kefernandez/SSB_ChargeInjection/Figures/ChargeInjection_Hardware_Declasify.png

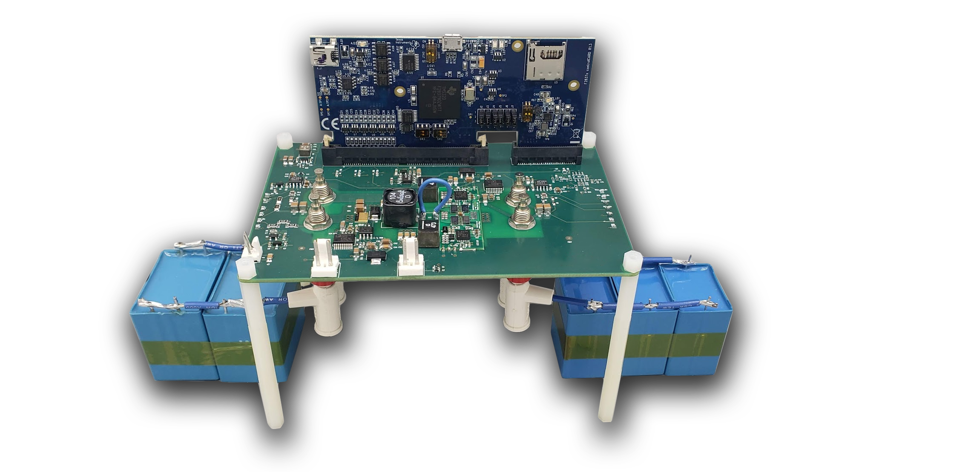
Figures/ChargeInjection_Hardware_Declasify.png
