kefernandez/SSB_ChargeInjection/Figures/Hardware_Diagram_labeled_declassify.png

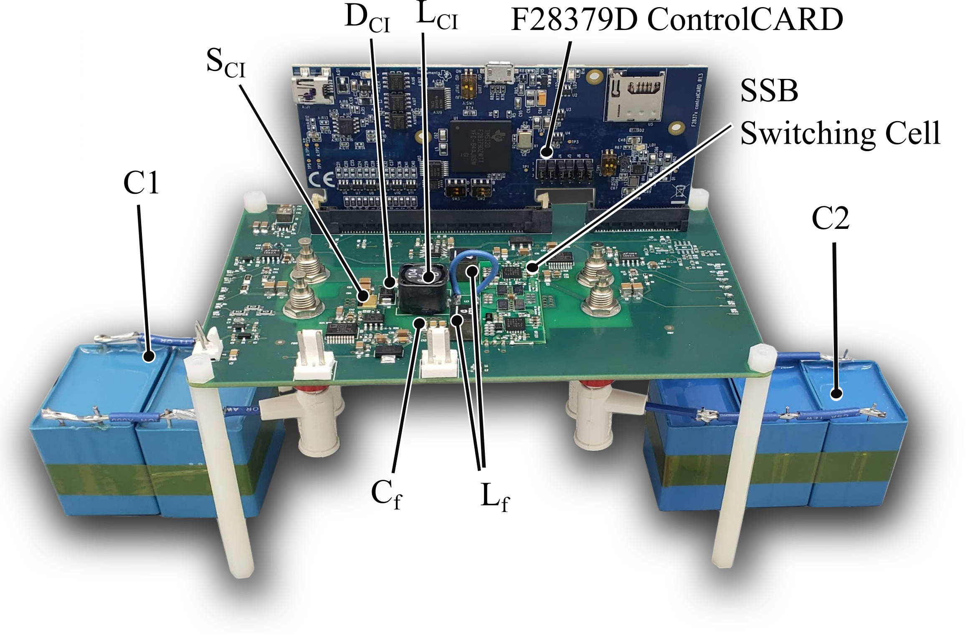
Figures/Hardware_Diagram_labeled_declassify.png
