kefernandez/SSB_ChargeInjection/Figures/Hardware_Diagram.pdf

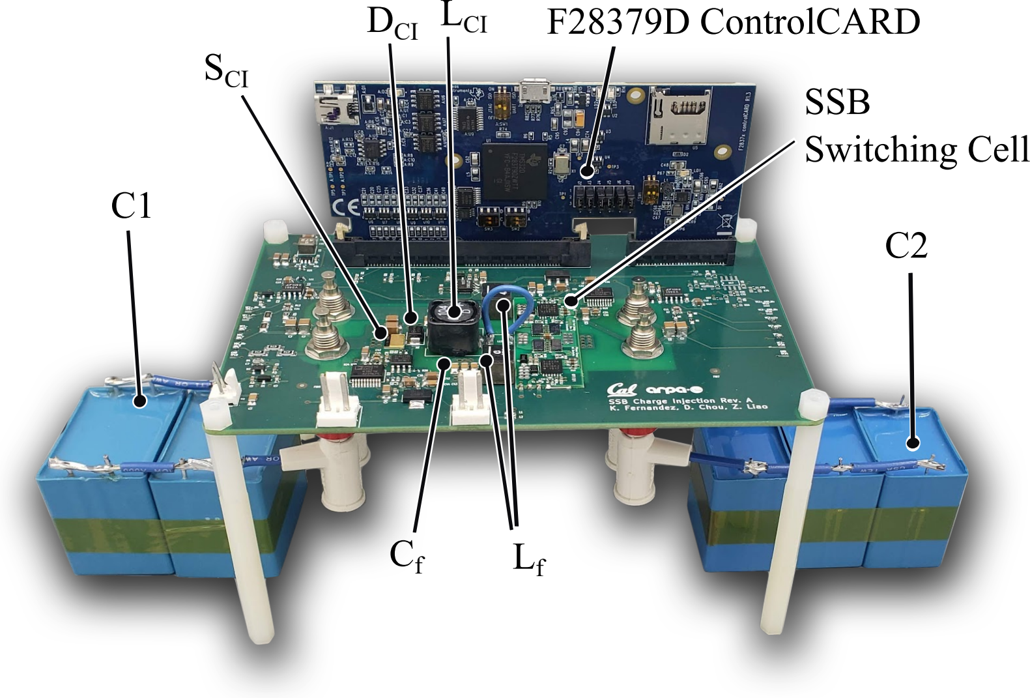
[picture p3: page 1]

F28379D ControlCARD

C2

C1

SCI

DCI LCI

Cf Lf

SSB
Switching Cell
