kefernandez/SSB_ChargeInjection/Graphics/Charge Injection/InkScape/ChargeInjection_Hardware.pdf

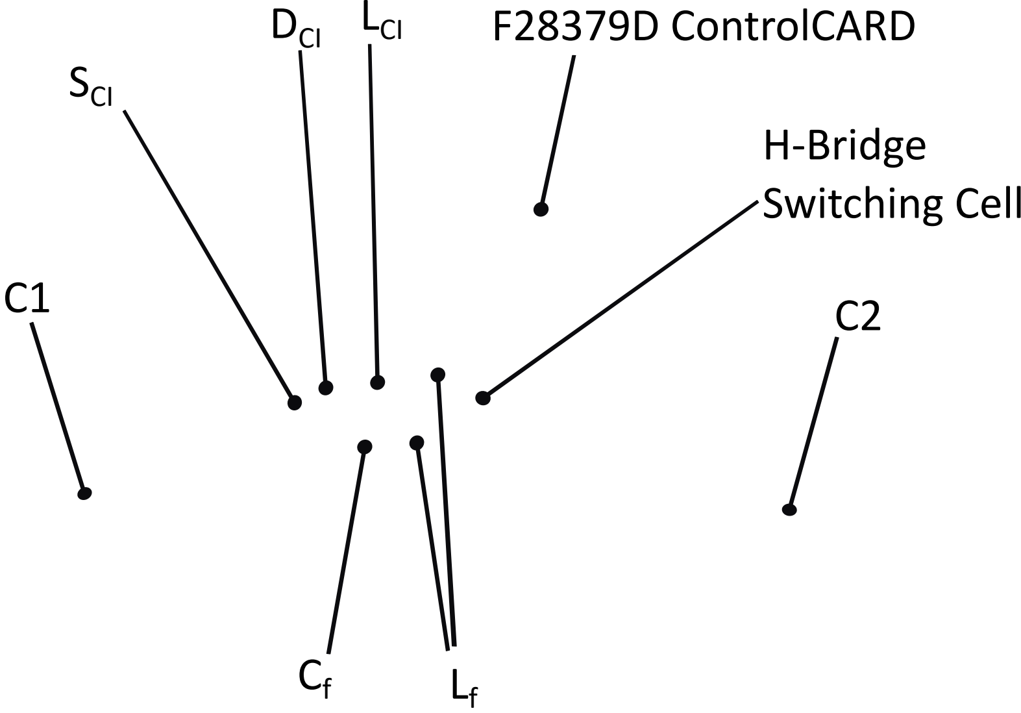
[picture p4: page 1]

F28379D ControlCARD

C2 C1

SCI

DCI | LCI
Cf | Lf

H-Bridge
Switching Cell
