kefernandez/SSB_ChargeInjection/Graphics/Charge Injection/Visio/singlephase_architecture.pdf

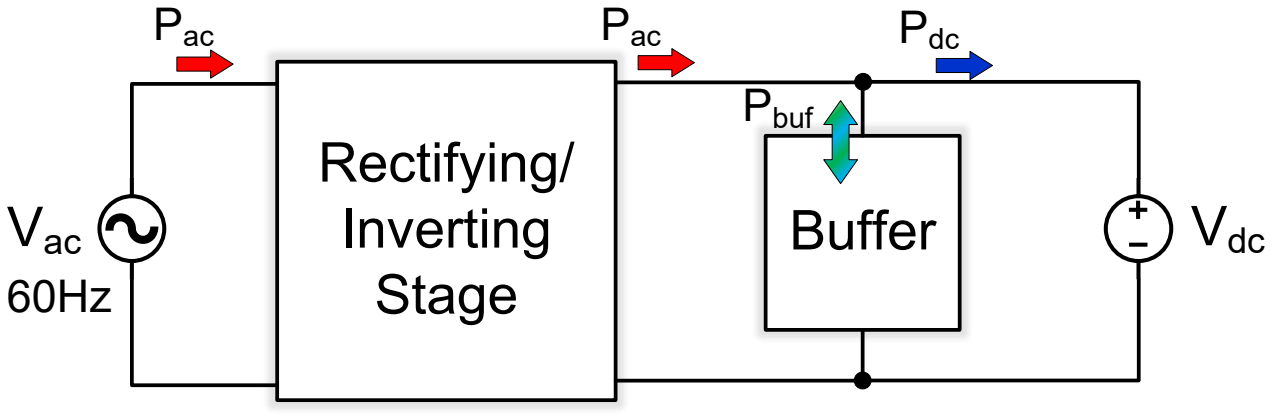
[picture p6: figure]
Rectifying/ Inverting Stage; Vac; Buffer; Vdc; Pac; Pbuf; Pdc
