kefernandez/SSB_ChargeInjection/Graphics/Charge Injection/Visio/SSB_Schematic_wave.pdf

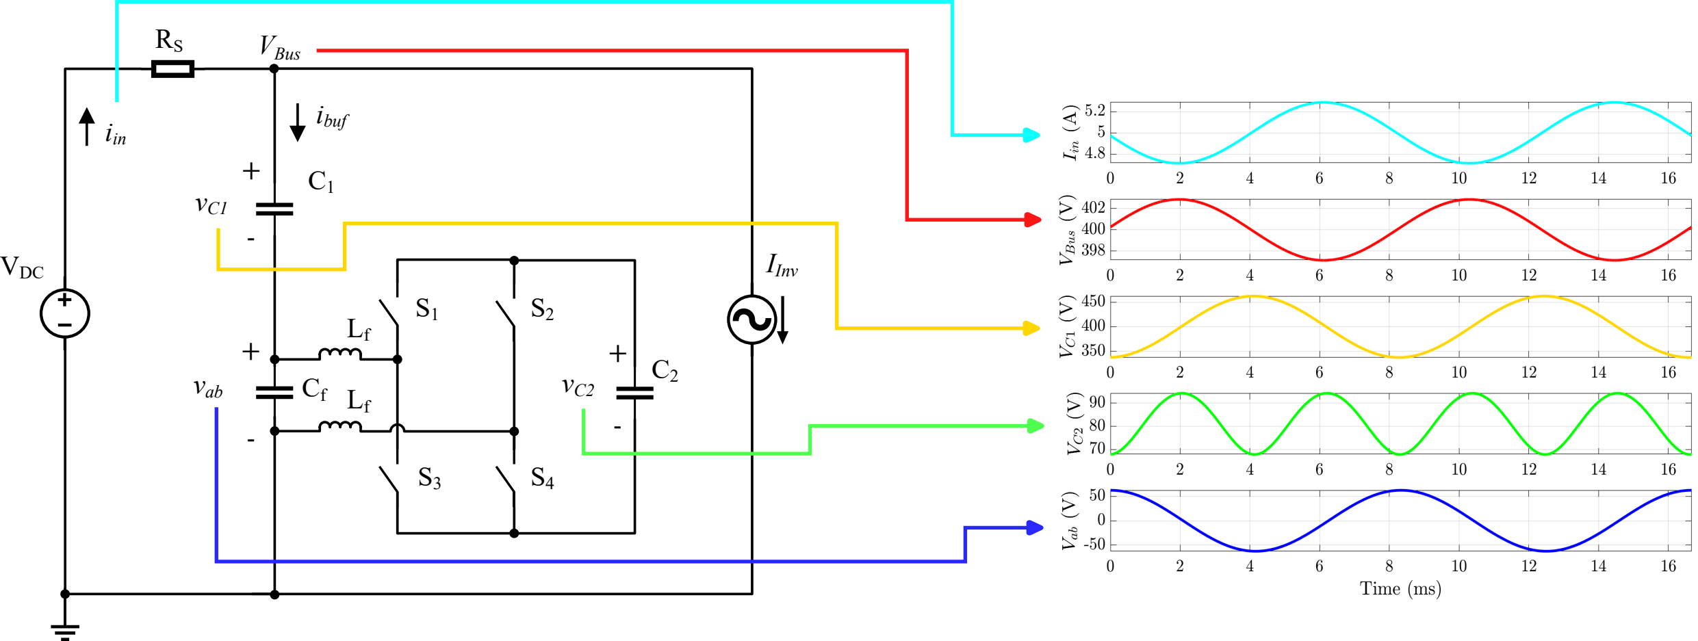
[picture p7: figure]
VDC; IInv; vab; VBus; ibuf iin
