kefernandez/SSB_ChargeInjection/Buffer/Buffer - Rev D Diagram.pdf

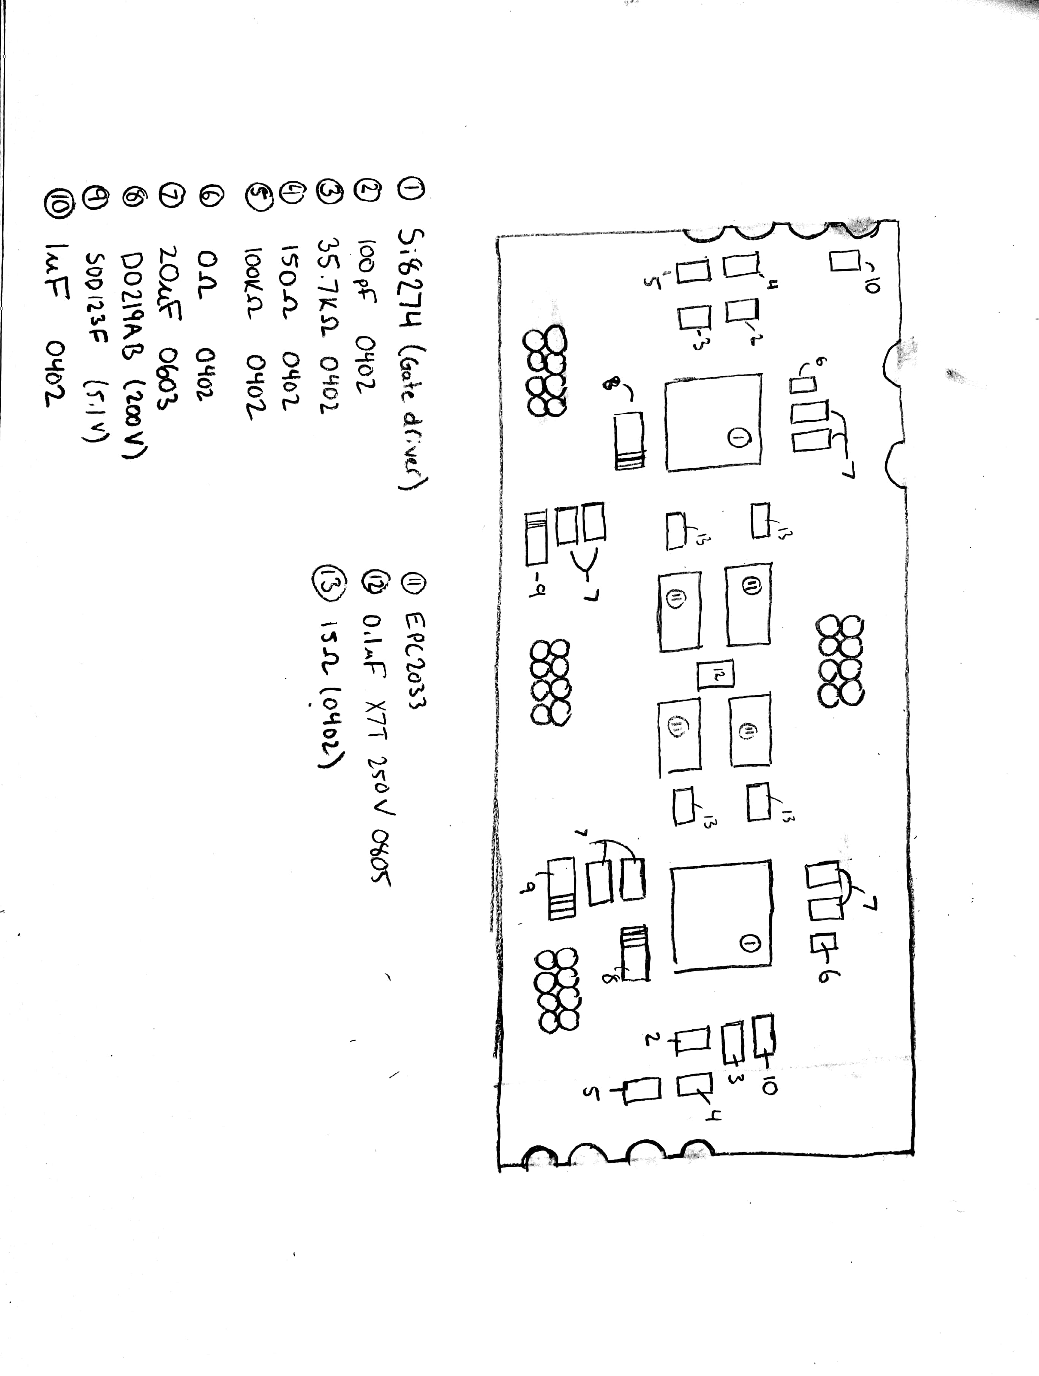
[picture p8: page 1]
