kefernandez/SSB_ChargeInjection/Graphics/Charge Injection/Visio/resistordivider.pdf

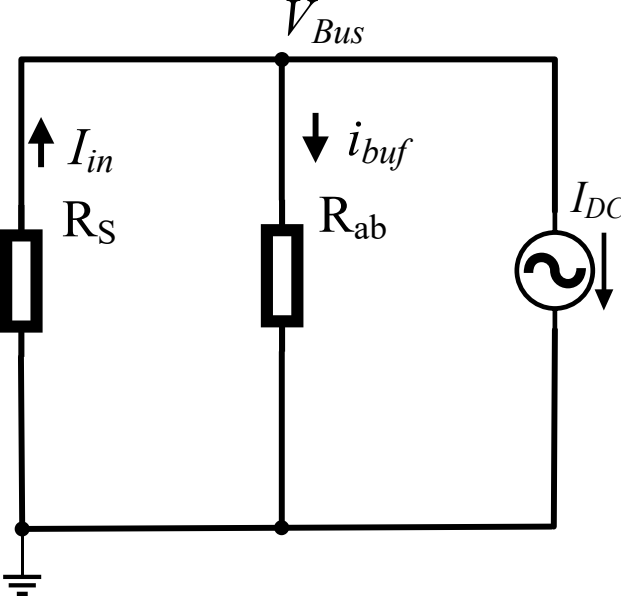
[picture p9: figure]
VBusibuf Rab; Iin

### IDC sin(ω2Lt )
