kefernandez/SSB_ChargeInjection/Graphics/Charge Injection/Visio/SSB_ResistorDivider.pdf

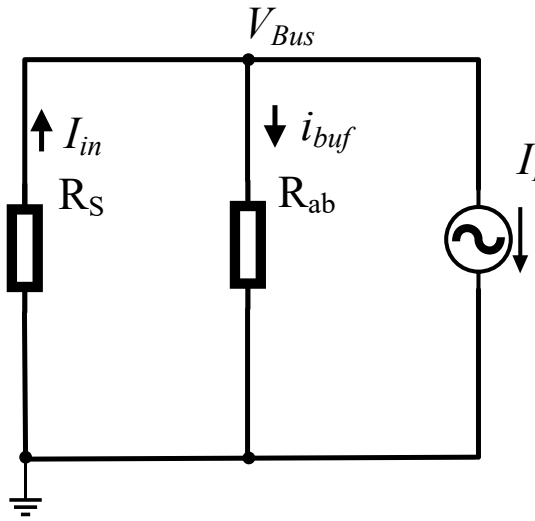
[picture p10: figure]
VBusibuf Rab; Iin

## IDC sin(ω

2

Lt )
