kefernandez/SSB_ChargeInjection/Graphics/Charge Injection/Visio/State0.pdf

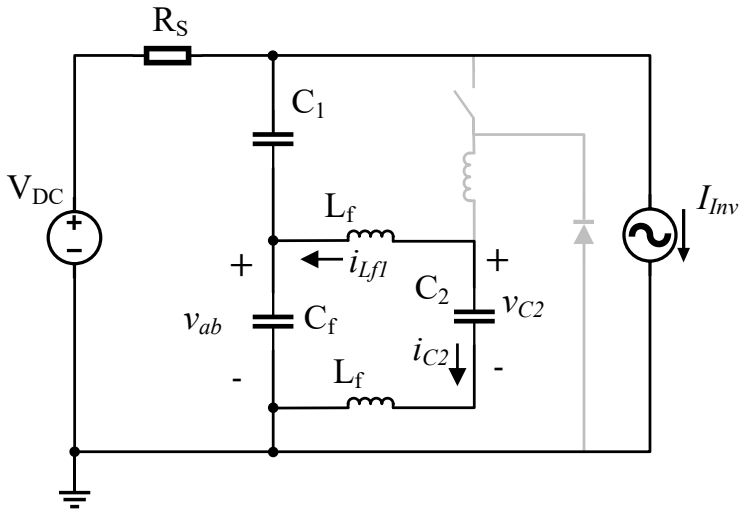
[picture p11: figure]
VDC; IInv; vab; iLf1
