kefernandez/SSB_ChargeInjection/Graphics/Charge Injection/Visio/State1.pdf

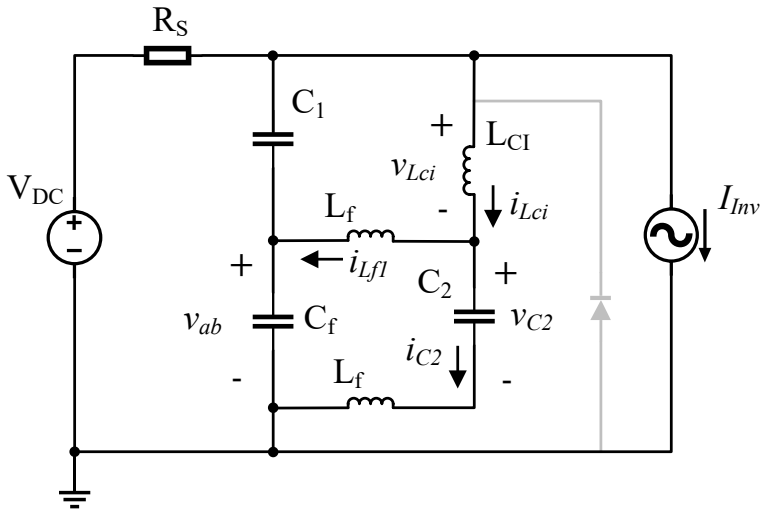
[picture p12: figure]
VDC; IInv; LCI; vab; iLci; vLci; iLf1
