kefernandez/SSB_ChargeInjection/Graphics/Charge Injection/Visio/State2.pdf

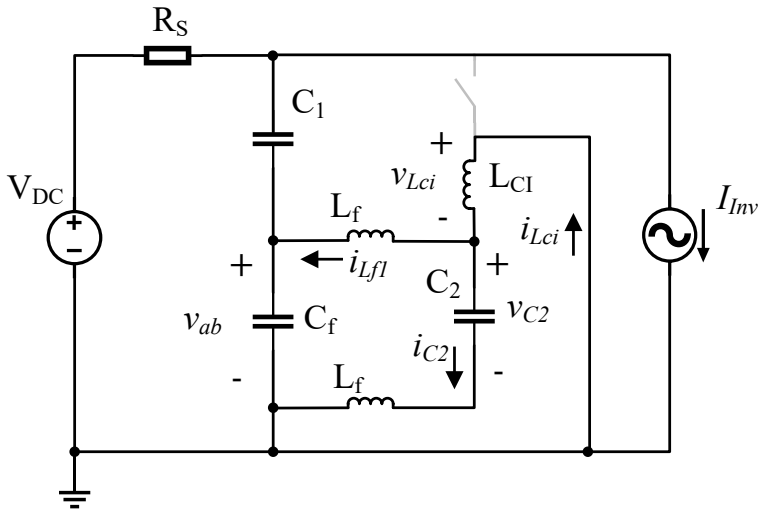
[picture p13: figure]
VDC; IInv; LCI; vab; iLci; vLci; iLf1
