kefernandez/SSB_ChargeInjection/Graphics/Charge Injection/Visio/State3.pdf

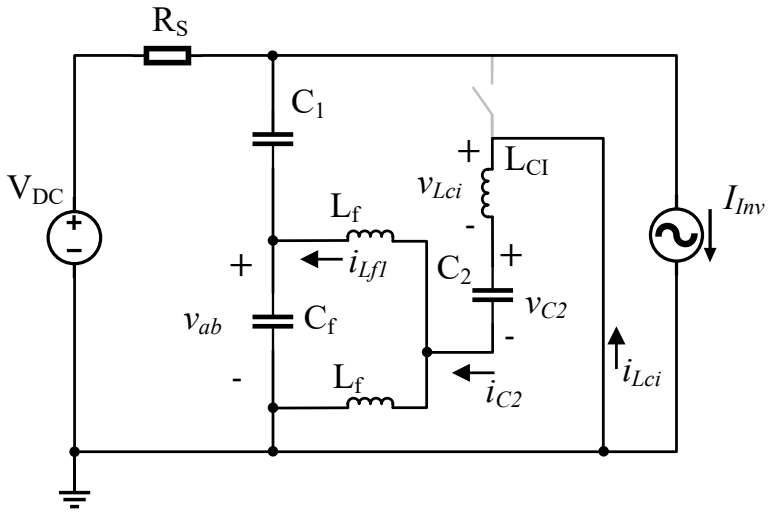
[picture p14: figure]
VDC; IInv; LCI; vab; iLci; vLci; iLf1
