kefernandez/SSB_ChargeInjection/Graphics/Charge Injection/Visio/State4.pdf

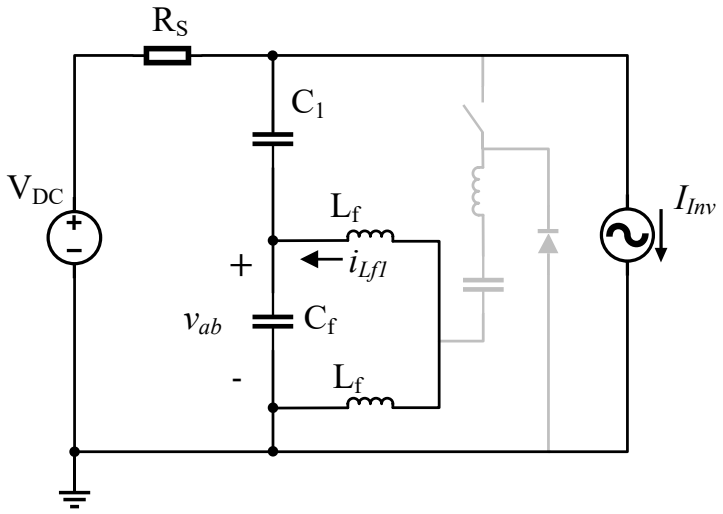
[picture p15: figure]
VDC; IInv; vab; iLf1
