kefernandez/SSB_ChargeInjection/Graphics/Charge Injection/InkScape/circuit with waveform/Phasor_SSB_LossComp.pdf

Im

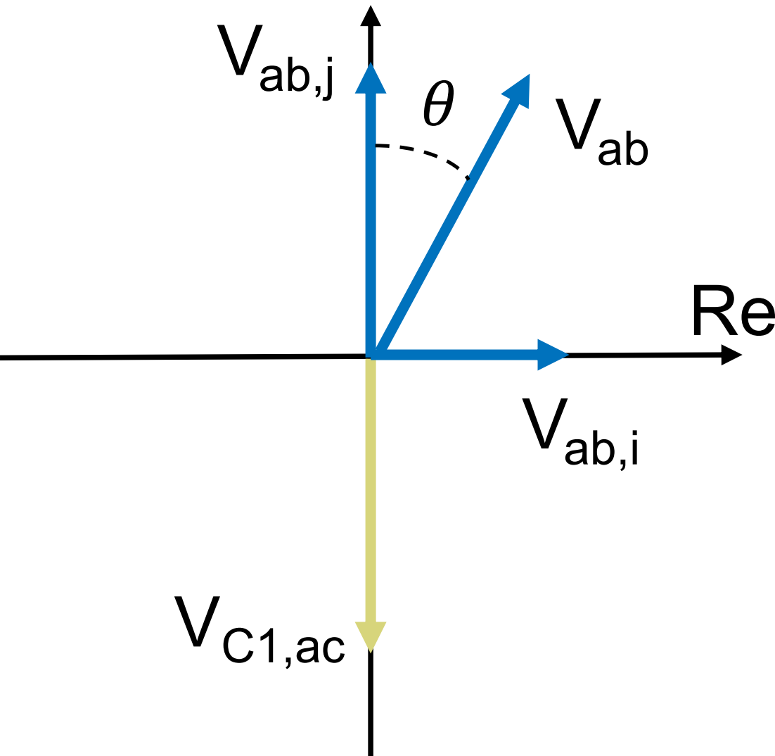
[picture p16: figure]
Vab,j; Vab,i; Vab
