kefernandez/SSB_ChargeInjection/Figures/ChargeInjection_Hardware_ps3.png

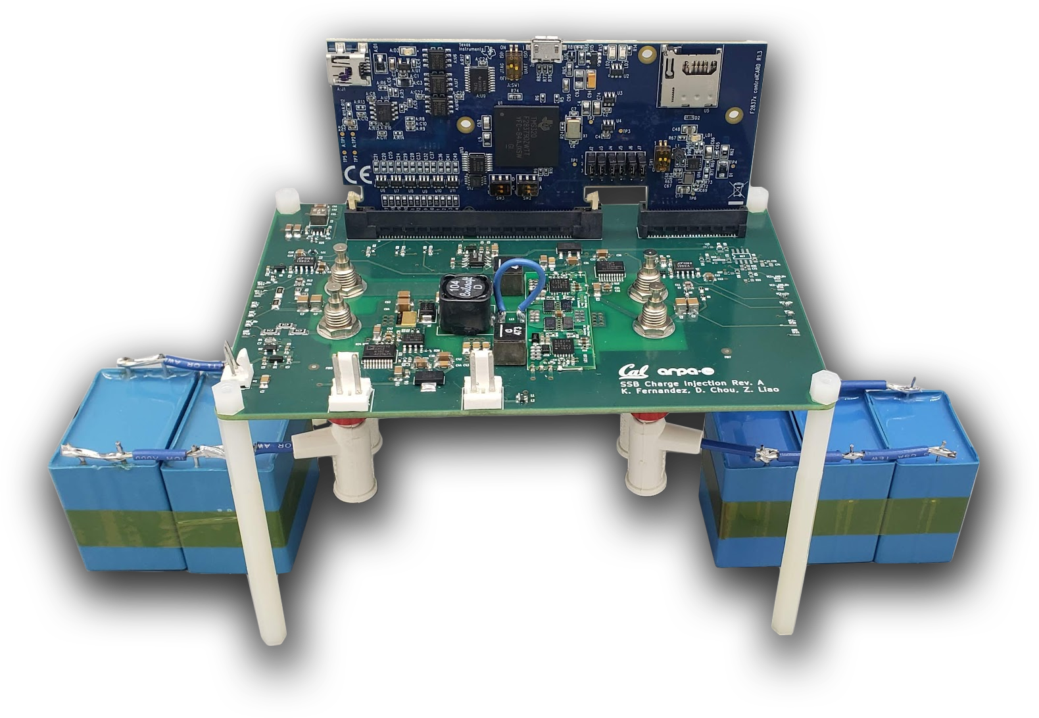
Figures/ChargeInjection_Hardware_ps3.png
