kefernandez/SSB_ChargeInjection/Figures/ChargeInjection_Hardware_ps.png

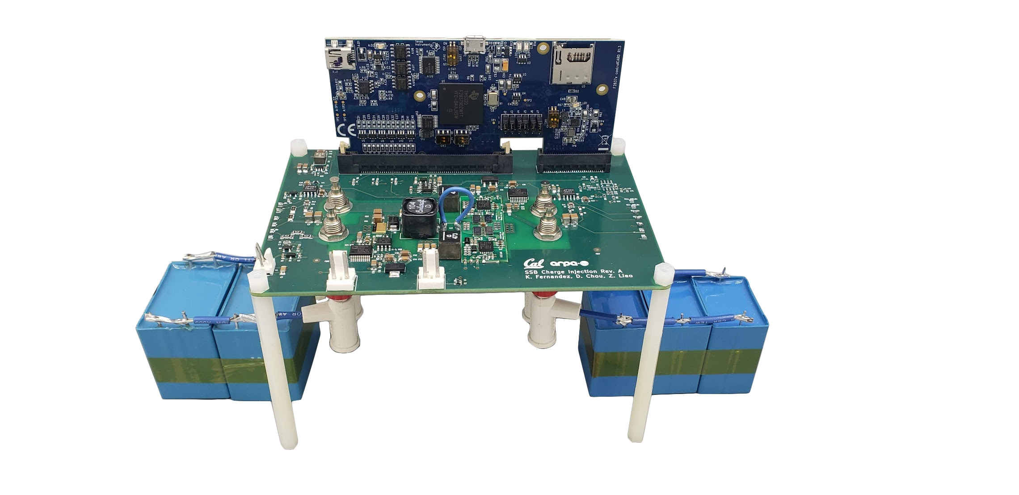
Figures/ChargeInjection_Hardware_ps.png
