kefernandez/SSB_ChargeInjection/Graphics/Charge Injection/InkScape/Hardware.png

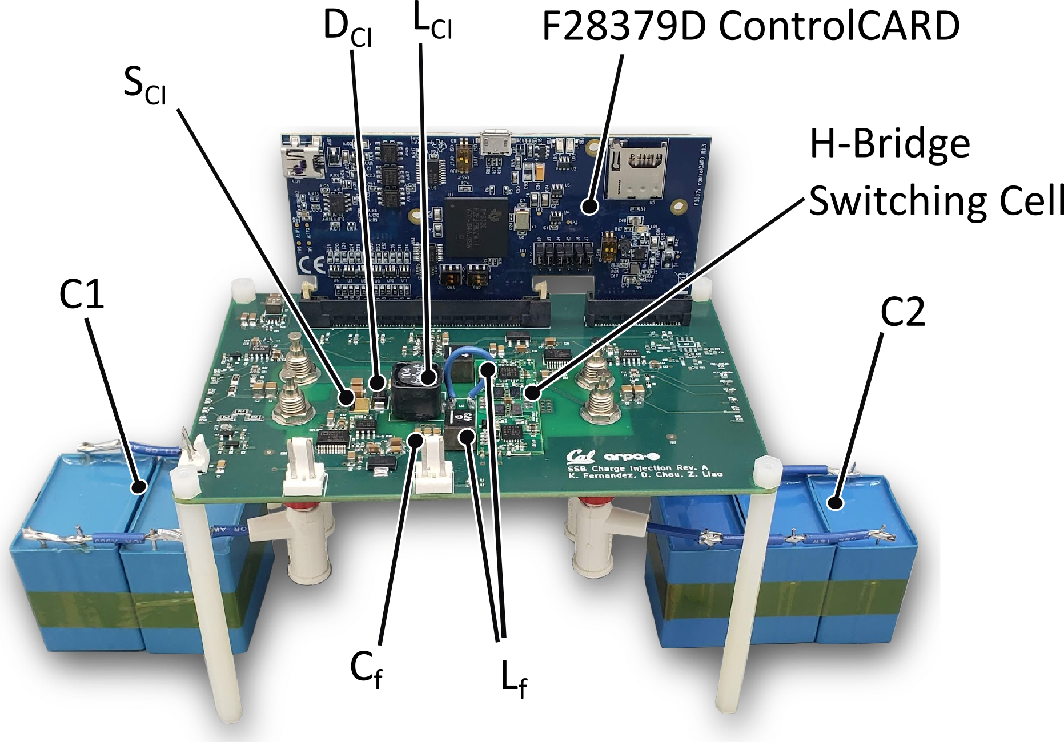
Graphics/Charge Injection/InkScape/Hardware.png
