kefernandez/SSB_ChargeInjection/Schematic and Layout/ChargeInjection_BOM.xlsx

References | Quantity | Quanitity Ordered | Value | Footprint | Max Voltage/Current | Supplier Part Number | MFG Part No. | Supplier | Temp Coefficient | Voltage Rating |  | Notes
C37 | 1 | 50 | 100pF | C_0402 | 5V | 478-12641-1-ND | 04025C101JAT2A | Digikey | X7R | 50V
C38 | 1 | 50 | 1uF | C_0402 | 5V | 1276-1513-1-ND | CL05B105KQ5NQNC | Digikey | X7R | 6.3V
C39 | 1 | 50 | 0.1uF | C_0402 | 5V | 1276-1002-1-ND | CL05B104KP5NNNC | Digikey | X7R | 10V
C5, C6, C8, C9, C12, C14, C15, C16, C17, C18, C20, C22, C23, C26, C32, C45, C68, C69, C71, C73, C78 | 21 | 100 | 1uF | C_0603 |  | 1276-1946-1-ND | CL10B105KP8NNNC | Digikey | X7R | 10V
C11, C21, C57, C58, C59, C67, C72, C75 | 8 | 50 | 100pF | C_0603 |  | 1276-1908-1-ND | CL10B101KB8NFNC | Digikey | X7R | 50V
C33, C34, C46, C47, C50, C51, C53 | 7 | 50 | 0.1uF | C_0603 |  | 1276-CL10B104KB8NNNLCT-ND | CL10B104KB8NNNL | Digikey | X7R | 50V
C25, C28 | 2 | 50 | 10uF | C_0603 | 6.5V | 490-14461-1-ND | GRM188D71A106KA73D | Digikey | X7T | 10V |  | Pricey
C7 | 1 | 50 | 1000pF | C_0603 | 2.8V | 1276-1018-1-ND | CL10B102KB8NNNC | Digikey | X7R | 50V
C10, C13, C19, C24, C70, C74 | 6 | 50 | 10uF | C_0805 | 6.5V | 1276-1764-1-ND | CL21B106KPQNNNE | Digikey | X7R | 10V
C27, C29, C31, C35, C36, C42, C44, C48, C49, C54, C56 | 11 | 50 | 10uF | C_1206 | 6.5V | 1276-6641-1-ND | CL31B106MOHNNNE | Digikey | X7R | 16V
C40, C41, C60, C61, C76, C77 | 6 | 50 | 1uF (C3) | C_1206 | 85V | 1276-1838-1-ND | CL31B105KCHNNNE | Digikey | X7R | 100V
C30, C43 | 2 | 30 | 0.1uF | C_1206 | 6.5V | 732-8086-1-ND | CAP CER 0.1UF 10V X7R 1206 | Digikey | X7R | 10V |  | Could have made this an 0805 or an 0603, will order some 0805s as well
C52, C55 | 2 | 30 | 22uF | C_1206 | 5V | 1276-3148-1-ND | CL31B226MPHNNNE | Digikey | X7R | 10V
C4 | 1 | 30 | 1uF | C_1206 | 6.5V | 478-12854-1-ND | 1206ZC105KAT2A | Digikey | X7R | 10V
C1, C2 | 2 | 50 | 0.1uF (C1_sense) | C_1210 | 500V | 399-15981-1-ND | C1210C104KBRACAUTO | Digikey | X7R | 630V
C3, C62 | 2 | 30 | 1uF (C2_sense) | C_1210 | 100V | 1276-1812-1-ND | CL32B105KCJNNNE | Digikey | X7R | 100V
C63, C64 | 2 |  | 0.1uF (Vbus_loop) | C_1210 | 400V | 399-15981-1-ND | C1210C104KBRACAUTO | Digikey | X7R | 630V
R28, R29, R30, R31, R38 | 5 | 30 | 499 | R_0402 |  | P499DCCT-ND | ERA-2AEB4990X | Digikey |  | 1/16W
R22, R26, R27 | 3 | 30 | 10k | R_0402 |  | MCS0402-10.0K-MFCT-ND | MCS0402MC1002FE000 | Digikey |  | 1/10W
R17, R23 | 2 | 20 | 30.9k | R_0402 | 16nA, 0.5 mW | P18022CT-ND | ERA-2ARB3092X | Digikey |  | 1/16W | 0.10%
R18, R24 | 2 | 20 | 9.53k | R_0402 | 16nA, 0.2mW | P17916CT-ND | ERA-2APB9531X | Digikey |  | 1/16W | 0.10%
R20, R32 | 2 | 30 | 0 | R_0402 |  | 541-0.0JCT-ND | CRCW04020000Z0ED | Digikey |  | 1/16W
R19 | 1 | 30 | 150 | R_0402 |  | P150DCCT-ND | ERA-2AEB151X | Digikey |  | 1/16W | 0.10%
R21 | 1 | 30 | 15 | R_0402 |  | P15DDCT-ND | ERA-2AKD150X | Digikey |  | 1/16W | 0.50%
R25 | 1 | 20 | 54.9k | R_0402 |  | YAG1452CT-ND | RT0402BRD0754K9L | Digikey |  | 1/16W | 0.10%
R5, R6, R8, R9, R33, R34, R36, R37 | 8 | 25 | 33k | R_0603 | 0.05W | P20143CT-ND | ERJ-PB3B3302V | Digikey |  | 1/5W | 0.10%
R4, R15, R16 | 3 | 30 | 10k | R_0603 | 0.8mW | P10KDBCT-ND | ERA-3AEB103V | Digikey |  | 1/10W | 0.10%
R7, R12, R35 | 3 | 30 | 2k | R_0603 | 0.5mW | RG16P2.0KBCT-ND | RG1608P-202-B-T5 | Digikey |  | 1/10W | 0.10%
R13, R14 | 2 | 20 | 16k | R_0805 | 0.04W | P16KDACT-ND | ERA-6AEB163V | Digikey |  | 1/8W | 0.10%
R1, R2, R3 | 3 | 30 | 470k | R_1206 | 0.04W | P470KBCCT-ND | ERA-8AEB474V | Digikey |  | 1/4W | 0.10%
R10, R11 | 2 | 30 | 150k | R_1206 | 0.35W | RHM150KAFCT-ND | ESR18EZPF1503 | Digikey |  | 1/2W | 0.10%
L3, L4, L5, L6, L11, L12, L14, L15, L16 | 9 | 50 | Ferrite | C_0603 | 0.00012 | 732-1592-1-ND | 742792641 | Digikey |  | 2A
L9 | 1 | 10 | 100uH | MSS1210 | 1.2A | 994-MSS1210-104KEB | MSS1210-104KEB | Mouser
L1, L2 | 2 |  | Bead | R_0603 |  | 732-1592-1-ND | 742792641 | Digikey
L7, L8, L17 | 3 | 20 | 47uH | XAL7070 |  | XAL7070-473MEC | XAL7070-473MEC | Coilcraft
L13 - DNP - Jumper | 0 | X | 100uH | XAL7070 |  |  |  | N/A
L10 - Derek has several in lab | 1 | X | 4.7uH | XEL4030 |  | 994-XAL7070-472MEB | XAL7070-472MEB | N/A
D1 | 1 | 15 | D | D_SMB |  | MURS160T3GOSCT-ND | MURS160T3G | Digikey
U9 | 1 | X | FullBridgeCell | Buffer Full Bridge
U4, U7, U17 | 3 | 12 | LT1990 | SOIC-8 |  | LT1990CS8#PBF-ND | LT1990CS8#PBF | Digikey
U8 | 1 | 6 | LTC1144 | SOIC-8 |  | LTC1144CS8#PBF-ND | LTC1144CS8#PBF | Digikey
U12 | 1 | 10 | Si8271 | SOIC-8 |  | 336-3533-5-ND | SI8271GB-IS | Digikey
U5, U6, U16 | 3 | 15 | REF3012 | SOT-23 |  | 296-32213-1-ND | REF3012AIDBZR | Digikey
U1, U3 | 2 | 12 | TLV760 - 5V | SOT-23 |  | 296-48333-1-ND | TLV76050DBZR | Digikey
 | 2 | 12 | TLV760 - 3.3V | SOT-23 |  | 296-47016-1-ND | TLV76033DBZT | Digikey
U2 | 1 | 6 | LTC2050_+ | SOT-23-5 |  | LTC2050CS8#PBF-ND | LTC2050CS8#PBF | Digikey
U15 | 1 | 10 | TPS562200 | SOT-23-6 |  | 296-39631-1-ND | TPS562200DDCR | Digikey
U10, U13 | 2 | 10 | LM2937xMP | SOT223-4 |  | LM2937IMP-5.0/NOPBCT-ND | LM2937IMP-5.0/NOPB | Digikey
U11, U14 | 2 | 6 | ADuM5010 | SSOP-20_Wide |  | ADUM5010ARSZ-RL7CT-ND | ADUM5010ARSZ-RL7 | Digikey
TP5, TP6, TP7, TP8, TP9, TP10, TP11, TP12, TP13, TP14, TP15, TP16, TP17, TP18, TP19, TP20, TP21, TP22, TP23, TP24, TP25 | 21 | 80 | TestPoint | 0603 TP |  | A106145CT-ND | RCU-0C | Digikey
TP1, TP2, TP3, TP4 | 4 | 10 | TP | Banana_Jack_1Pin |  | BKCT2232-2-ND | CT2232-2 | Digikey
Q1 | 1 | 10 | NFET_GaNSystems | GS66506T |  | 499-GS66506T-MR | GS66506T-MR | Mouser
J1, J2 | 2 | 6 | Conn_01x02 | MTA156_2pin |  | A105038-ND | 3-641209-4 | Digikey
J3 | 1 | 5 | Conn_01x02 | Molex_KK-254_AE-6410-02A_1x02_P2.54mm_Vertical |  | A26564-ND | 1-87215-0 | Digikey
J4 | 1 | 2 | HSEC8-160-1-L-DV-A-BL | SAMTEC_HSEC8-160-01-L-DV-A-BL |  | SAM9083-ND | HSEC8-160-01-L-DV-A-BL | Digikey
J5 | 1 | 2 | HSEC8-130-01-L-DV-A | SKT-60_flipped |  | SAM9080-ND | HSEC8-130-01-L-DV-A | Digikey
C_1 | 2 | 2 | C1 |  |  | 495-3956-ND | B32776G4406K000
C_2 | 3 | 3 | C2 |  |  | 495-4131-ND | B32524Q1686K000
MCU | 1 | 1 | ControlCARD |  |  | 296-46777-ND | TMDSCNCD28379D
