kefernandez/SSB_ChargeInjection/Buffer/BufferRevDGerbers_10-23-2021/BufferRevD_BOM_10-23-2021_NoGatedrive.xlsx

Column | References | Value | Footprint | Quantity | MfgPN | Supplier | Supplier Part Number | DNP
1 | C1, C12 | 1uF, 6.3V, 0402 | C_0402 | 2 | CL05B105KQ5QNWC | Mouser | 187-CL05B105KQ5QNWC
2 | C3, C10 | 100pF, 16V, 0402 | C_0402 | 2 | 0402YC101KAT2A | Digikey | 478-7887-1-ND
3 | C2, C4, C8, C11 | 1uF, 16 V, 0603 | C_0603 | 4 | C1608X7R1C105K080AC | Digikey | 445-1604-1-ND
4 | C5, C6, C7, C9 | 22uF, 6.3 V, X5R | C_0603 | 4 | C0603C226M9PACTU | Mouser | 80-C0603C226M9PACTU
6 | R6, R7, R8, R9 | 15, 0402 | R_0402 | 4 | ERJ-PA2F15R0X | Digikey | P17213CT-ND
7 | R1, R3 | 35.7k | R_0402 | 2 | RP73PF1E35K7BTD | Digikey | A127468CT-ND
8 | R2, R13 | 150 | R_0402 | 2 | RC0402FR-07150RL | Digikey | 311-150LRCT-ND
9 | R4, R11 | 100k | R_0402 | 2 | RN73H1ETTP1003B25 | Digikey | 2019-RN73H1ETTP1003B25CT-ND
10 | R5, R10 | 0 Ohm | R_0402 | 2 | SFR01MZPJ000 | Digikey | 511-1816-1-ND
11 | D1, D6 | D | DO-219AB | 2 | VS-2EFH02HM3/I | Digikey | VS-2EFH02HM3/IGICT-ND
12 | D2, D3, D4, D5 | DNP | D_0402 | 4 | DNP | Digikey | DNP | DNP
13 | D7, D8 | D_ZENER | SOD-123F | 2 | SMF5.0A_R1_00001 | Digikey | 3757-SMF5.0A_R1_00001CT-ND
14 | U1, U2 | Si8274 | Si8274 | 2 | DNP | DNP | DNP | DNP
15 | C | 0.1uF | C_0805 | 1 | C2012X7T2E104M125AE | Digikey | 445-6808-1-ND
16 | Q1, Q2, Q3, Q4 | NFET_EPC2 | EPC_EPC203x_BGA-24 | 4 | EPC2033 | Digikey | 917-1131-1-ND
