kefernandez/SSB_ChargeInjection/Buffer/Quote Documents/BufferRevD_BOM.xlsx

Column | References | Value | Footprint | Quantity | Total quantity | MfgPN | Supplier | Supplier Part Number | DNP
1 | C1, C12 | 1uF, 6.3V, 0402 | C_0402 | 2 | 40 | CL05B105KQ5NQNC | Digikey | 1276-1513-1-ND
2 | C3, C10 | 100pF, 16V, 0402 | C_0402 | 2 | 40 | 0402YC101KAT2A | Digikey | 478-7887-1-ND
3 | C2, C4, C8, C11 | 1uF, 16 V, 0603 | C_0603 | 4 | 80 | C0603C105K4RACTU | Digikey | 399-7847-1-ND
4 | C5, C6, C7, C9 | 22uF, 6.3 V, X5R | C_0603 | 4 | 80 | CL10A226MQ8NRNC | Digikey | 1276-1193-1-ND
6 | R6, R7, R8, R9 | 15, 0402 | R_0402 | 4 | 80 | ERJ-PA2F15R0X | Digikey | P17213CT-ND
7 | R1, R3 | 35.7k | R_0402 | 2 | 40 | RP73PF1E35K7BTD | Digikey | A127468CT-ND
8 | R2, R13 | 150 | R_0402 | 2 | 40 | RP73PF1E150RBTD | Digikey | A127240CT-ND
9 | R4, R11 | 100k | R_0402 | 2 | 40 | MCS04020C1003FE000 | Digikey | MCS0402-100K-CFCT-ND
10 | R5, R10 | 0 Ohm | R_0402 | 2 | 40 | 541-0.0JCT-ND | Digikey | CRCW04020000Z0ED
11 | D1, D6 | D | DO-219AB | 2 | 40 | VS-1EFH02HM3/I | Digikey | VS-1EFH02HM3/IGICT-ND
12 | D2, D3, D4, D5 | DNP | D_0402 | 4 | 80 | DNP | Digikey | DNP | DNP
13 | D7, D8 | D_ZENER | SOD-123F | 2 | 40 | SMF5.0A | Digikey | F5748CT-ND
14 | U1, U2 | Si8274 | Si8274 | 2 | 40 | SI8274GB1-IM1 | Digikey | 336-5930-ND
15 | C | 0.1uF | C_0805 | 1 | 20 | C2012X7T2E104K125AA | Digikey | 445-C2012X7T2E104K125AACT-ND
16 | Q1, Q2, Q3, Q4 | NFET_EPC2 | EPC_EPC203x_BGA-24 | 4 | 80 | EPC2033 | Digikey | 917-1131-1-ND
 |  |  |  |  | 0
