kefernandez/SSB_ChargeInjection/Buffer/calisco-hw-libs/solid-models/SILABS_SOIC-8_NB.STEP

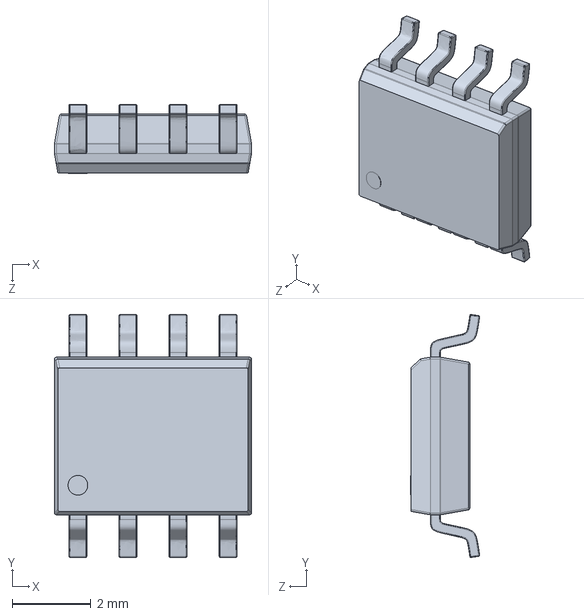
[picture p20: CAD file, 2021-04-21]
Buffer/calisco-hw-libs/solid-models/SILABS_SOIC-8_NB.STEP
5.00 x 6.16 x 1.76 mm
