kefernandez/SSB_ChargeInjection/Buffer/kicad-library/pcb/user_mb/GS1008T.step

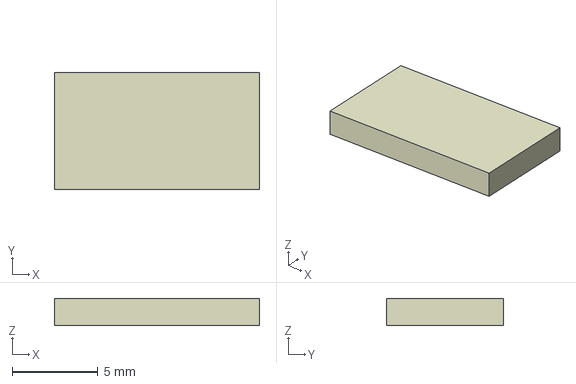
[picture p21: CAD file, 2021-04-21]
Buffer/kicad-library/pcb/user_mb/GS1008T.step
11.9 x 6.80 x 1.58 mm
