kefernandez/SSB_ChargeInjection/Buffer/kicad-library/solid-models/IHLP6767DZ.STEP

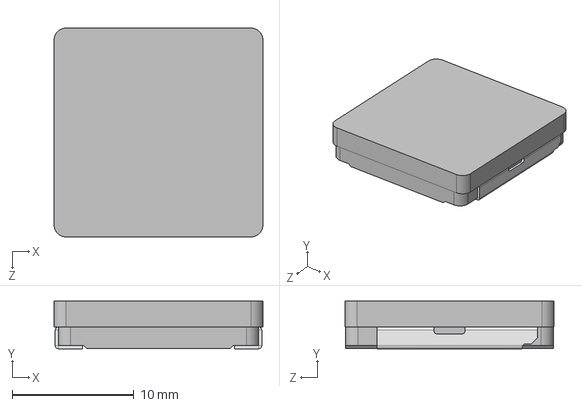
[picture p22: CAD file, 2021-04-21]
Buffer/kicad-library/solid-models/IHLP6767DZ.STEP
17.2 x 3.91 x 17.2 mm
