kefernandez/SSB_ChargeInjection/Buffer/Test Project/calisco-hw-libs/solid-models/soic-8_150mil.STEP

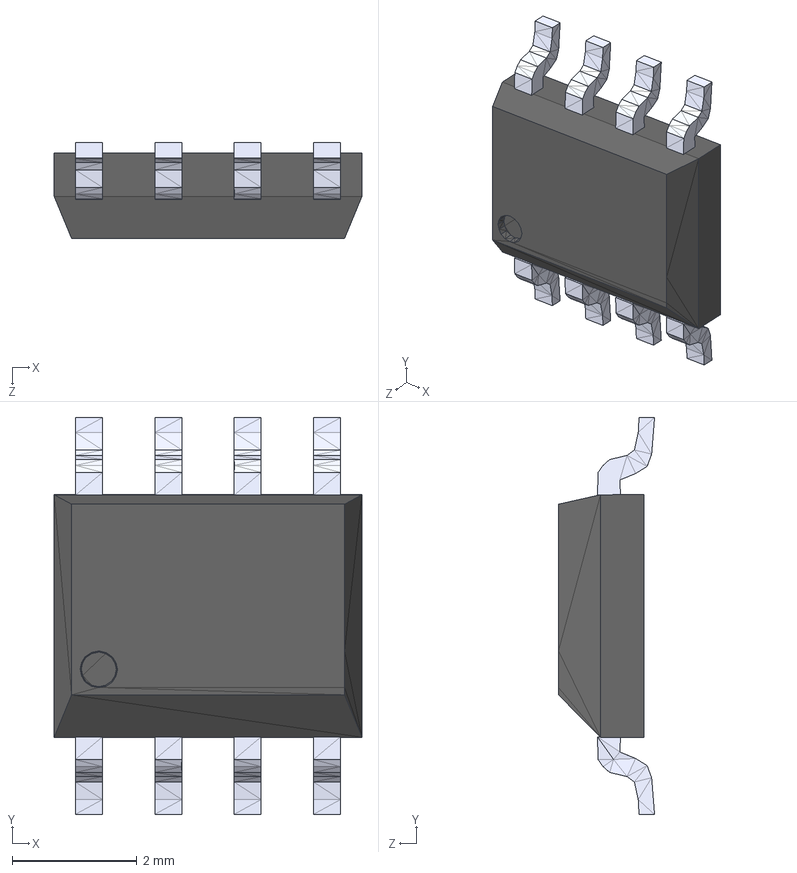
[picture p23: CAD file, 2021-04-21]
Buffer/Test Project/calisco-hw-libs/solid-models/soic-8_150mil.STEP
4.93 x 6.35 x 1.54 mm
