kefernandez/SSB_ChargeInjection/Buffer/Test Project/kicad-library/solid-models/VISHAY_IHLP6767.STEP

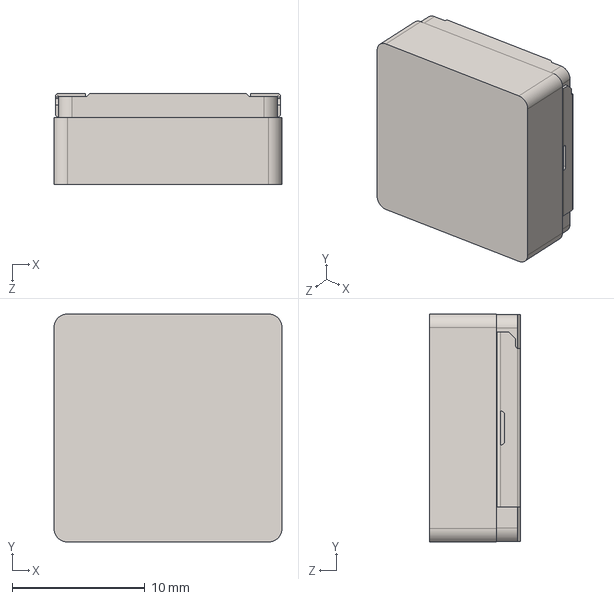
[picture p24: CAD file, 2021-04-21]
Buffer/Test Project/kicad-library/solid-models/VISHAY_IHLP6767.STEP
17.2 x 17.2 x 6.88 mm
