kefernandez/SSB_ChargeInjection/calisco-hw-libs/solid-models/ISC0.STEP

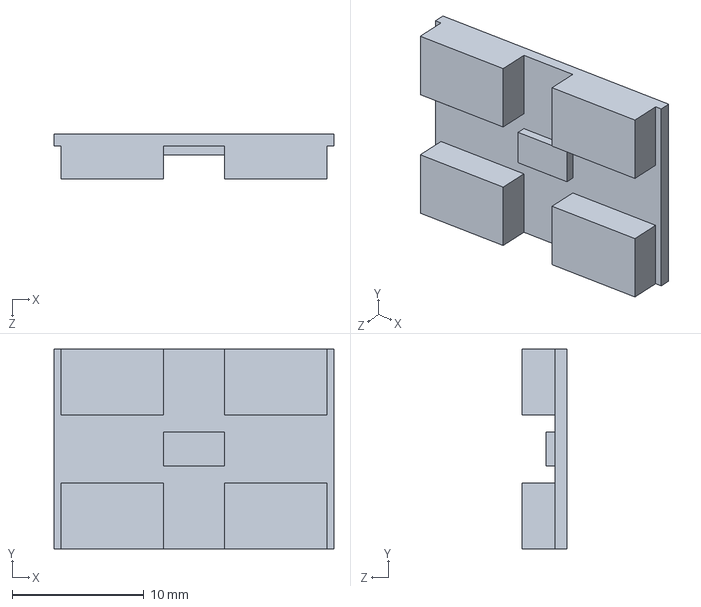
[picture p25: CAD file, 2021-04-21]
calisco-hw-libs/solid-models/ISC0.STEP
21.2 x 15.2 x 3.40 mm
