kefernandez/SSB_ChargeInjection/kicad-library/solid-models/TI_LM5113T_BGA-12.STEP

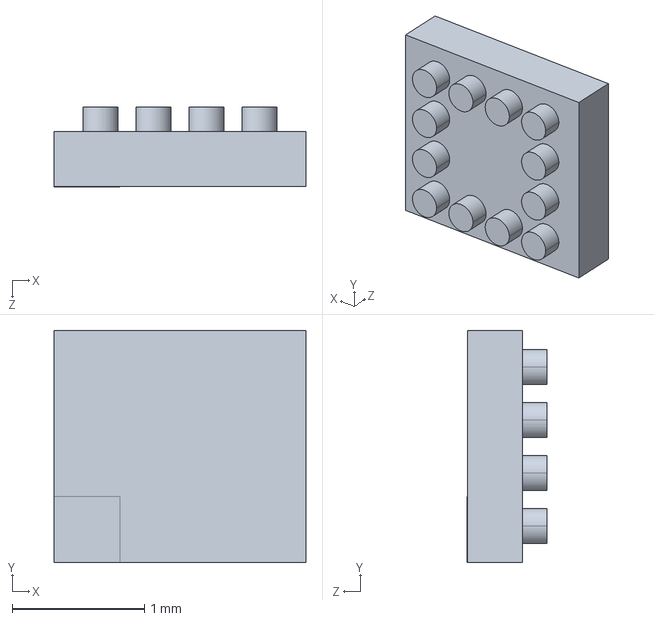
[picture p26: CAD file, 2021-04-21]
kicad-library/solid-models/TI_LM5113T_BGA-12.STEP
1.91 x 1.76 x 0.601 mm
