kefernandez/SSB_ChargeInjection/Buffer/calisco-hw-libs/solid-models/TDK_C5750-2mm5.STEP

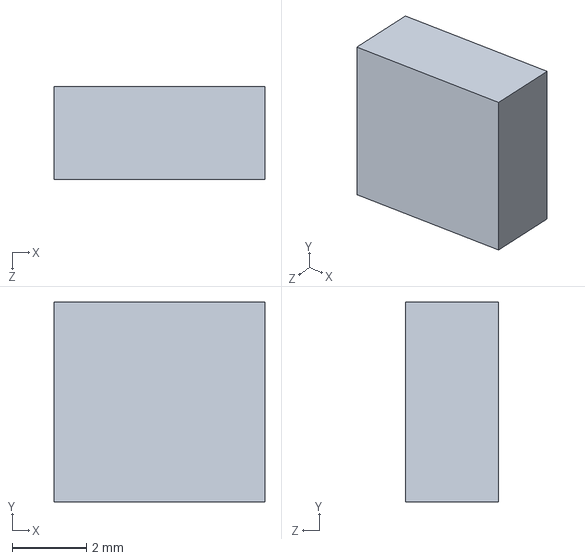
[picture p27: CAD file, 2021-04-21]
Buffer/calisco-hw-libs/solid-models/TDK_C5750-2mm5.STEP
5.70 x 5.40 x 2.50 mm
