kefernandez/SSB_ChargeInjection/Buffer/kicad-library/solid-models/Coilcraft-XEL4030-472.STEP

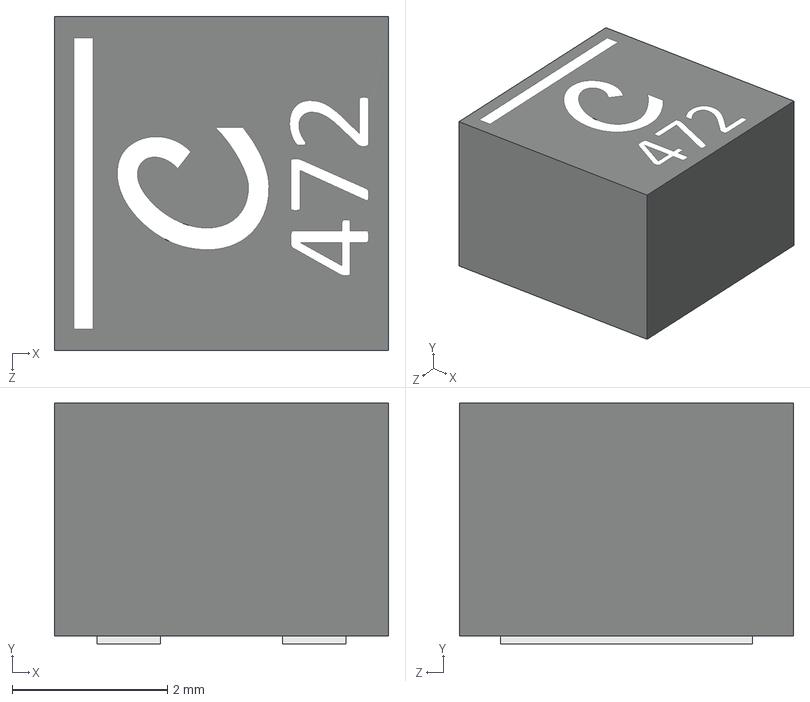
[picture p28: CAD file, 2021-04-21]
Buffer/kicad-library/solid-models/Coilcraft-XEL4030-472.STEP
4.30 x 3.10 x 4.30 mm
