kefernandez/SSB_ChargeInjection/Buffer/Test Project/calisco-hw-libs/solid-models/VISHAY_CRCW2512.STEP

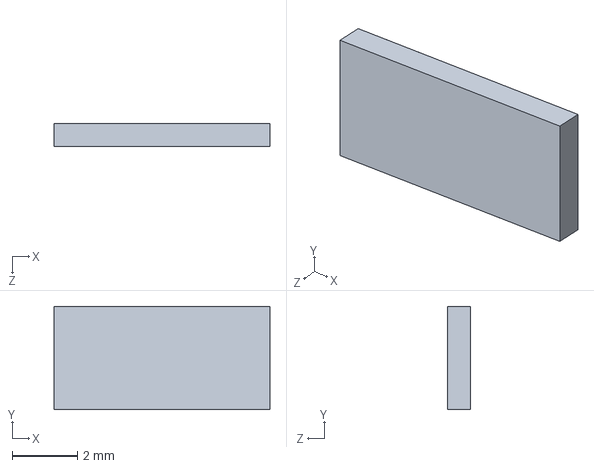
[picture p29: CAD file, 2021-04-21]
Buffer/Test Project/calisco-hw-libs/solid-models/VISHAY_CRCW2512.STEP
6.60 x 3.15 x 0.7 mm
