kefernandez/SSB_ChargeInjection/calisco-hw-libs/solid-models/SOT-23-6.STEP

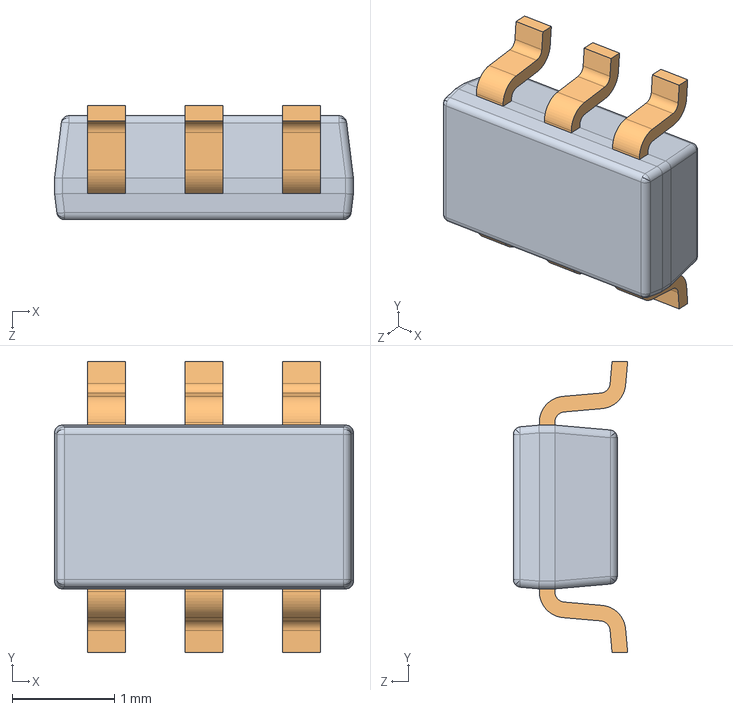
[picture p30: CAD file, 2021-04-21]
calisco-hw-libs/solid-models/SOT-23-6.STEP
2.92 x 2.84 x 1.12 mm
BODY_MF06A
LEAD_MF06A x 6
