kefernandez/SSB_ChargeInjection/Buffer/Test Project/calisco-hw-libs/solid-models/TDK_C1608-0mm8.STEP

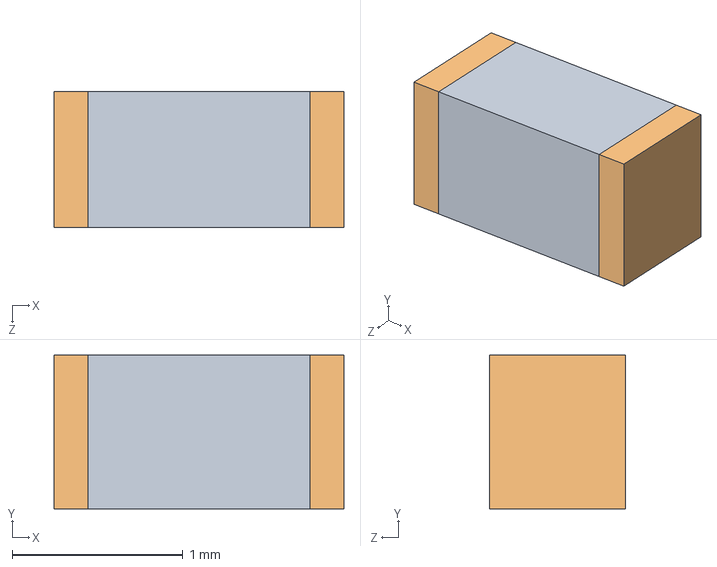
[picture p31: CAD file, 2021-04-21]
Buffer/Test Project/calisco-hw-libs/solid-models/TDK_C1608-0mm8.STEP
1.70 x 0.9 x 0.8 mm
