kefernandez/SSB_ChargeInjection/Buffer/Test Project/kicad-library/solid-models/XAL7070.STEP

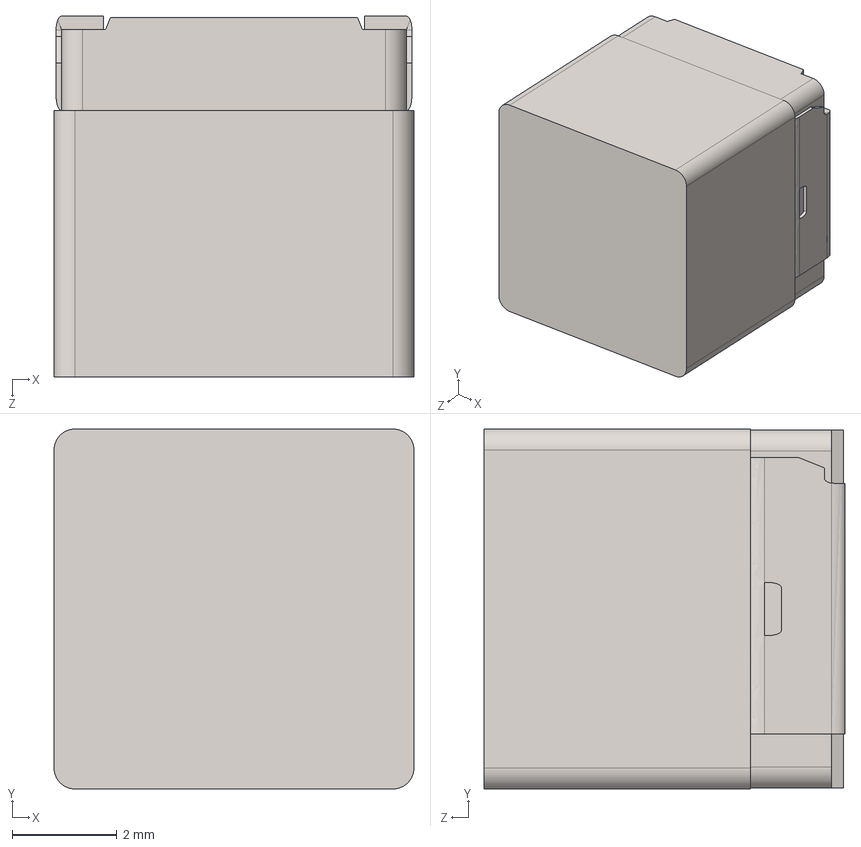
[picture p32: CAD file, 2021-04-21]
Buffer/Test Project/kicad-library/solid-models/XAL7070.STEP
6.87 x 6.87 x 6.88 mm
