kefernandez/SSB_ChargeInjection/calisco-hw-libs/solid-models/TDK_C3216-1mm60.STEP

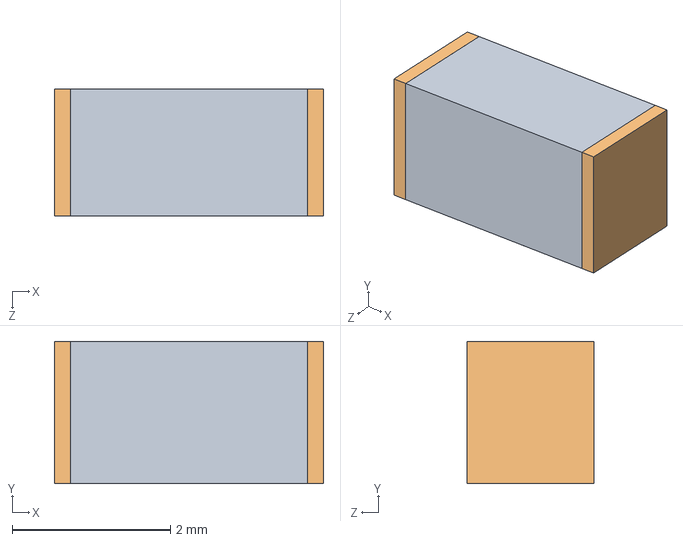
[picture p33: CAD file, 2021-04-21]
calisco-hw-libs/solid-models/TDK_C3216-1mm60.STEP
3.40 x 1.80 x 1.60 mm
