kefernandez/SSB_ChargeInjection/Buffer/calisco-hw-libs/solid-models/TDK_C2012-1mm25.STEP

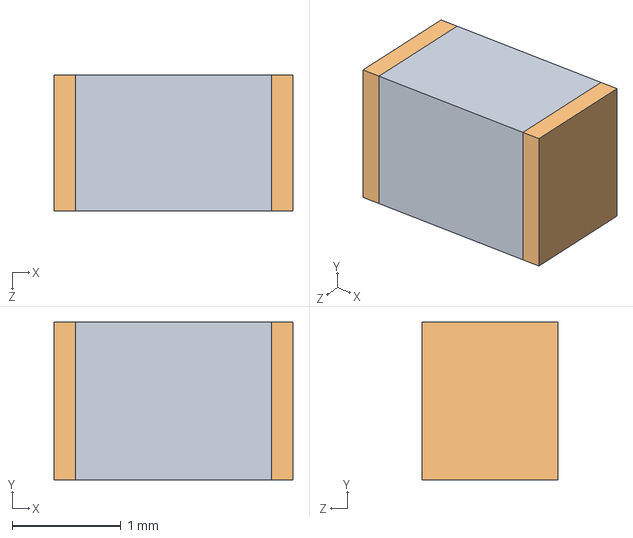
[picture p34: CAD file, 2021-04-21]
Buffer/calisco-hw-libs/solid-models/TDK_C2012-1mm25.STEP
2.20 x 1.45 x 1.25 mm
