kefernandez/SSB_ChargeInjection/Buffer/kicad-library/solid-models/cap_2220.STEP

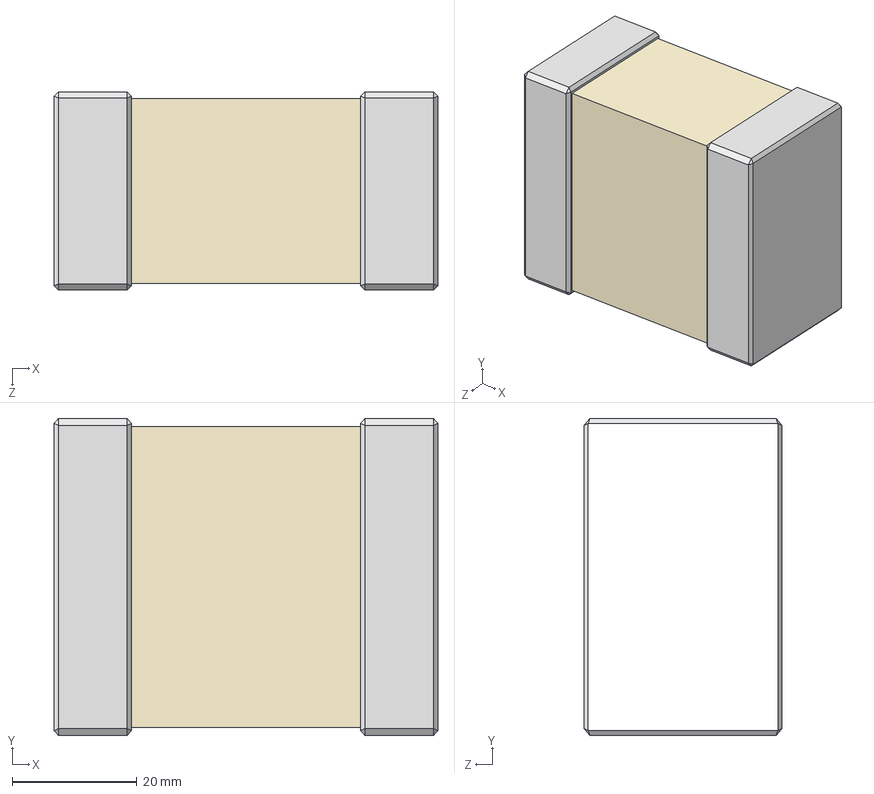
[picture p35: CAD file, 2021-04-21]
Buffer/kicad-library/solid-models/cap_2220.STEP
61.5 x 50.8 x 31.8 mm
