kefernandez/SSB_ChargeInjection/Buffer/Test Project/calisco-hw-libs/solid-models/cap_2220.STEP

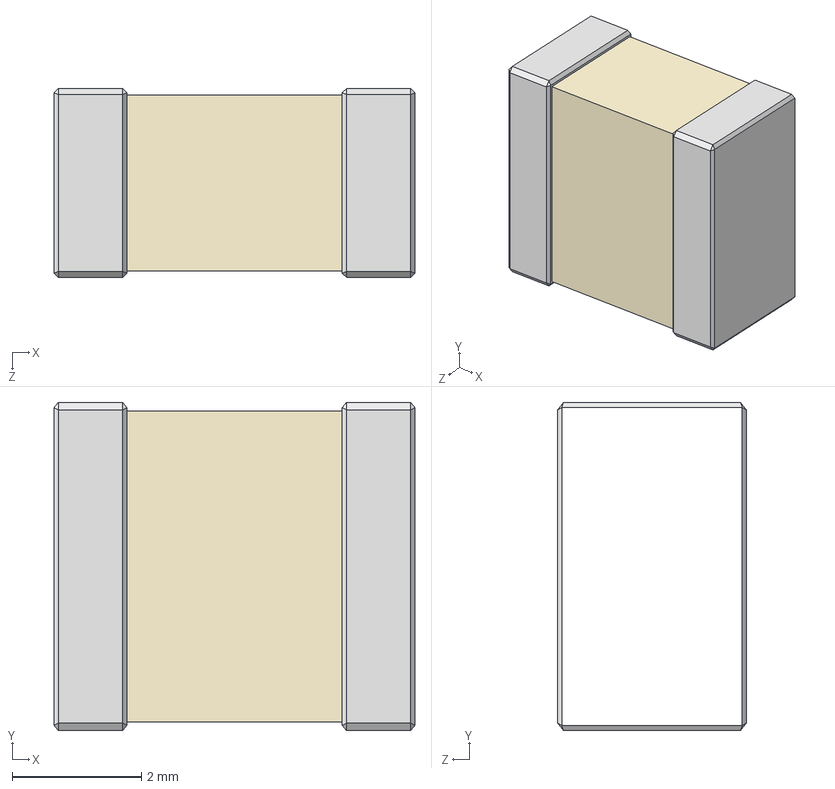
[picture p36: CAD file, 2021-04-21]
Buffer/Test Project/calisco-hw-libs/solid-models/cap_2220.STEP
5.59 x 5.08 x 2.92 mm
