kefernandez/SSB_ChargeInjection/Buffer/Test Project/kicad-library/solid-models/TDK_C1005-0mm5.STEP

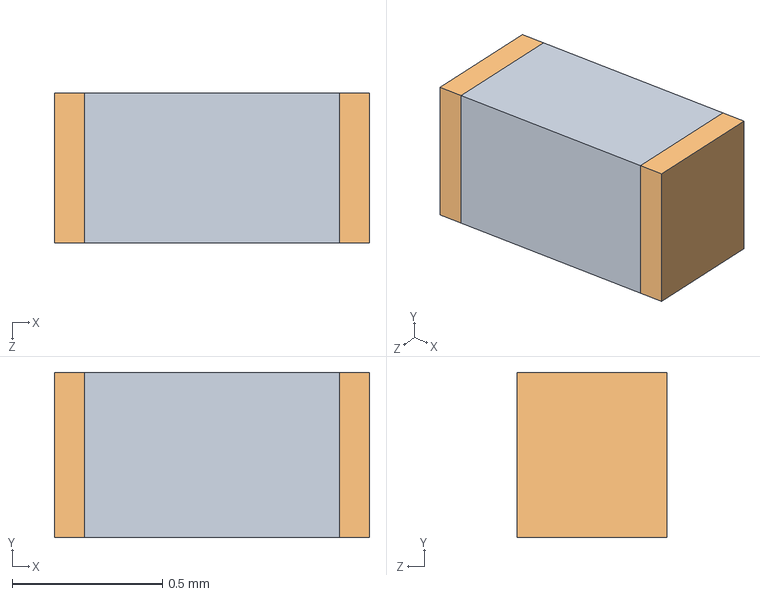
[picture p37: CAD file, 2021-04-21]
Buffer/Test Project/kicad-library/solid-models/TDK_C1005-0mm5.STEP
1.05 x 0.55 x 0.5 mm
