kefernandez/SSB_ChargeInjection/Buffer/calisco-hw-libs/solid-models/VISHAY_IHLP-5050CE-01.STEP

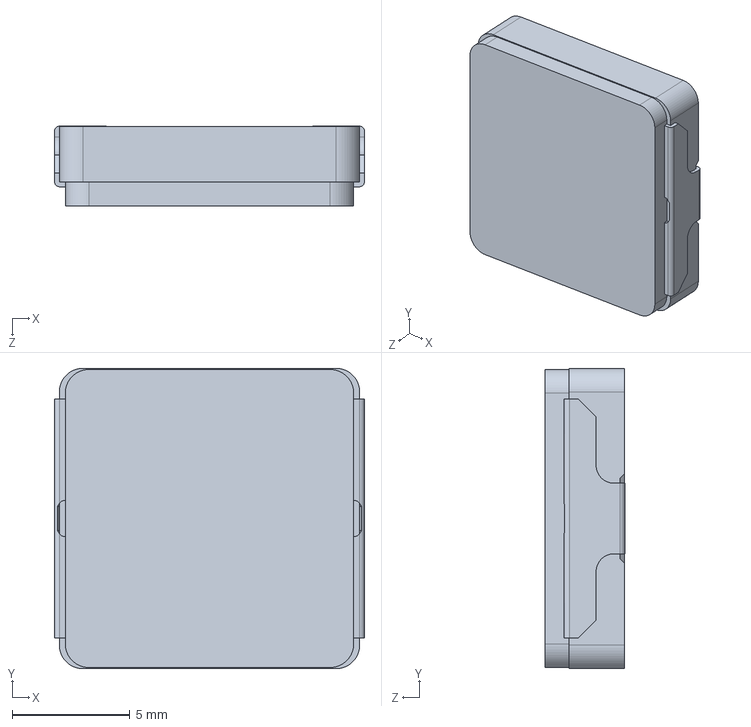
[picture p38: CAD file, 2021-04-21]
Buffer/calisco-hw-libs/solid-models/VISHAY_IHLP-5050CE-01.STEP
13.2 x 12.8 x 3.39 mm
