kefernandez/SSB_ChargeInjection/Buffer/kicad-library/solid-models/PANASONIC_AXK5F80347Y.STEP

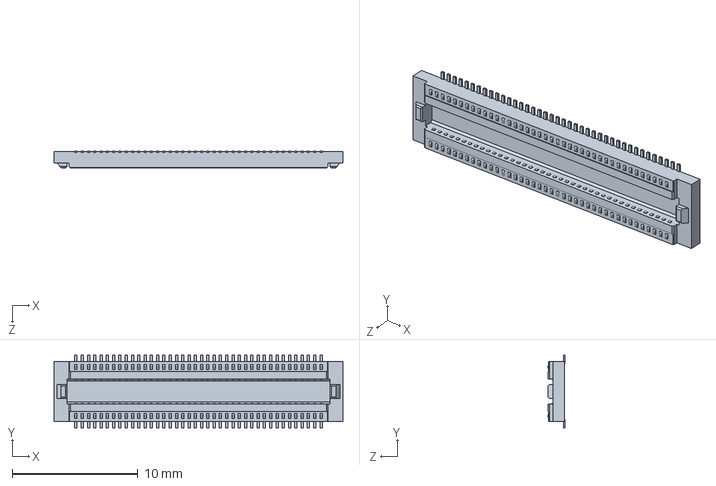
[picture p39: CAD file, 2021-04-21]
Buffer/kicad-library/solid-models/PANASONIC_AXK5F80347Y.STEP
23.0 x 5.80 x 1.35 mm
