kefernandez/SSB_ChargeInjection/calisco-hw-libs/solid-models/EPC_EPC2013x_BGA-24.STEP

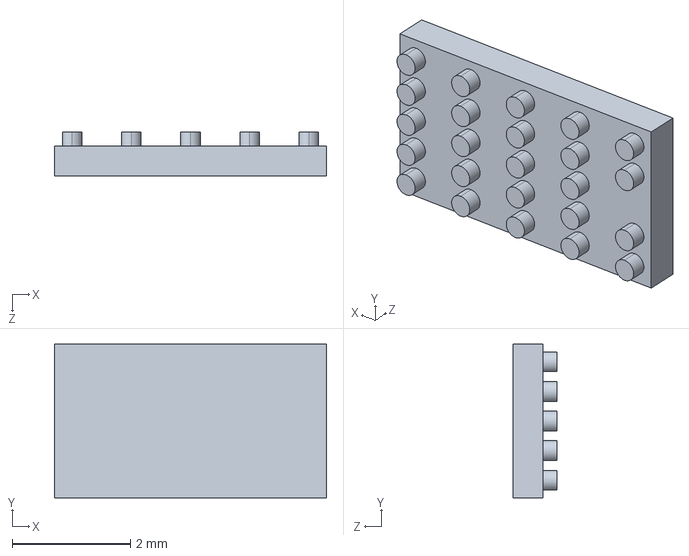
[picture p40: CAD file, 2021-04-21]
calisco-hw-libs/solid-models/EPC_EPC2013x_BGA-24.STEP
4.60 x 2.60 x 0.75 mm
