kefernandez/SSB_ChargeInjection/Buffer/Test Project/calisco-hw-libs/solid-models/EPC203x.STEP

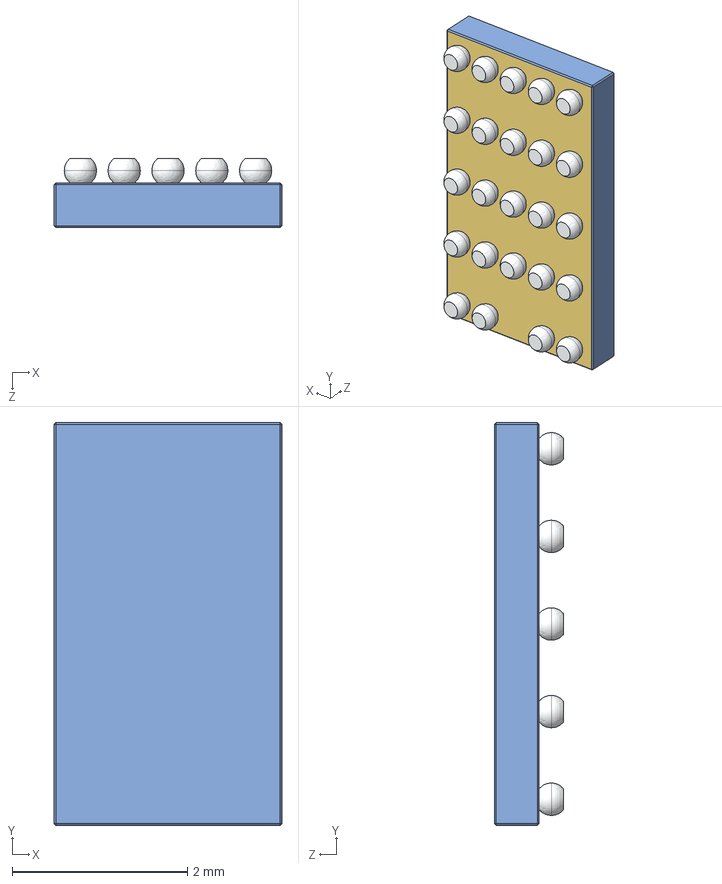
[picture p41: CAD file, 2021-04-21]
Buffer/Test Project/calisco-hw-libs/solid-models/EPC203x.STEP
2.60 x 4.60 x 0.79 mm
