kefernandez/SSB_ChargeInjection/Buffer/Test Project/kicad-library/solid-models/AD_SSOP-20_RS-20.STEP

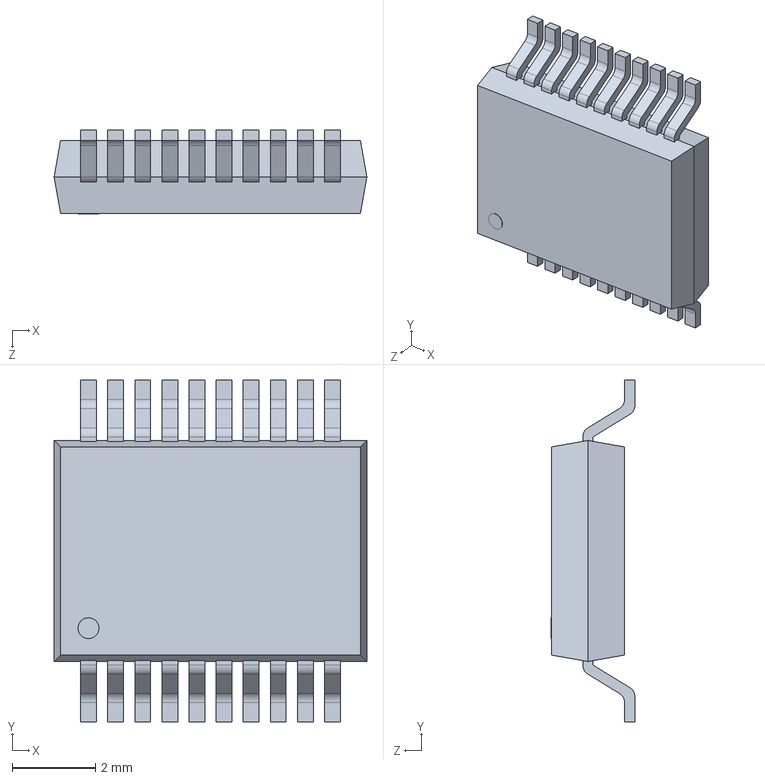
[picture p42: CAD file, 2021-04-21]
Buffer/Test Project/kicad-library/solid-models/AD_SSOP-20_RS-20.STEP
7.50 x 8.20 x 2.01 mm
