kefernandez/SSB_ChargeInjection/Buffer/Test Project/kicad-library/solid-models/Sw3D.step

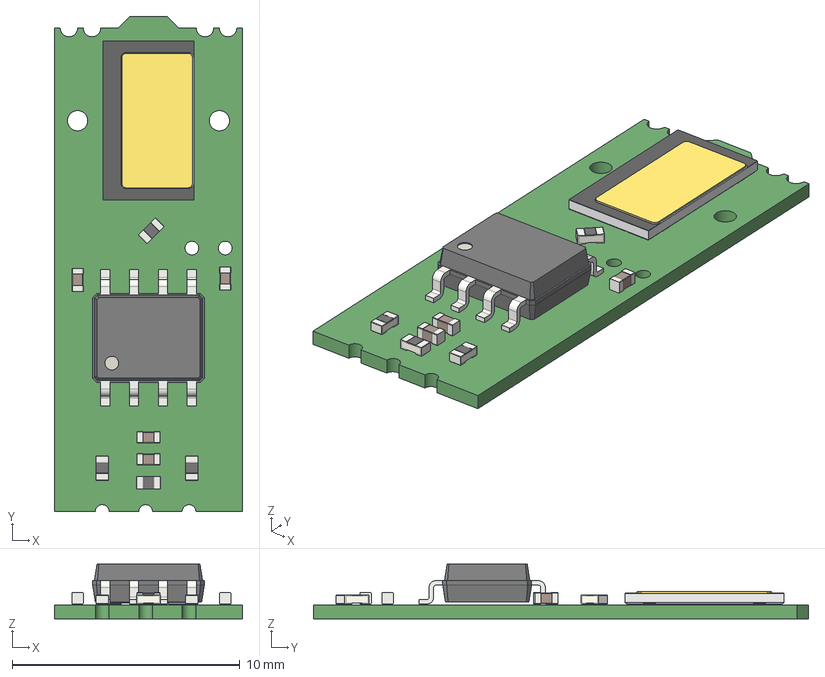
[picture p43: CAD file, 2021-04-21]
Buffer/Test Project/kicad-library/solid-models/Sw3D.step
8.26 x 21.7 x 2.40 mm
