kefernandez/SSB_ChargeInjection/kicad-library/solid-models/soic-16_150mil.STEP

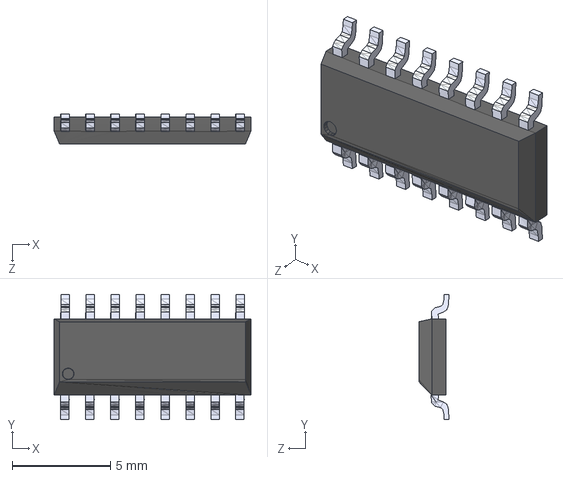
[picture p44: CAD file, 2021-04-21]
kicad-library/solid-models/soic-16_150mil.STEP
10.0 x 6.35 x 1.54 mm
