kefernandez/SSB_ChargeInjection/(list of files, cad)

Other CAD files:
Buffer/Test Project/kicad-library/solid-models/IHLP6767GZ.step
kicad-library/solid-models/soic-8_150mil.step
Buffer/Test Project/kicad-library/solid-models/soic-8_150mil.step
Buffer/kicad-library/solid-models/soic-8_150mil.step
Buffer/kicad-library/solid-models/IHLP6767GZ.step
kicad-library/solid-models/IHLP6767GZ.step
Buffer/Test Project/calisco-hw-libs/solid-models/GS66516T.STEP
Buffer/Test Project/kicad-library/solid-models/GS66516T.STEP
Buffer/Test Project/kicad-library/solid-models/GS66516T_O.STEP
Buffer/calisco-hw-libs/solid-models/GS66516T.STEP
Buffer/kicad-library/solid-models/GS66516T.STEP
Buffer/kicad-library/solid-models/GS66516T_O.STEP
calisco-hw-libs/solid-models/GS66516T.STEP
kicad-library/solid-models/GS66516T.STEP
kicad-library/solid-models/GS66516T_O.STEP
