kefernandez/SSB_ChargeInjection/Simulation/Simulations_fromHardDrive/SSB_ci_presentation/pre layout/increasing load step/inductor current.pdf

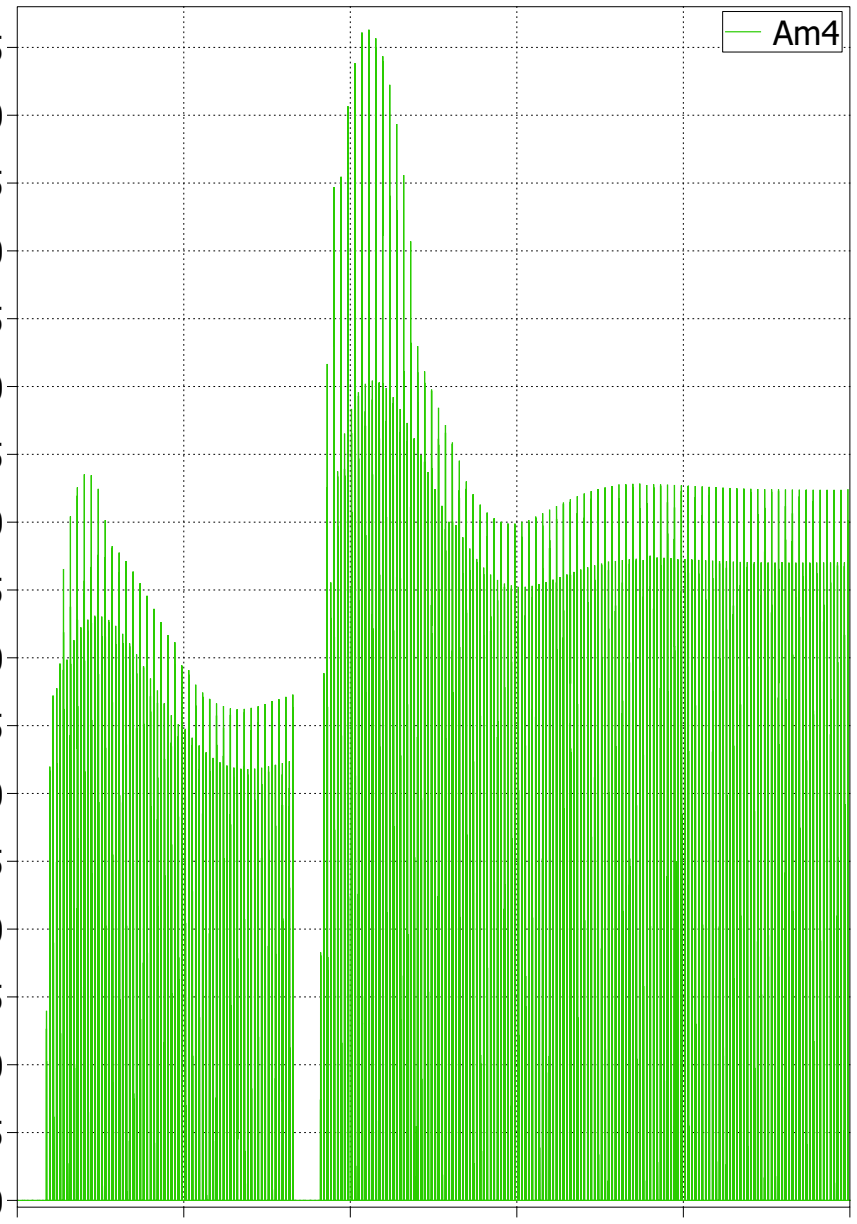
[picture p45: figure]

Time [s] 0.0 | 0.2 | 0.4 | 0.6 | 0.8 | 1.0 Inductor Current [A] 0.0 0.5 1.0 1.5 2.0 2.5 3.0 3.5 4.0 4.5 5.0 5.5 6.0 6.5 7.0 7.5 8.0 8.5 | Am4
