kefernandez/SSB_ChargeInjection/Simulation/Simulations_fromHardDrive/SSB_ci_presentation/pre layout/no load step/Inductor Current.pdf

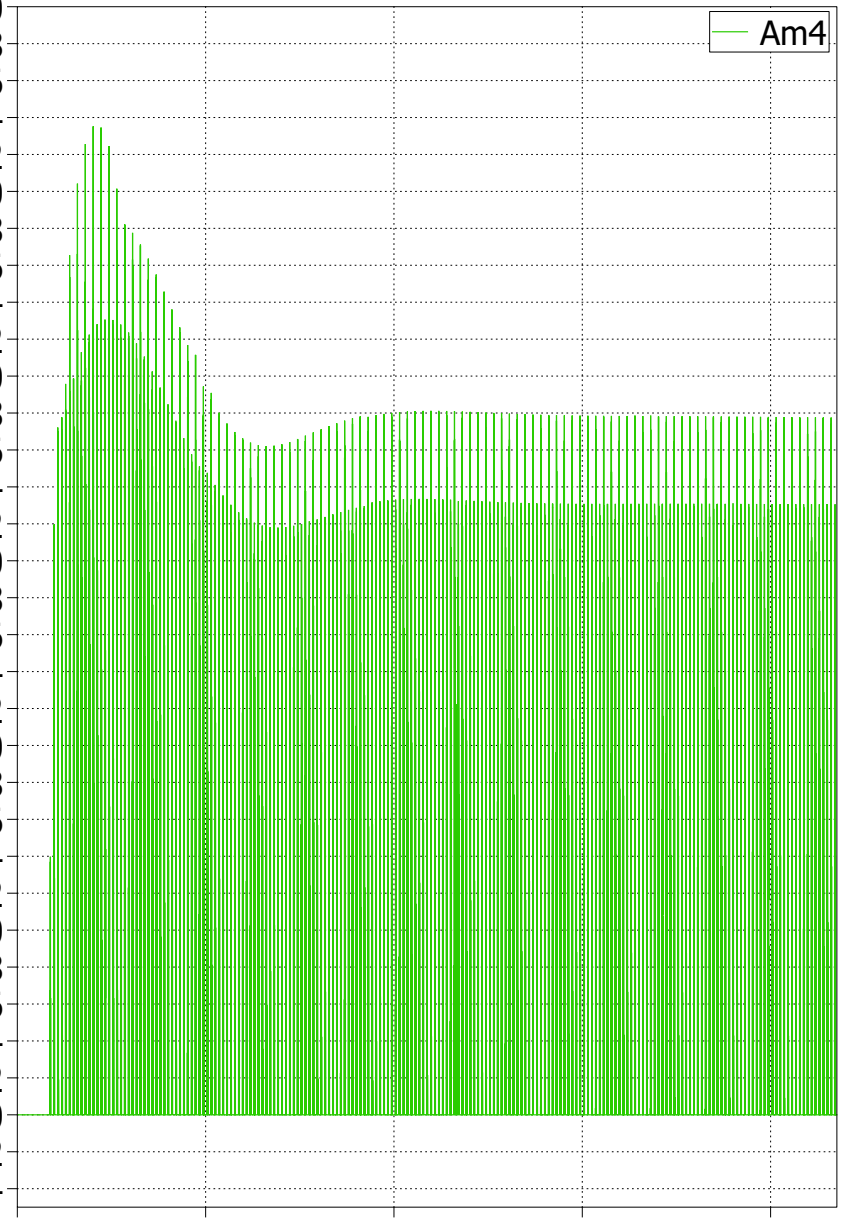
[picture p46: figure]

Time [s] 0.0 | 0.2 | 0.4 | 0.6 | 0.8 Inductor Current [A] -0.4 ⁻0.2 0.0 0.2 0.4 0.6 0.8 1.0 1.2 1.4 1.6 1.8 2.0 2.2 2.4 2.6 2.8 3.0 3.2 3.4 3.6 3.8 4.0 4.2 4.4 4.6 4.8 5.0 5.2 5.4 5.6 5.8 6.0 | Am4
