kefernandez/SSB_ChargeInjection/Figures/Assembly.jpg

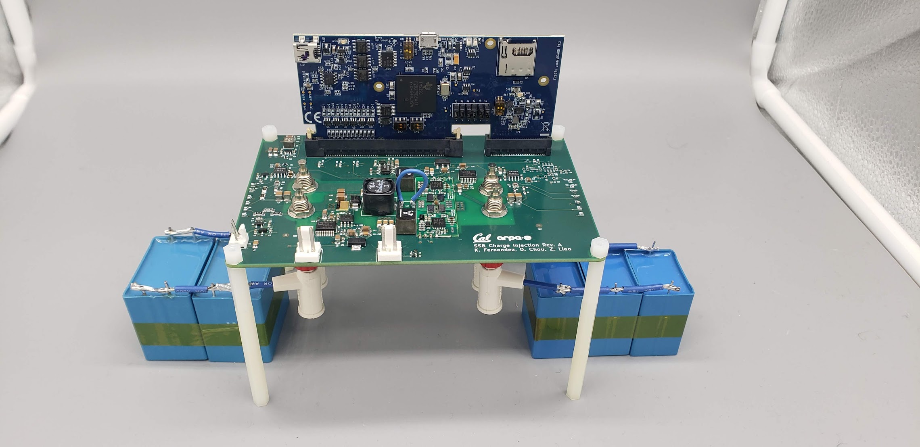
Figures/Assembly.jpg
