kefernandez/SSB_ChargeInjection/Figures/LoadStep_1500to750W.png

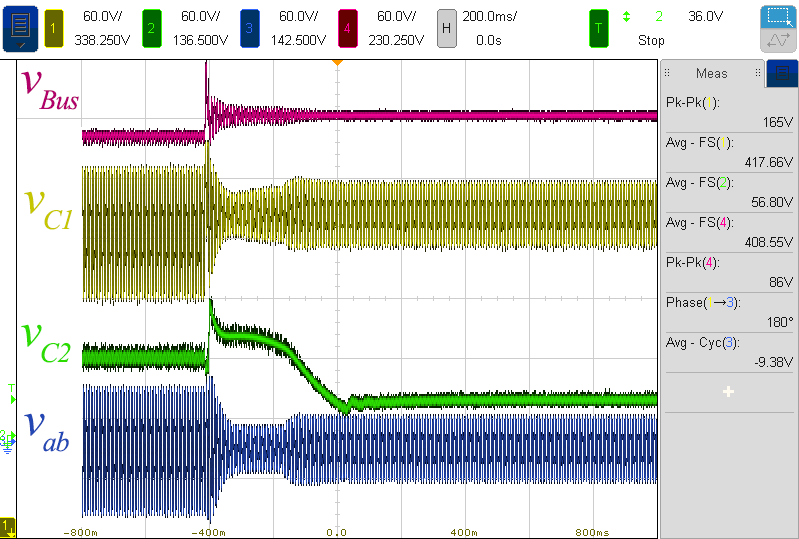
Figures/LoadStep_1500to750W.png
