kefernandez/SSB_ChargeInjection/Graphics/Charge Injection/ChargeInjectionWaveformOperation.png

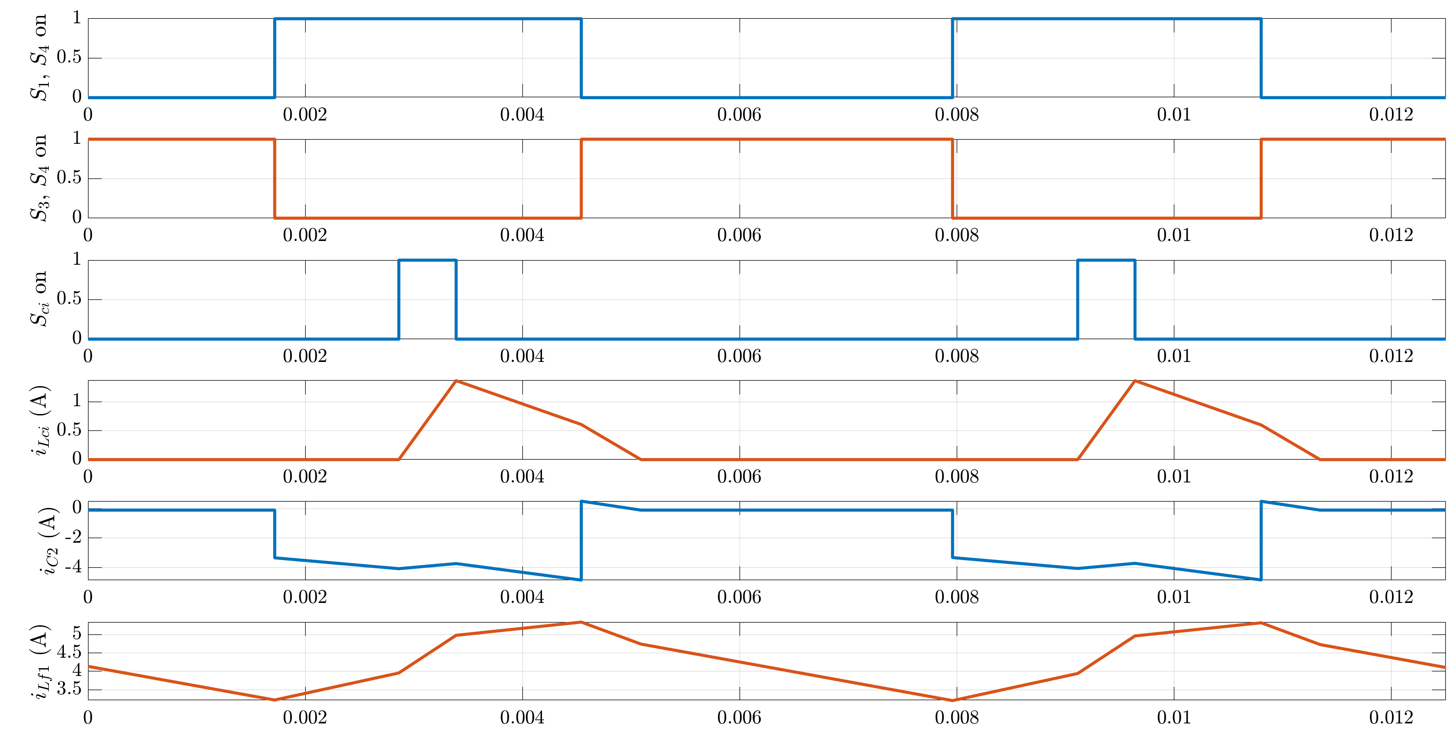
Graphics/Charge Injection/ChargeInjectionWaveformOperation.png
