kefernandez/SSB_ChargeInjection/Graphics/Charge Injection/TestResults/LoadStep_CI.png

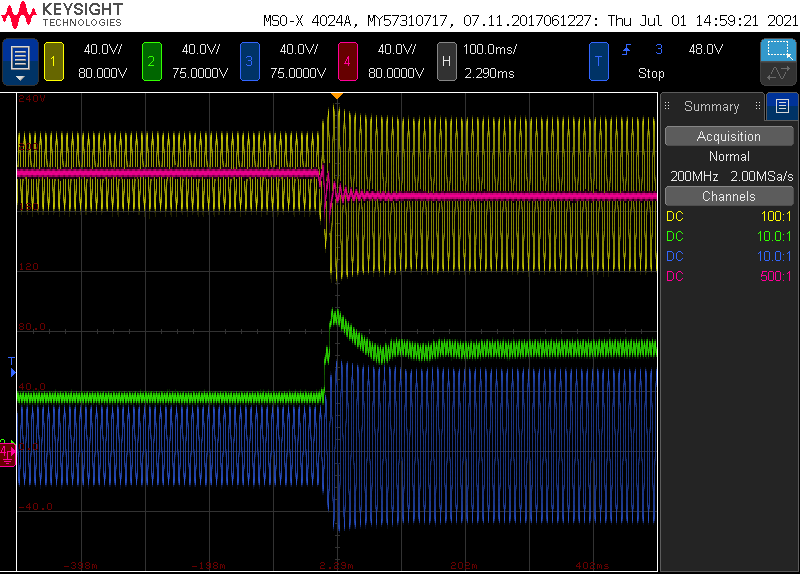
Graphics/Charge Injection/TestResults/LoadStep_CI.png
