kefernandez/SSB_ChargeInjection/Graphics/Charge Injection/TestResults/SSB_CI_LoadStep_Labeled.png

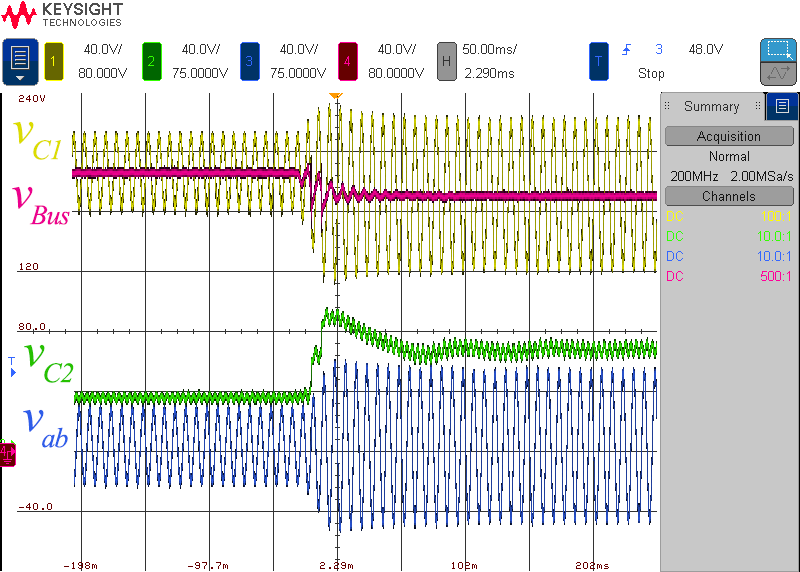
Graphics/Charge Injection/TestResults/SSB_CI_LoadStep_Labeled.png
