kefernandez/SSB_ChargeInjection/LabResults/10-25-2021/LoadStep/scope_5.png

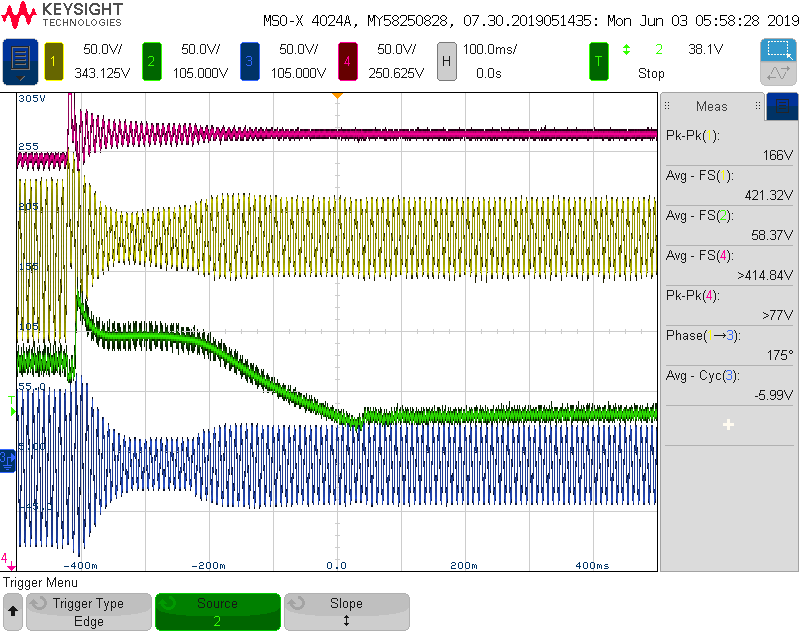
LabResults/10-25-2021/LoadStep/scope_5.png
