kefernandez/SSB_ChargeInjection/Simulation/Simulations_fromHardDrive/SSB/ChargeInjectionOperationWaveforms.png

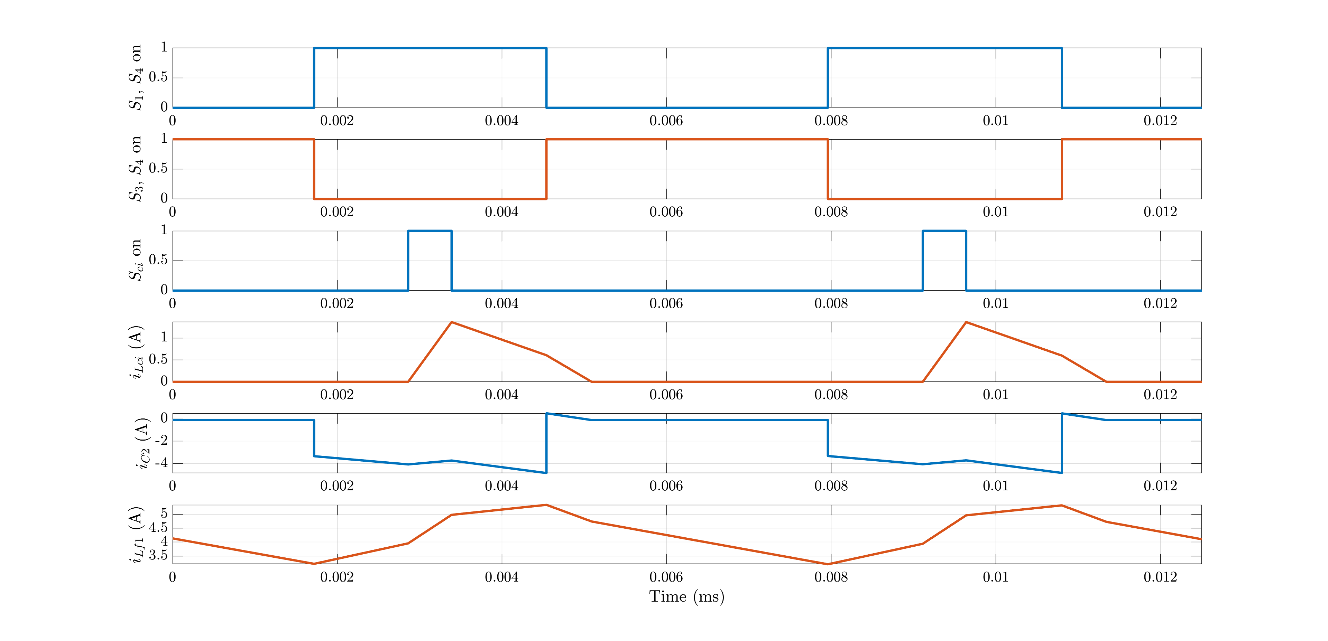
Simulation/Simulations_fromHardDrive/SSB/ChargeInjectionOperationWaveforms.png
