kefernandez/SSB_ChargeInjection/Graphics/Charge Injection/TestResults/SSB_CI_1500W.pdf

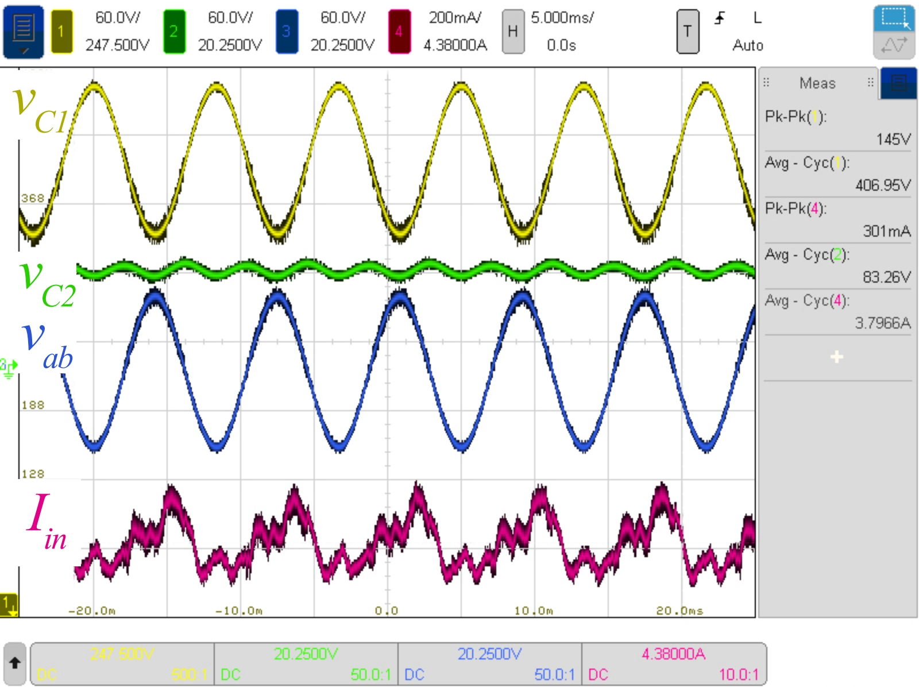
[picture p60: page 1]

vC1

vC2

Iin

v
ab
