kefernandez/SSB_ChargeInjection/Graphics/Charge Injection/TestResults/SSB_CI_1500W_Loadstep.pdf

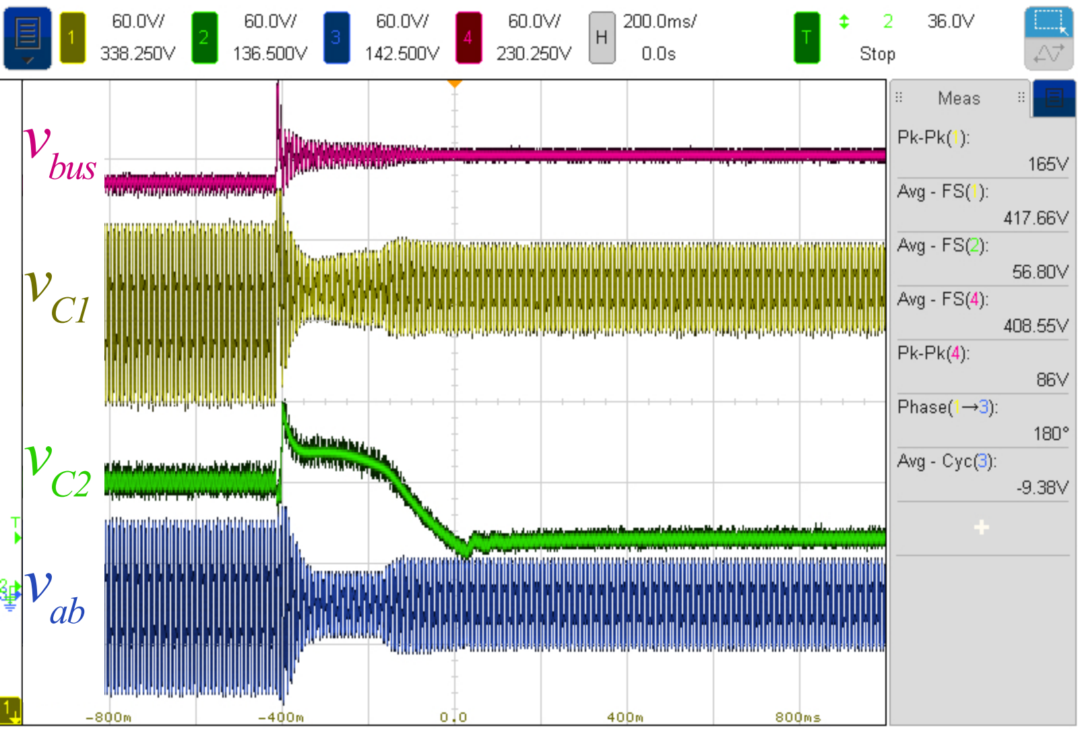
[picture p61: page 1]

vC1

vC2
v
ab

vbus
