kefernandez/SSB_ChargeInjection/Graphics/Charge Injection/TestResults/SSB_traditional_1500W.pdf

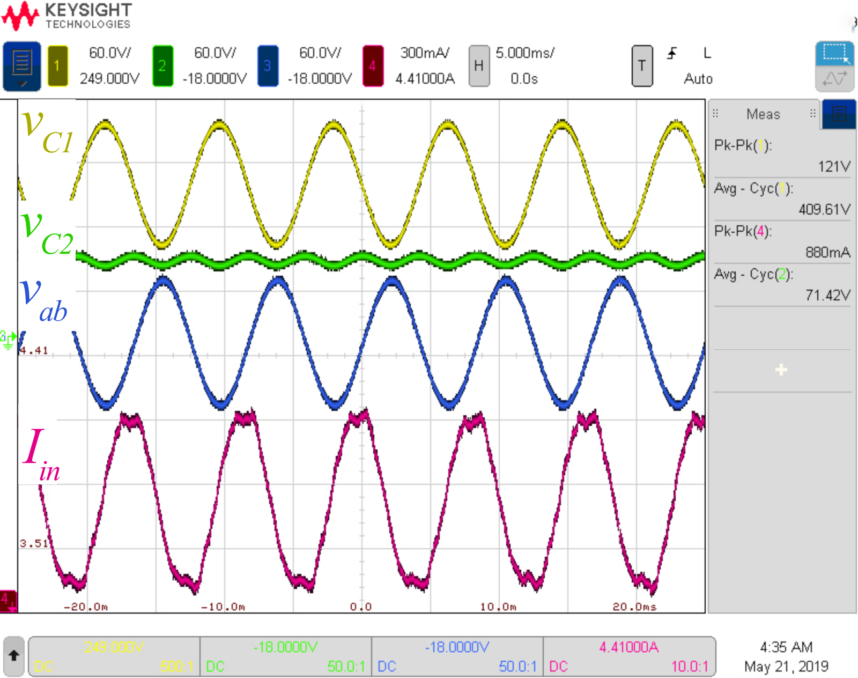
[picture p62: page 1]

vC2

vC1

Iin

v
ab
