kefernandez/SSB_ChargeInjection/LabResults/10-1-2021/Scope_ChargeInjection/SSB_CI_1500W_Waveforms.pdf

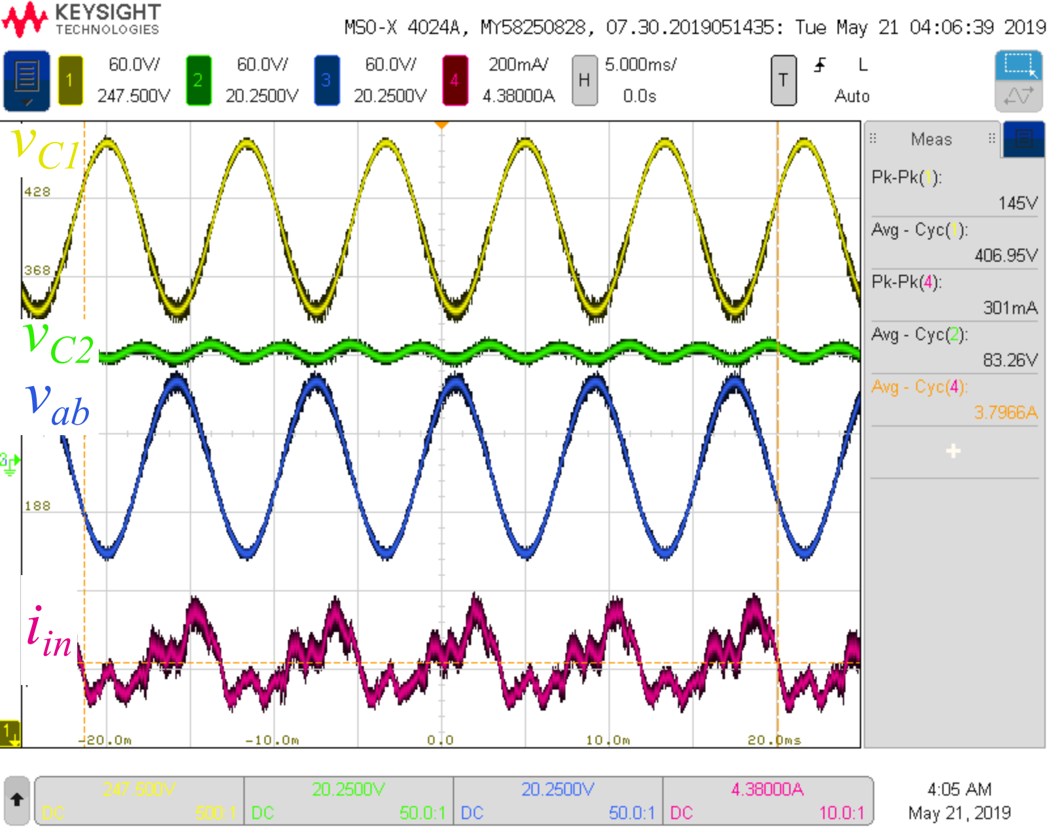
[picture p63: page 1]

vC1

iin

vC2
vab
