kefernandez/SSB_ChargeInjection/LabResults/10-1-2021/PowerAnalyzer_ChargeInjection/IntegraVision_12.csv

x-axis | V1 | V2 | I1 | I2 | P1 | P2
second | Volt | Volt | Ampere | Ampere | Watt | Watt
-50.00000E-03 | +396.69753132E+00 | +396.63017792E+00 | +2.53308896E+00 | +3.43541023E+00 | +1.00447506292E+03 | +1.36220278751E+03
-49.95000E-03 | +396.69753132E+00 | +396.63017792E+00 | +2.51932517E+00 | +3.32309874E+00 | +999.07465936E+00 | +1.31808721540E+03
-49.90000E-03 | +396.57779165E+00 | +396.68982156E+00 | +2.52923510E+00 | +3.23666294E+00 | +1.00339498221E+03 | +1.28365554936E+03
-49.85000E-03 | +396.57779165E+00 | +396.68982156E+00 | +2.51326910E+00 | +3.12710418E+00 | +996.91449793E+00 | +1.24061596682E+03
-49.80000E-03 | +396.57779165E+00 | +396.51089065E+00 | +2.52207793E+00 | +3.04066838E+00 | +1.00015474007E+03 | +1.20618430079E+03
-49.75000E-03 | +396.45805198E+00 | +396.57053429E+00 | +2.52207793E+00 | +2.97900717E+00 | +1.00015474007E+03 | +1.18143654082E+03
-49.70000E-03 | +396.63766148E+00 | +396.68982156E+00 | +2.52097682E+00 | +2.86999896E+00 | +1.00015474007E+03 | +1.13839695828E+03
-49.65000E-03 | +396.63766148E+00 | +396.63017792E+00 | +2.51822407E+00 | +2.76814786E+00 | +999.07465936E+00 | +1.09750935486E+03
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
