kefernandez/SSB_ChargeInjection/LabResults/10-1-2021/PowerAnalyzer_ChargeInjection/IntegraVision_14.csv

x-axis | V1 | V2 | I1 | I2 | P1 | P2
second | Volt | Volt | Ampere | Ampere | Watt | Watt
-50.00000E-03 | +392.26716348E+00 | +392.21654888E+00 | +2.84249909E+00 | +796.09025E-03 | +1.11464329563E+03 | +312.03697344E+00
-49.95000E-03 | +392.20729364E+00 | +392.33583615E+00 | +2.85185847E+00 | +722.31702E-03 | +1.11896361848E+03 | +282.98525522E+00
-49.90000E-03 | +392.26716348E+00 | +392.09726160E+00 | +2.84855516E+00 | +640.83614E-03 | +1.11788353777E+03 | +251.78155788E+00
-49.85000E-03 | +392.08755397E+00 | +392.09726160E+00 | +2.85075737E+00 | +575.87165E-03 | +1.11788353777E+03 | +225.95780835E+00
-49.80000E-03 | +392.20729364E+00 | +392.03761797E+00 | +2.85185847E+00 | +542.83886E-03 | +1.11896361848E+03 | +213.04593359E+00
-49.75000E-03 | +392.14742381E+00 | +392.09726160E+00 | +2.85516178E+00 | +476.77328E-03 | +1.12004369919E+03 | +187.22218406E+00
-49.70000E-03 | +392.02768414E+00 | +392.03761797E+00 | +2.85240903E+00 | +411.80879E-03 | +1.11788353777E+03 | +161.39843454E+00
-49.65000E-03 | +391.96781430E+00 | +392.09726160E+00 | +2.85516178E+00 | +371.06835E-03 | +1.11896361848E+03 | +145.25859108E+00
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
