kefernandez/SSB_ChargeInjection/LabResults/10-1-2021/PowerAnalyzer_ChargeInjection/IntegraVision_16.csv

x-axis | V1 | V2 | I1 | I2 | P1 | P2
second | Volt | Volt | Ampere | Ampere | Watt | Watt
-50.00000E-03 | +402.74438473E+00 | +402.83311604E+00 | +2.95536222E+00 | +723.96866E-03 | +1.19024894552E+03 | +291.59317173E+00
-49.95000E-03 | +402.80425456E+00 | +402.71382877E+00 | +2.95536222E+00 | +772.96730E-03 | +1.19024894552E+03 | +310.96098388E+00
-49.90000E-03 | +402.74438473E+00 | +402.77347241E+00 | +2.95481167E+00 | +831.87578E-03 | +1.19024894552E+03 | +334.63275428E+00
-49.85000E-03 | +402.80425456E+00 | +402.83311604E+00 | +2.96527215E+00 | +911.70502E-03 | +1.19456926838E+03 | +366.91244118E+00
-49.80000E-03 | +402.74438473E+00 | +402.83311604E+00 | +2.97297988E+00 | +1.01575831E+00 | +1.19780951051E+03 | +408.87603416E+00
-49.75000E-03 | +402.86412440E+00 | +402.95240332E+00 | +2.96912601E+00 | +1.13577745E+00 | +1.19564934909E+03 | +457.29556453E+00
-49.70000E-03 | +402.92399423E+00 | +403.01204695E+00 | +2.95976663E+00 | +1.20789904E+00 | +1.19240910695E+03 | +486.34728274E+00
-49.65000E-03 | +402.86412440E+00 | +402.95240332E+00 | +2.96802491E+00 | +1.28442501E+00 | +1.19564934909E+03 | +517.55098009E+00
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
