kefernandez/SSB_ChargeInjection/LabResults/10-1-2021/PowerAnalyzer_ChargeInjection/IntegraVision_18.csv

x-axis | V1 | V2 | I1 | I2 | P1 | P2
second | Volt | Volt | Ampere | Ampere | Watt | Watt
-50.00000E-03 | +401.12789916E+00 | +401.22273788E+00 | +3.28789552E+00 | +5.88809493E+00 | +1.31877855035E+03 | +2.36287308165E+03
-49.95000E-03 | +401.12789916E+00 | +401.22273788E+00 | +3.28569331E+00 | +5.91617280E+00 | +1.31769846964E+03 | +2.37363297728E+03
-49.90000E-03 | +401.18776900E+00 | +401.16309424E+00 | +3.28844607E+00 | +5.98884494E+00 | +1.31877855035E+03 | +2.40268469550E+03
-49.85000E-03 | +401.06802933E+00 | +401.04380697E+00 | +3.29670435E+00 | +6.06151708E+00 | +1.32201879249E+03 | +2.43066042415E+03
-49.80000E-03 | +401.00815949E+00 | +400.98416333E+00 | +3.30276042E+00 | +6.12097611E+00 | +1.32417895391E+03 | +2.45433219455E+03
-49.75000E-03 | +401.06802933E+00 | +401.04380697E+00 | +3.29229994E+00 | +6.19144606E+00 | +1.32093871178E+03 | +2.48338391277E+03
-49.70000E-03 | +401.00815949E+00 | +401.10345061E+00 | +3.29340104E+00 | +6.24650071E+00 | +1.32093871178E+03 | +2.50597969360E+03
-49.65000E-03 | +401.00815949E+00 | +401.10345061E+00 | +3.30110877E+00 | +6.30540919E+00 | +1.32417895391E+03 | +2.52965146400E+03
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
