kefernandez/SSB_ChargeInjection/LabResults/10-1-2021/PowerAnalyzer_ChargeInjection/IntegraVision_2.csv

x-axis | V1 | V2 | I1 | I2 | P1 | P2
second | Volt | Volt | Ampere | Ampere | Watt | Watt
-50.00000E-03 | +245.52619619E+00 | +245.55080100E+00 | +2.06071233E+00 | +3.76738977E+00 | +505.90382586E+00 | +925.01066826E+00
-49.95000E-03 | +245.34658668E+00 | +245.46050600E+00 | +2.06249430E+00 | +3.75087338E+00 | +505.90382586E+00 | +920.58923361E+00
-49.90000E-03 | +245.58606602E+00 | +245.44760672E+00 | +2.05918494E+00 | +3.73105370E+00 | +505.90382586E+00 | +915.70238480E+00
-49.85000E-03 | +245.52619619E+00 | +245.53790171E+00 | +2.05587558E+00 | +3.67820124E+00 | +504.90500291E+00 | +903.13620214E+00
-49.80000E-03 | +245.46632635E+00 | +245.48630457E+00 | +2.05791211E+00 | +3.61433784E+00 | +504.90500291E+00 | +887.31212027E+00
-49.75000E-03 | +245.40645652E+00 | +245.38311029E+00 | +2.06071233E+00 | +3.58075451E+00 | +505.90382586E+00 | +878.70195807E+00
-49.70000E-03 | +245.28671685E+00 | +245.40890886E+00 | +2.06529452E+00 | +3.53836242E+00 | +506.40323734E+00 | +868.23013919E+00
-49.65000E-03 | +245.46632635E+00 | +245.48630457E+00 | +2.05307535E+00 | +3.47394848E+00 | +503.90617995E+00 | +852.87147149E+00
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
