kefernandez/SSB_ChargeInjection/Graphics/Charge Injection/TestResults/CurrentRipple_CI.png

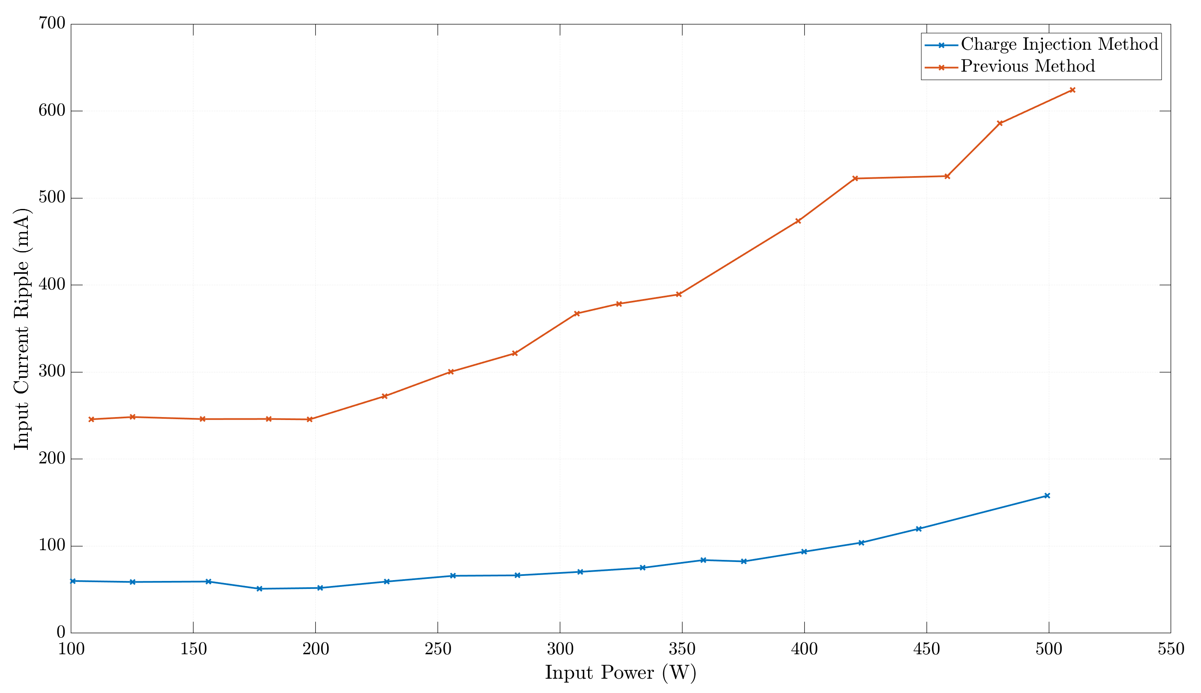
Graphics/Charge Injection/TestResults/CurrentRipple_CI.png
