kefernandez/SSB_ChargeInjection/Graphics/Charge Injection/TestResults/Efficiency_CI.png

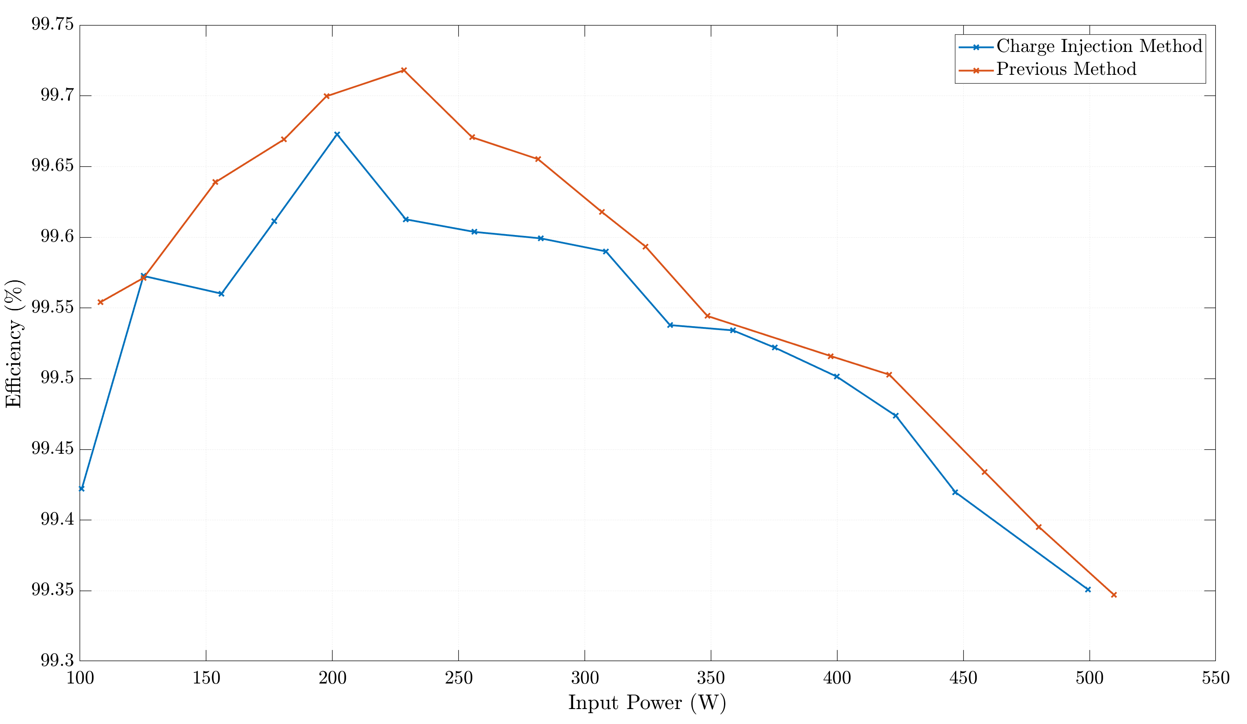
Graphics/Charge Injection/TestResults/Efficiency_CI.png
