kefernandez/SSB_ChargeInjection/Graphics/Charge Injection/TestResults/SSB_CI_500W_Labeled.png

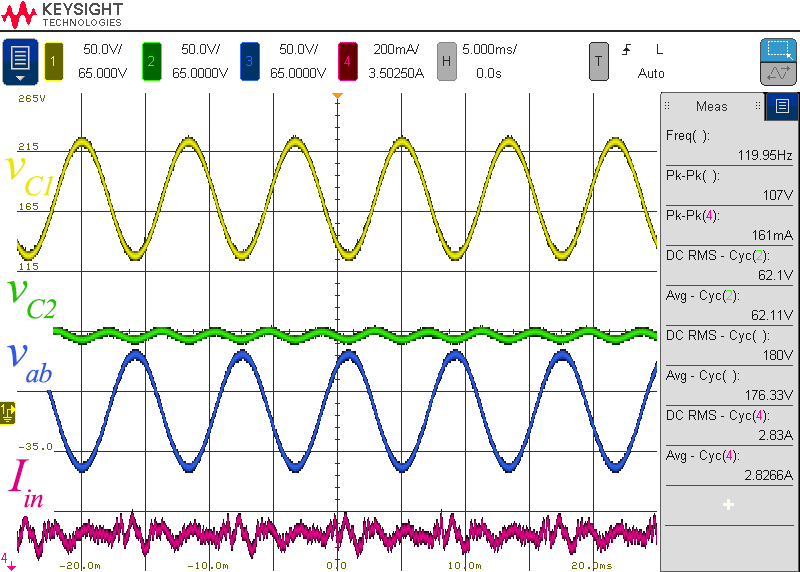
Graphics/Charge Injection/TestResults/SSB_CI_500W_Labeled.png
