kefernandez/SSB_ChargeInjection/Graphics/Charge Injection/TestResults/SSB_PWM_Ilci.png

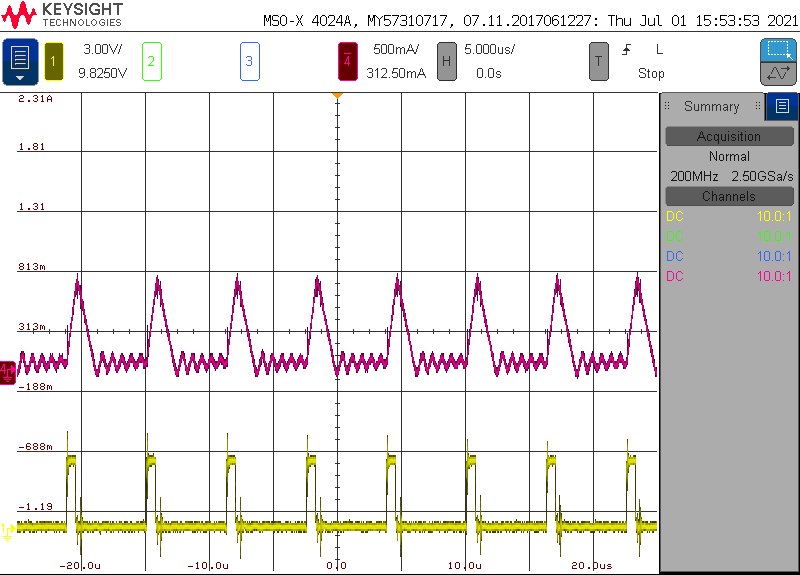
Graphics/Charge Injection/TestResults/SSB_PWM_Ilci.png
