kefernandez/SSB_ChargeInjection/Graphics/Charge Injection/TestResults/Traditional_1500W_waveform.png

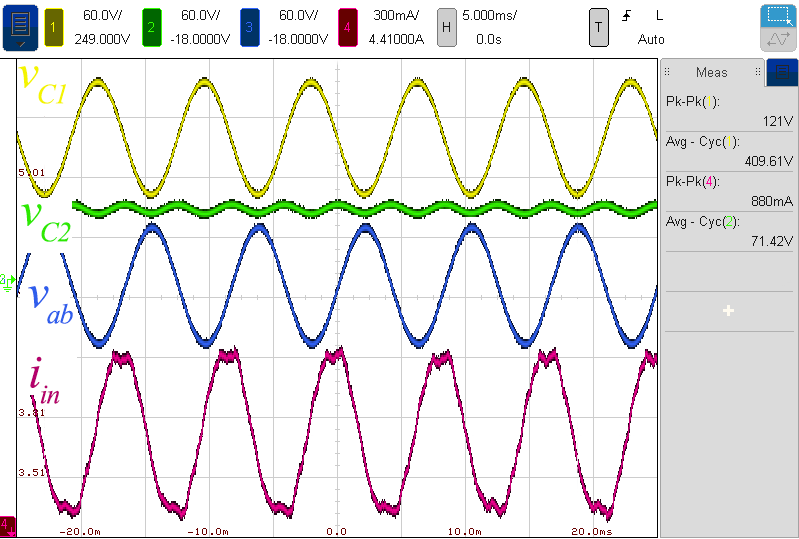
Graphics/Charge Injection/TestResults/Traditional_1500W_waveform.png
