kefernandez/SSB_ChargeInjection/LabResults/4-22-2021_NoLossCompensation/210422_205050.png

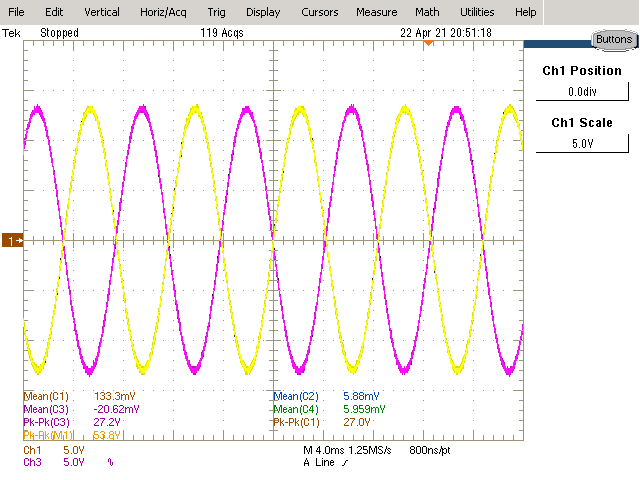
LabResults/4-22-2021_NoLossCompensation/210422_205050.png
