kefernandez/SSB_ChargeInjection/LabResults/4-22-2021_NoLossCompensation/PowerAnalyzer_NeedToIncreaseLowLevel.png

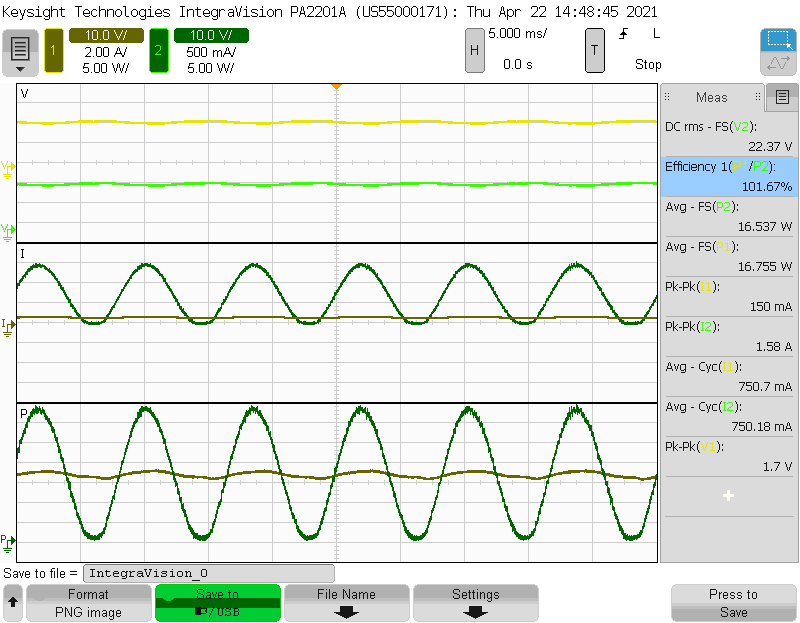
LabResults/4-22-2021_NoLossCompensation/PowerAnalyzer_NeedToIncreaseLowLevel.png
