kefernandez/SSB_ChargeInjection/LabResults/4-22-2021_NoLossCompensation/Vc2_Vc1_DC_Coupled.png

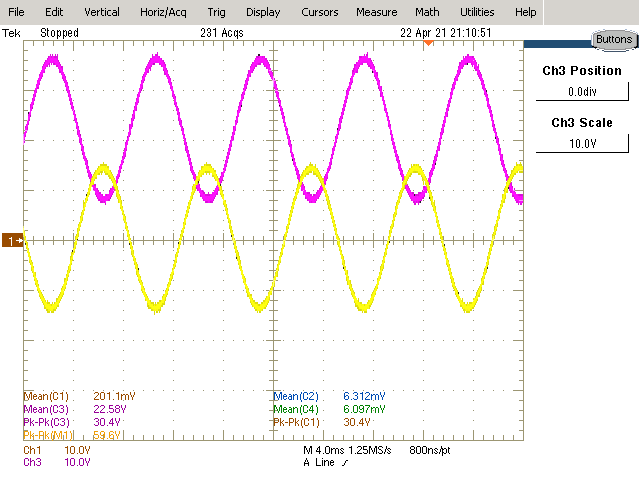
LabResults/4-22-2021_NoLossCompensation/Vc2_Vc1_DC_Coupled.png
