kefernandez/SSB_ChargeInjection/LabResults/4-26-2021/PA_newunipolar.png

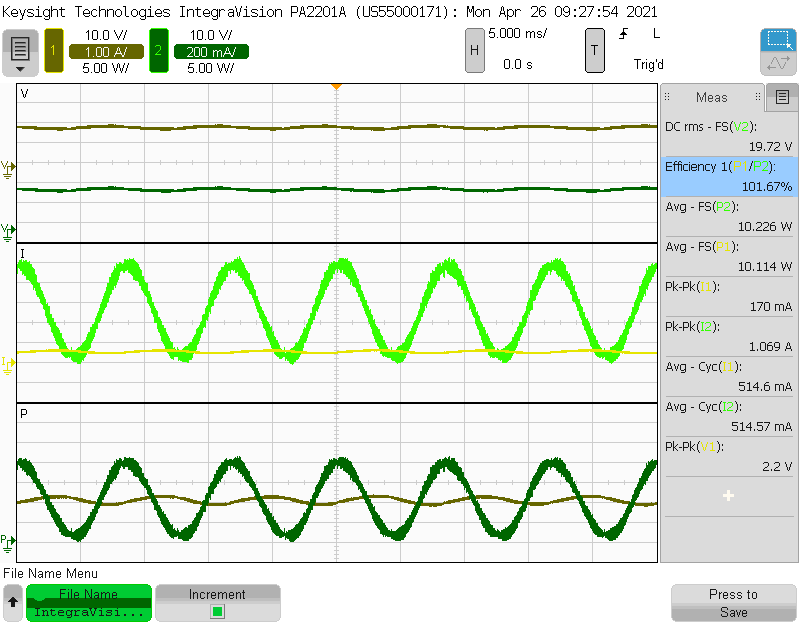
LabResults/4-26-2021/PA_newunipolar.png
