kefernandez/SSB_ChargeInjection/LabResults/4-26-2021/scope_unipolar2.png

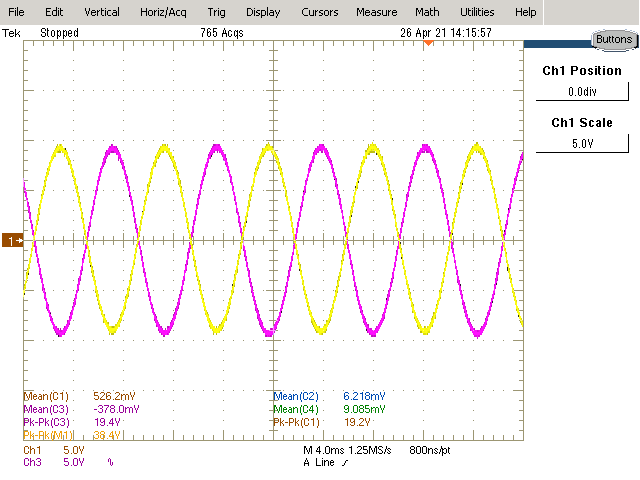
LabResults/4-26-2021/scope_unipolar2.png
