kefernandez/SSB_ChargeInjection/LabResults/6-25-2021/charge injection_PA/IntegraVision_10.png

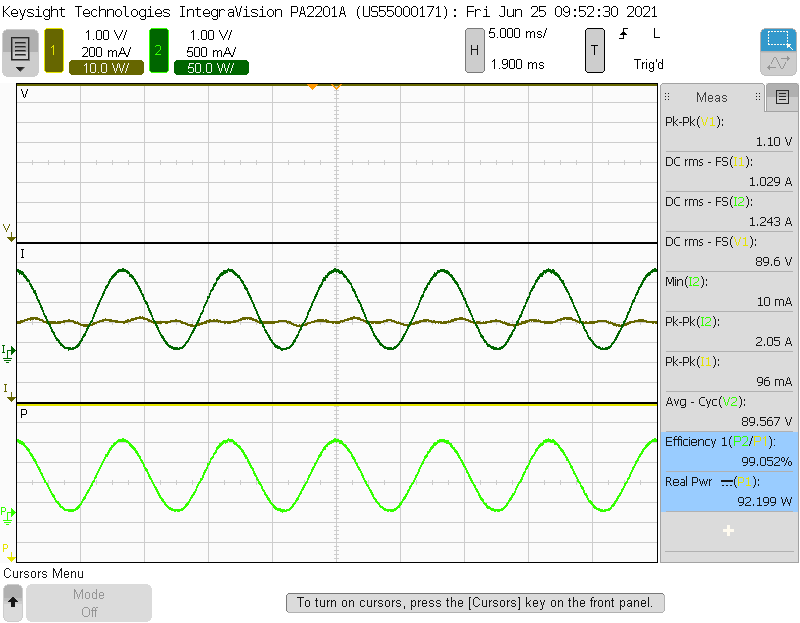
LabResults/6-25-2021/charge injection_PA/IntegraVision_10.png
