kefernandez/SSB_ChargeInjection/LabResults/6-25-2021/charge injection_scope/scope_9.png

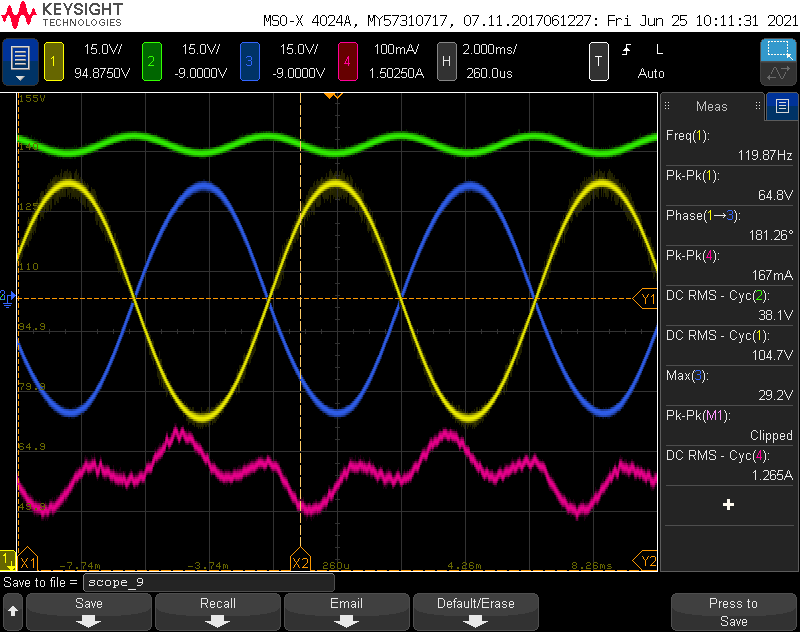
LabResults/6-25-2021/charge injection_scope/scope_9.png
