kefernandez/SSB_ChargeInjection/LabResults/6-25-2021/charge injection_scope/scope_12.png

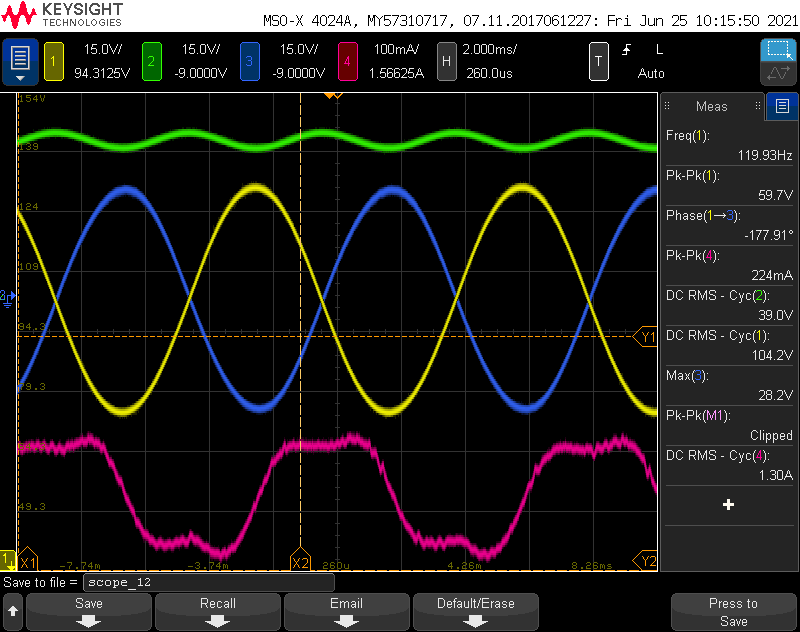
LabResults/6-25-2021/charge injection_scope/scope_12.png
