kefernandez/SSB_ChargeInjection/LabResults/6-25-2021/traditional_PA/IntegraVision_7.png

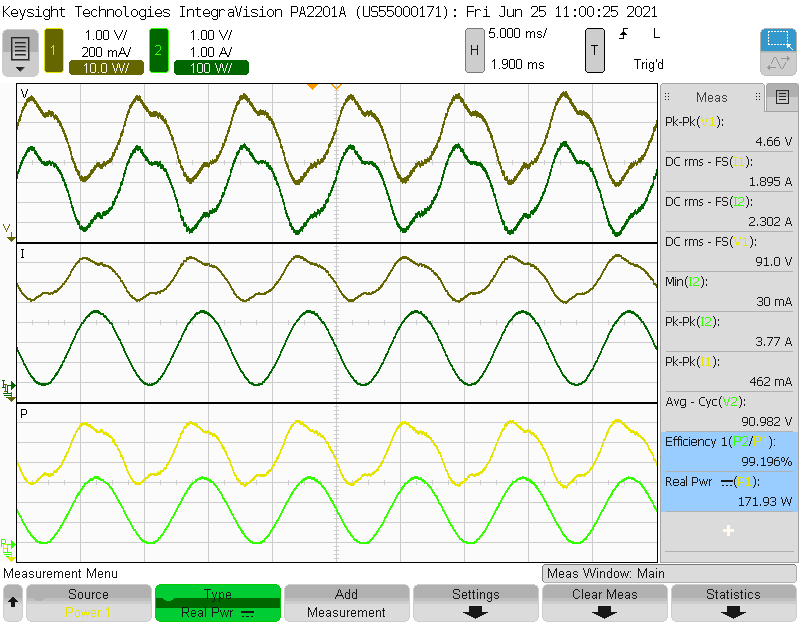
LabResults/6-25-2021/traditional_PA/IntegraVision_7.png
