kefernandez/SSB_ChargeInjection/LabResults/6-25-2021/traditional_scope/scope_9.png

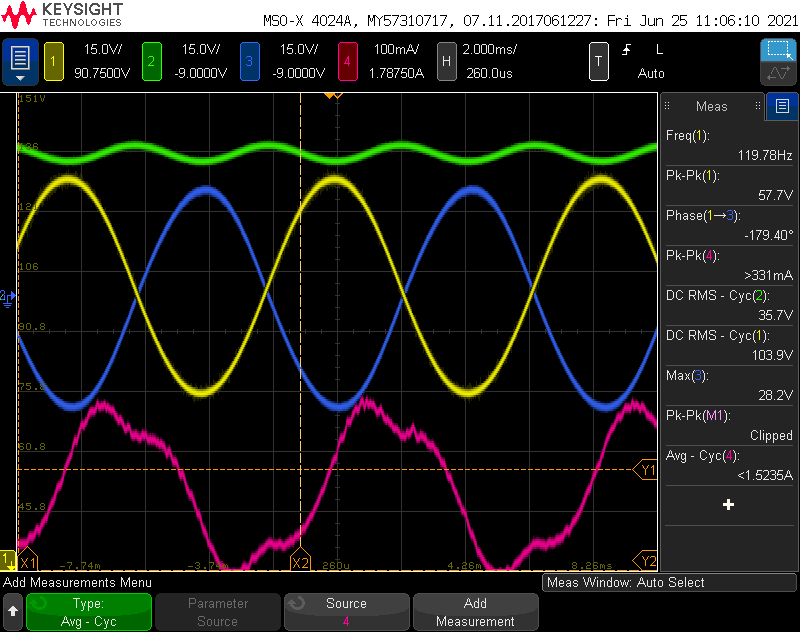
LabResults/6-25-2021/traditional_scope/scope_9.png
