kefernandez/SSB_ChargeInjection/LabResults/6-25-2021/traditional_scope/scope_11.png

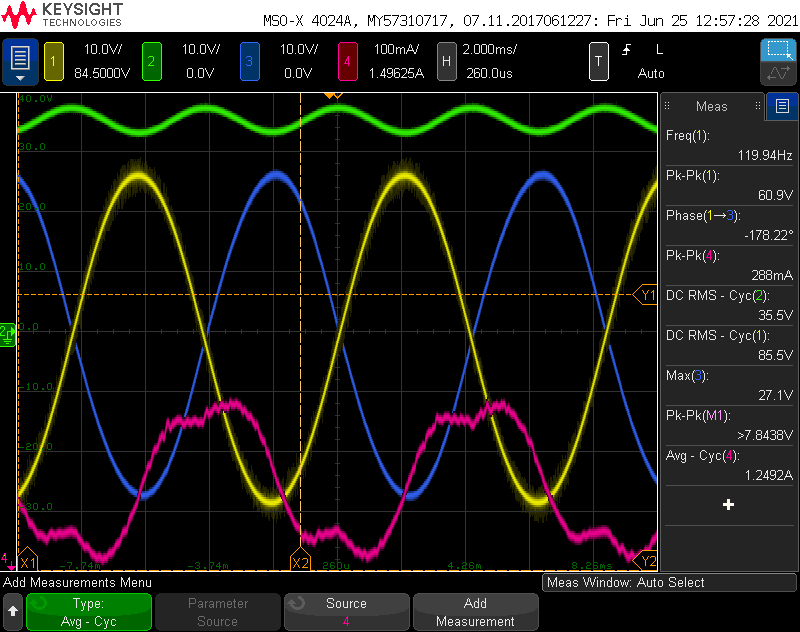
LabResults/6-25-2021/traditional_scope/scope_11.png
