kefernandez/SSB_ChargeInjection/LabResults/6-30-2021/charge injection_scope/scope_14.png

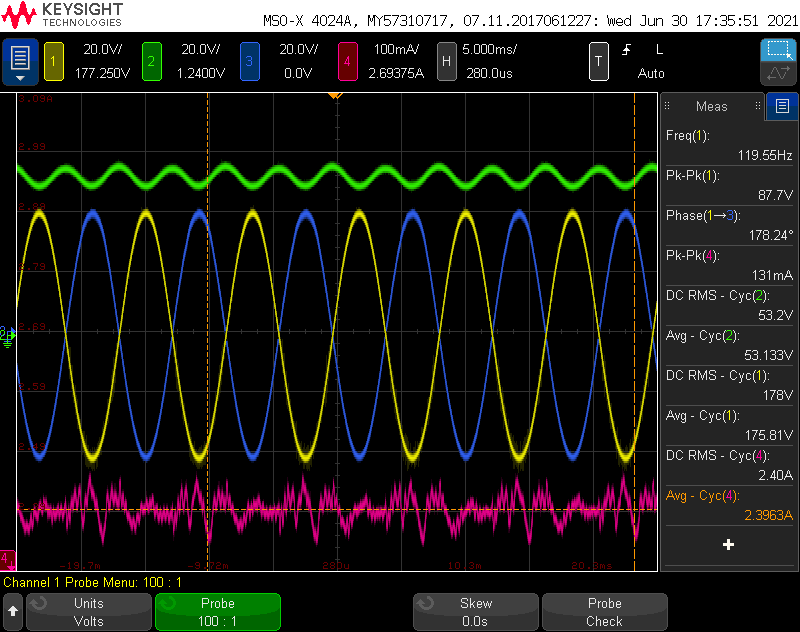
LabResults/6-30-2021/charge injection_scope/scope_14.png
