kefernandez/SSB_ChargeInjection/LabResults/6-30-2021/traditional_PA/IntegraVision_9.png

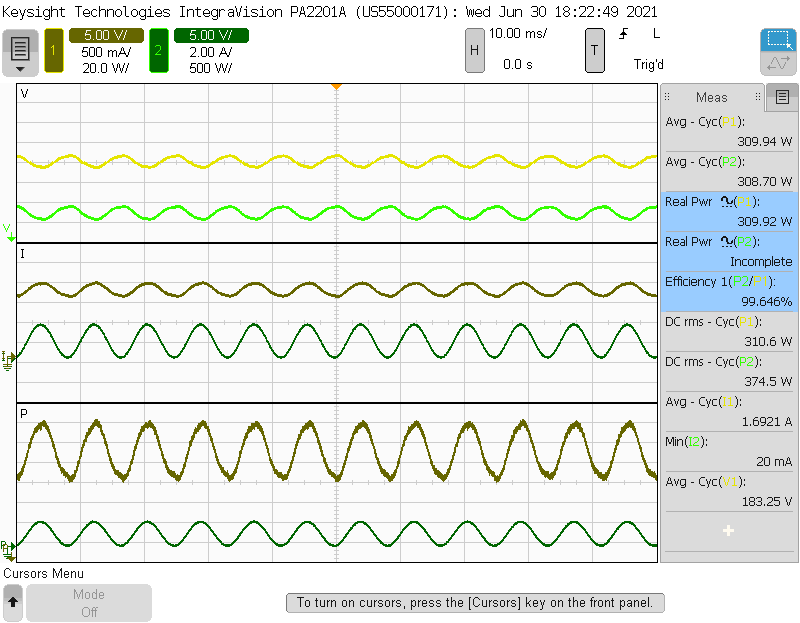
LabResults/6-30-2021/traditional_PA/IntegraVision_9.png
