kefernandez/SSB_ChargeInjection/LabResults/6-30-2021/traditional_scope/scope_1.png

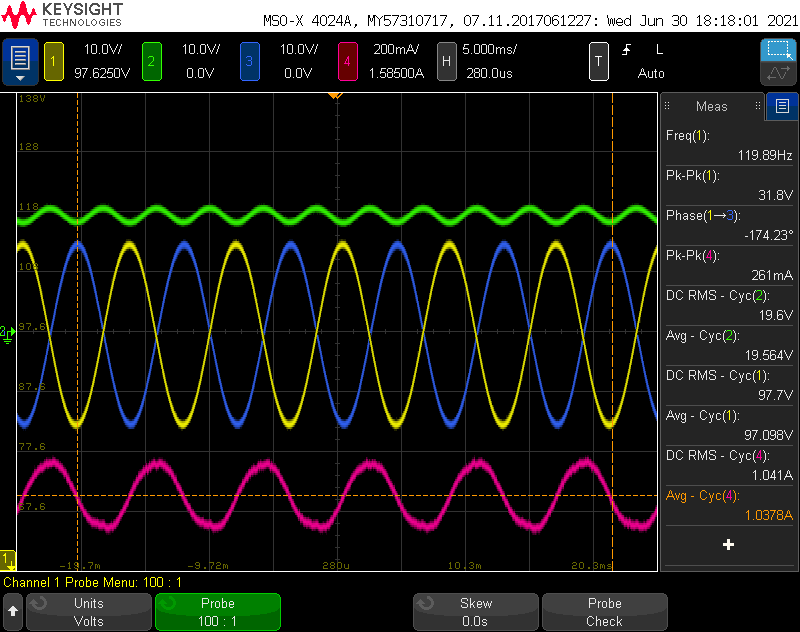
LabResults/6-30-2021/traditional_scope/scope_1.png
