kefernandez/SSB_ChargeInjection/LabResults/6-30-2021/traditional_scope/scope_15.png

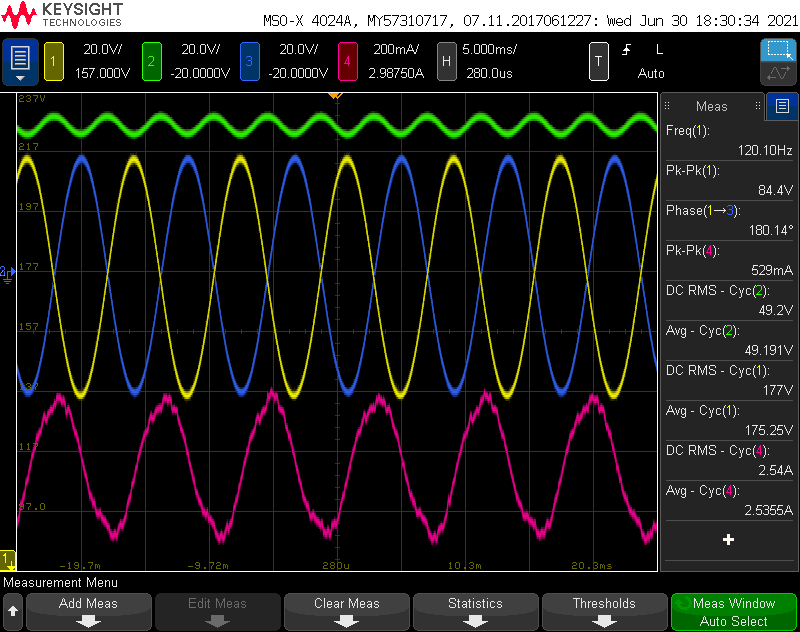
LabResults/6-30-2021/traditional_scope/scope_15.png
