kefernandez/SSB_ChargeInjection/LabResults/7-1-2021/chargeinjection_PA_finaltest/IntegraVision_13.png

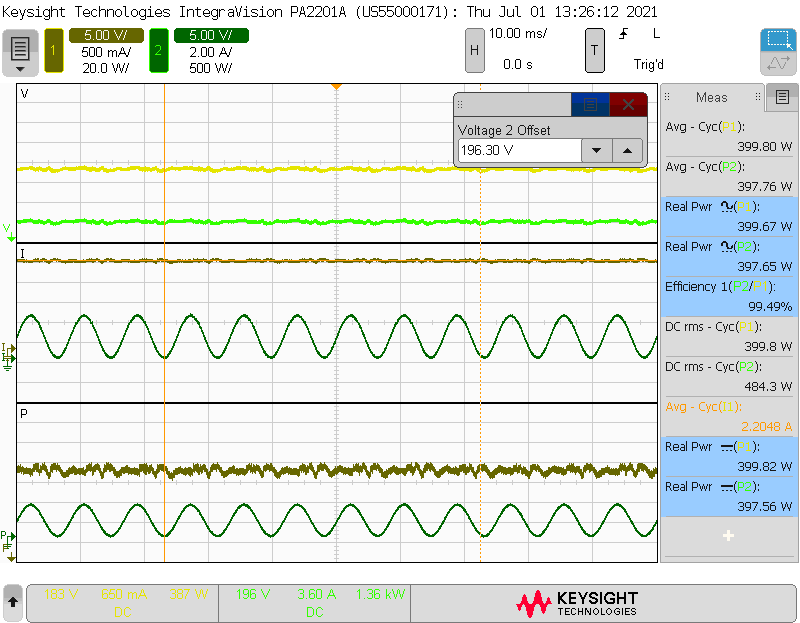
LabResults/7-1-2021/chargeinjection_PA_finaltest/IntegraVision_13.png
