kefernandez/SSB_ChargeInjection/LabResults/7-1-2021/chargeinjection_scope/scope_1.png

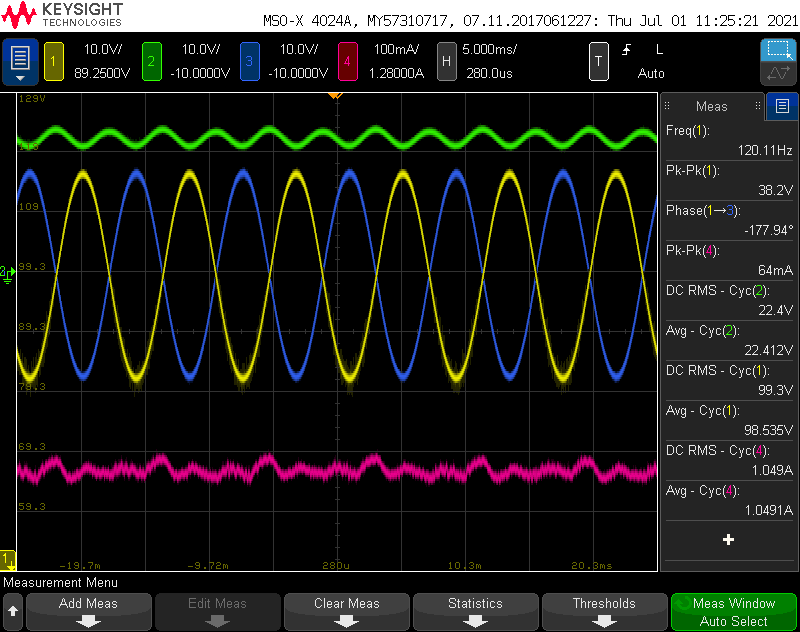
LabResults/7-1-2021/chargeinjection_scope/scope_1.png
