kefernandez/SSB_ChargeInjection/LabResults/7-1-2021/chargeinjection_scope_finaltest/scope_51.png

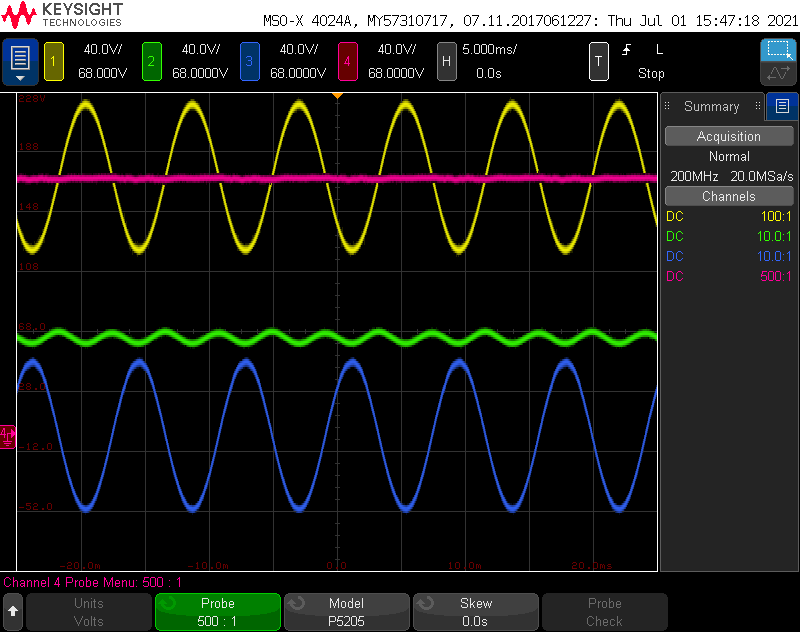
LabResults/7-1-2021/chargeinjection_scope_finaltest/scope_51.png
