kefernandez/SSB_ChargeInjection/LabResults/7-1-2021/traditional_PA_finaltest/IntegraVision_6.png

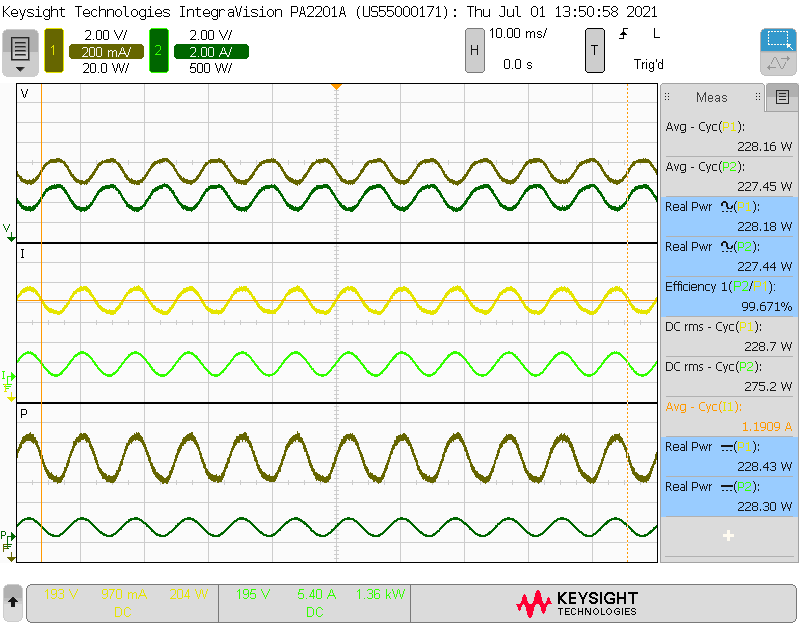
LabResults/7-1-2021/traditional_PA_finaltest/IntegraVision_6.png
