kefernandez/SSB_ChargeInjection/LabResults/7-1-2021/traditional_scope_finaltest/scope_6.png

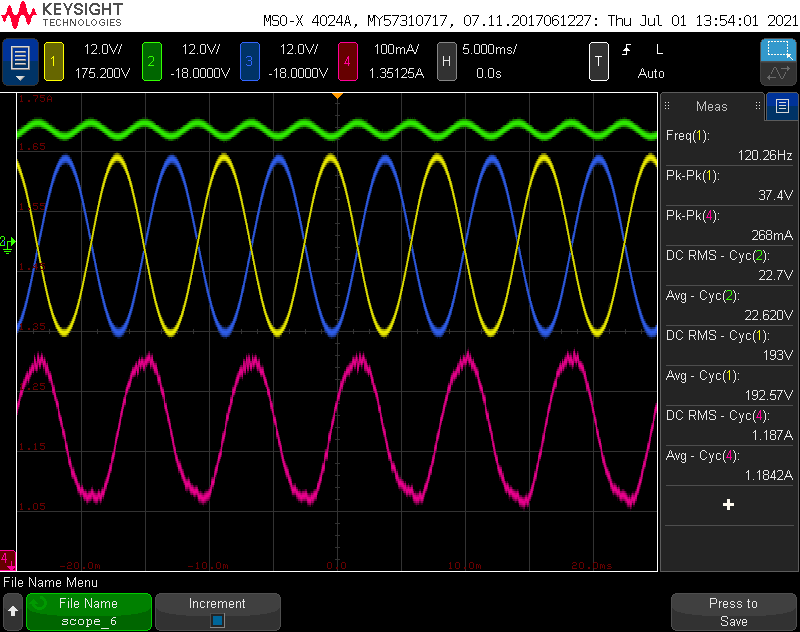
LabResults/7-1-2021/traditional_scope_finaltest/scope_6.png
