kefernandez/SSB_ChargeInjection/LabResults/10-1-2021/PowerAnalyzer_ChargeInjection/IntegraVision_13.png

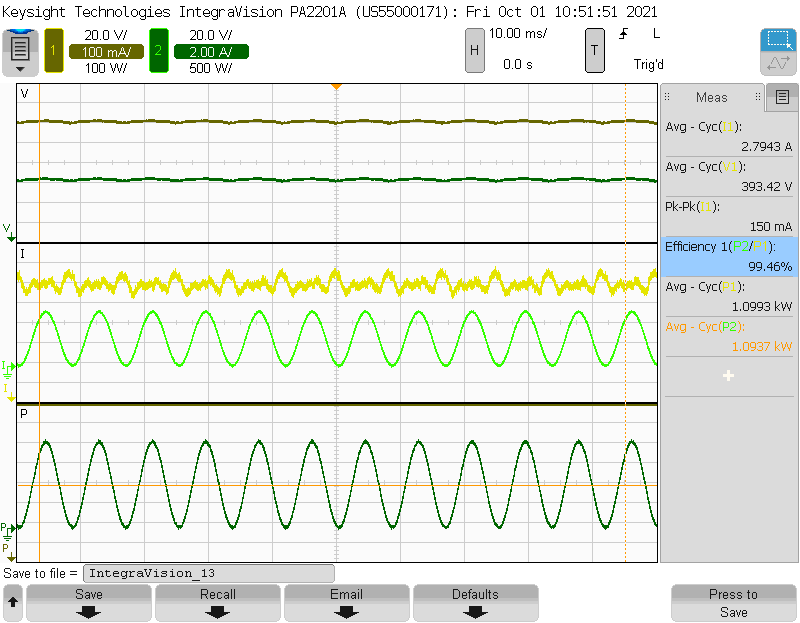
LabResults/10-1-2021/PowerAnalyzer_ChargeInjection/IntegraVision_13.png
