kefernandez/SSB_ChargeInjection/LabResults/10-1-2021/PowerAnalyzer_Traditional/IntegraVision_5.png

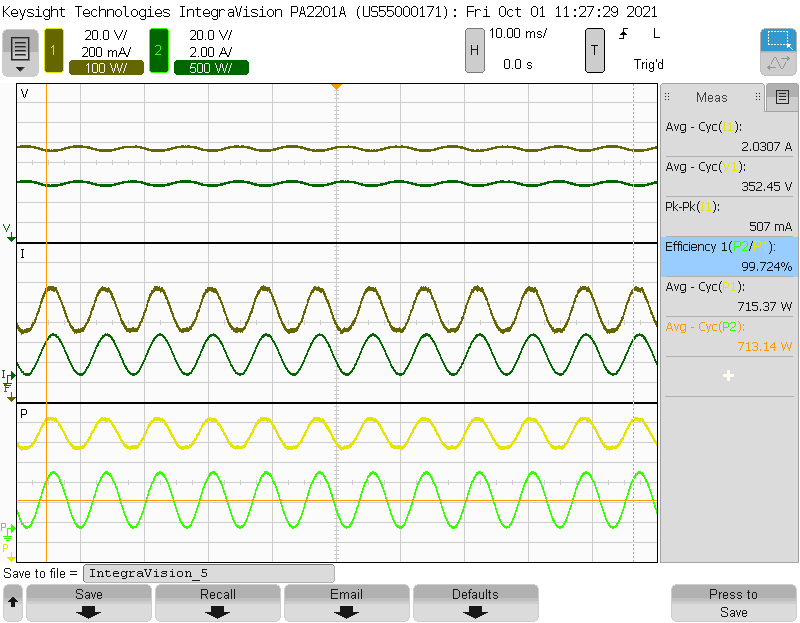
LabResults/10-1-2021/PowerAnalyzer_Traditional/IntegraVision_5.png
