kefernandez/SSB_ChargeInjection/LabResults/10-1-2021/PowerAnalyzer_Traditional/IntegraVision_17.png

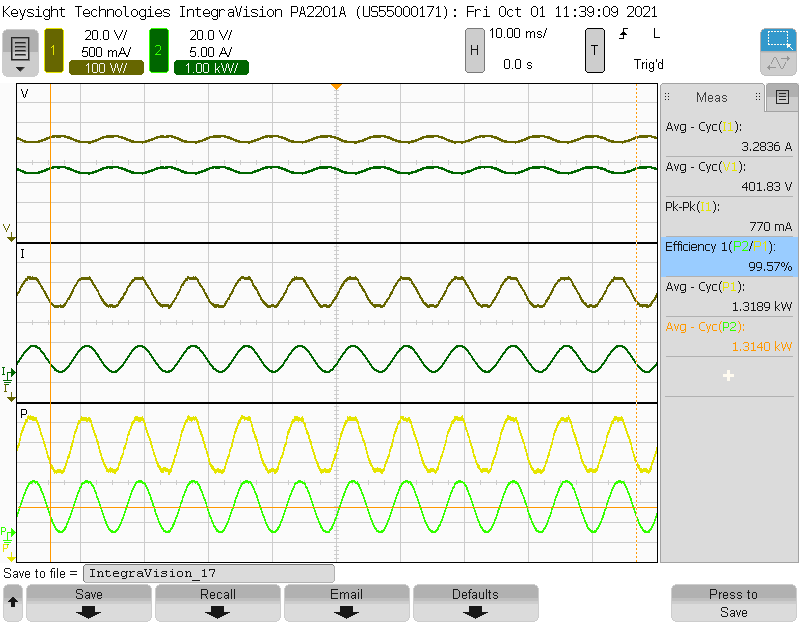
LabResults/10-1-2021/PowerAnalyzer_Traditional/IntegraVision_17.png
