kefernandez/SSB_ChargeInjection/LabResults/10-1-2021/Scope_ChargeInjection/ChargeInjection_1500W_Labeled.png

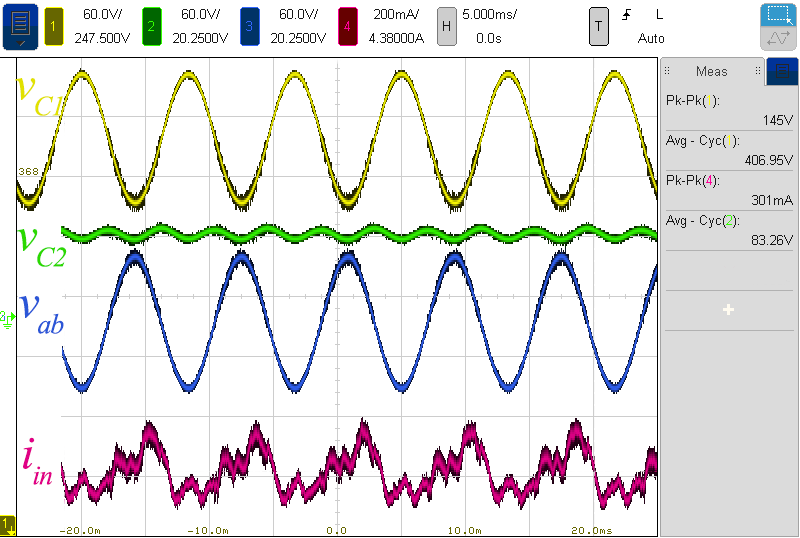
LabResults/10-1-2021/Scope_ChargeInjection/ChargeInjection_1500W_Labeled.png
