kefernandez/SSB_ChargeInjection/LabResults/10-1-2021/Scope_ChargeInjection/Scope7.png

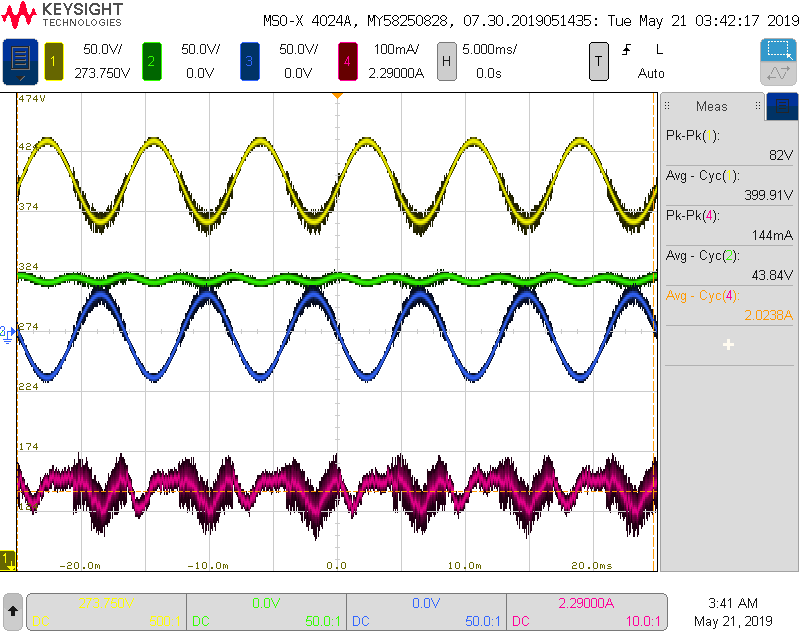
LabResults/10-1-2021/Scope_ChargeInjection/Scope7.png
