kefernandez/SSB_ChargeInjection/LabResults/10-1-2021/Scope_Traditional/Scope15.png

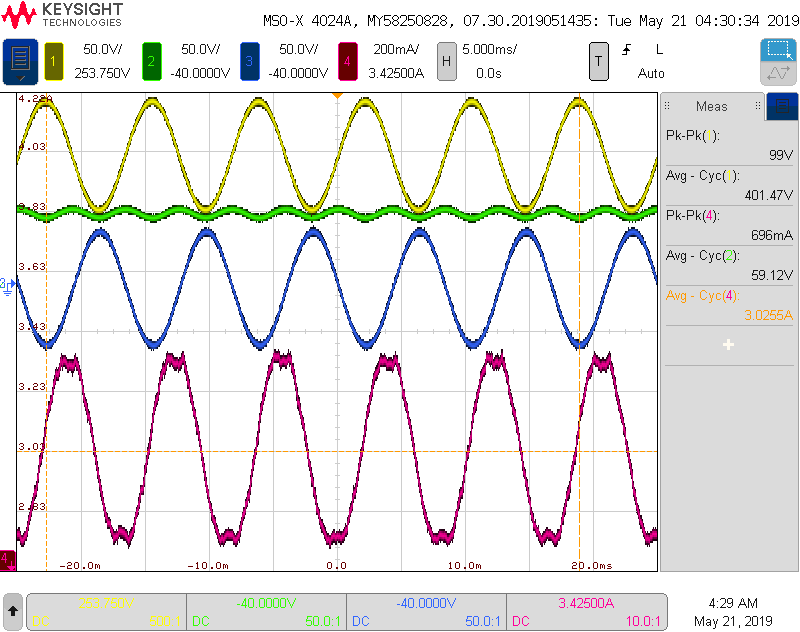
LabResults/10-1-2021/Scope_Traditional/Scope15.png
