kefernandez/SSB_ChargeInjection/LabResults/10-1-2021/Scope_Traditional/Scope21.png

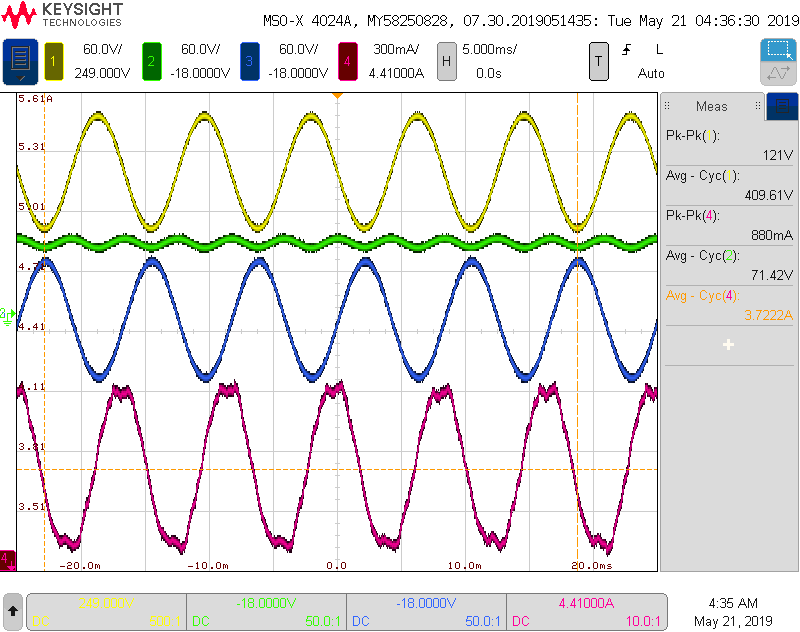
LabResults/10-1-2021/Scope_Traditional/Scope21.png
