kefernandez/SSB_ChargeInjection/Simulation/Simulations_fromHardDrive/SSB_ci_presentation/positive load step/vc1_vc2_vab_vbus.pdf

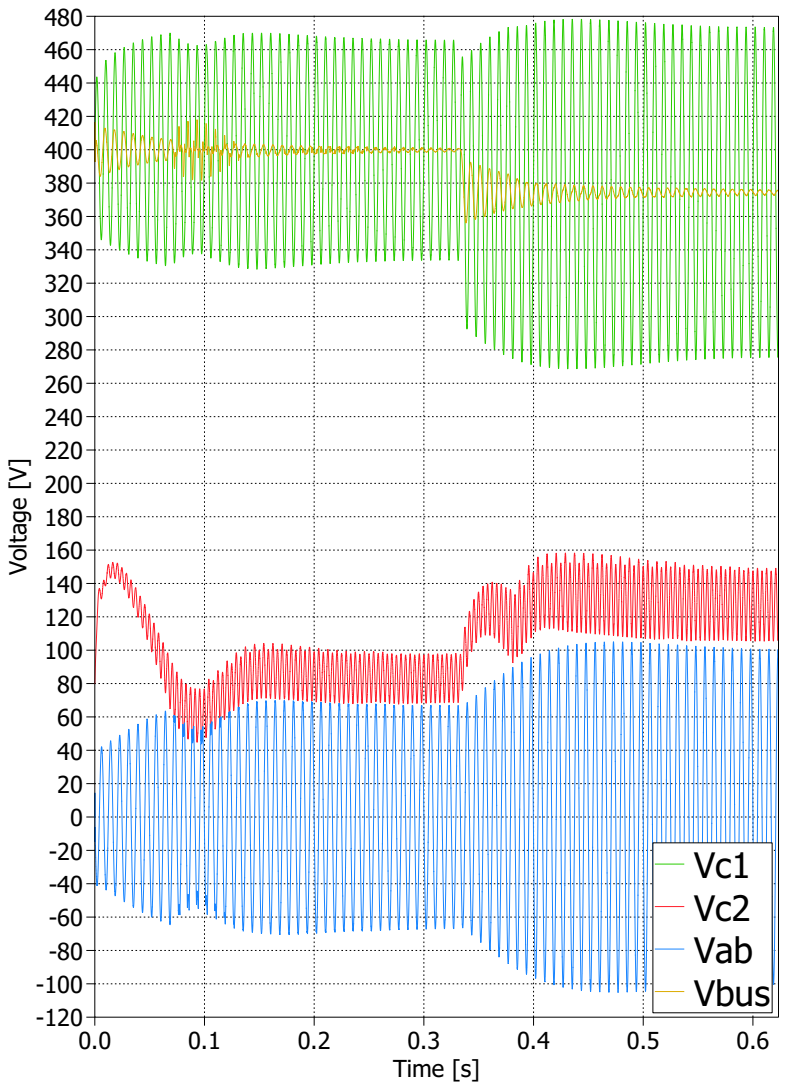
[picture p324: page 1]
Time [s] 0.0; 0.6 Voltage [V] -120 ⁻100 ⁻80 ⁻60 ⁻40 ⁻20020406080 100 120 140 160 180 200 220 240 260 280 300 320 340 360 380 400 420 440 460 480; Vc1 Vc2 Vab Vbus
