kefernandez/SSB_ChargeInjection/Simulation/Simulations_fromHardDrive/SSB_ci_presentation/pre layout/currents decreasing load step.pdf

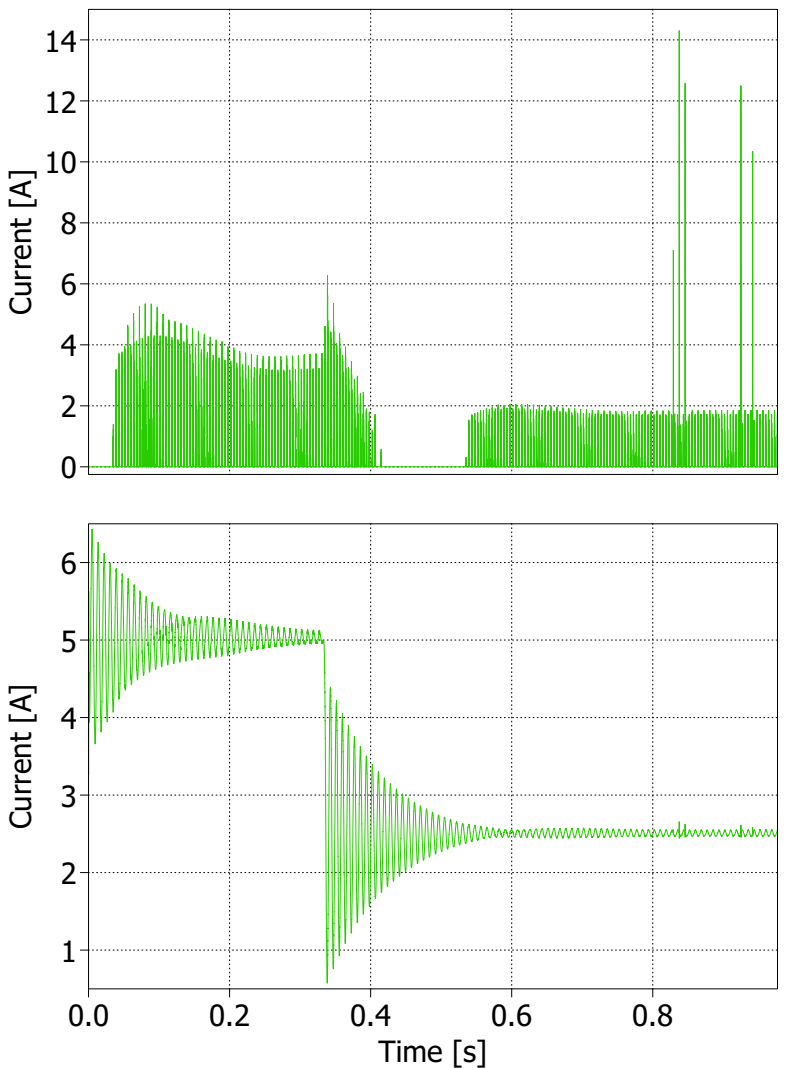
[picture p325: page 1]

Current [A] 02468101214 Time [s] 0.0 0.2 0.4 0.6 0.8 Current [A] 123456
