kefernandez/SSB_ChargeInjection/Simulation/Simulations_fromHardDrive/SSB_ci_presentation/pre layout/currents inreasing load step.pdf

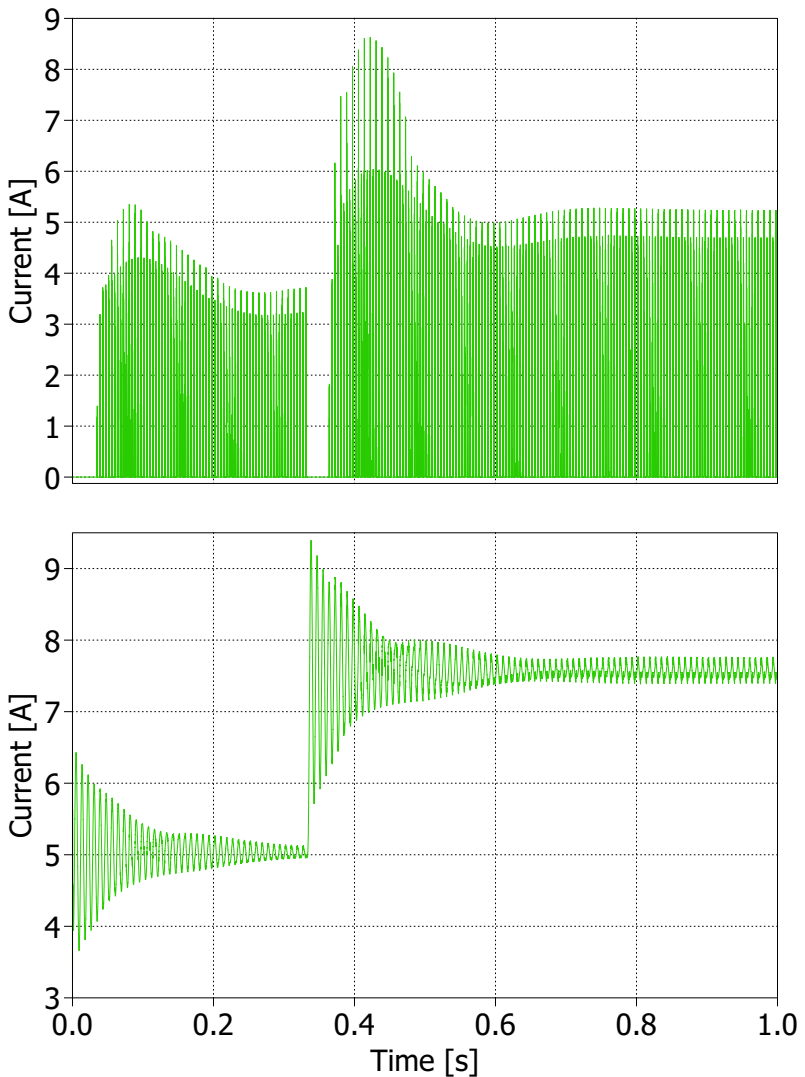
[picture p326: page 1]

Current [A] 0123456789 Time [s] 0.0 0.2 0.4 0.6 0.8 1.0 Current [A] 3456789
