kefernandez/SSB_ChargeInjection/Simulation/Simulations_fromHardDrive/SSB_ci_presentation/pre layout/currents no load step.pdf

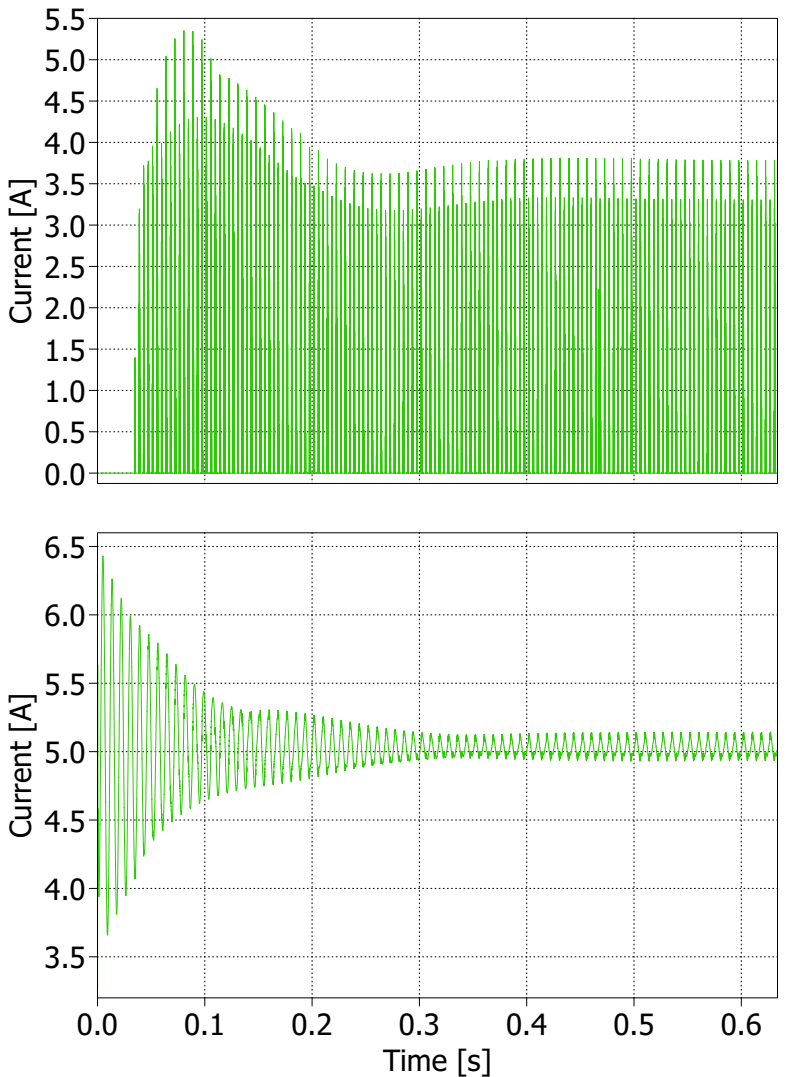
[picture p327: page 1]

Current [A] 0.0 0.5 1.0 1.5 2.0 2.5 3.0 3.5 4.0 4.5 5.0 5.5 Time [s] 0.0 0.1 0.2 0.3 0.4 0.5 0.6 Current [A] 3.5 4.0 4.5 5.0 5.5 6.0 6.5
