kefernandez/SSB_ChargeInjection/Simulation/Simulations_fromHardDrive/SSB_ci_presentation/pre layout/increasing load step/input dc current.pdf

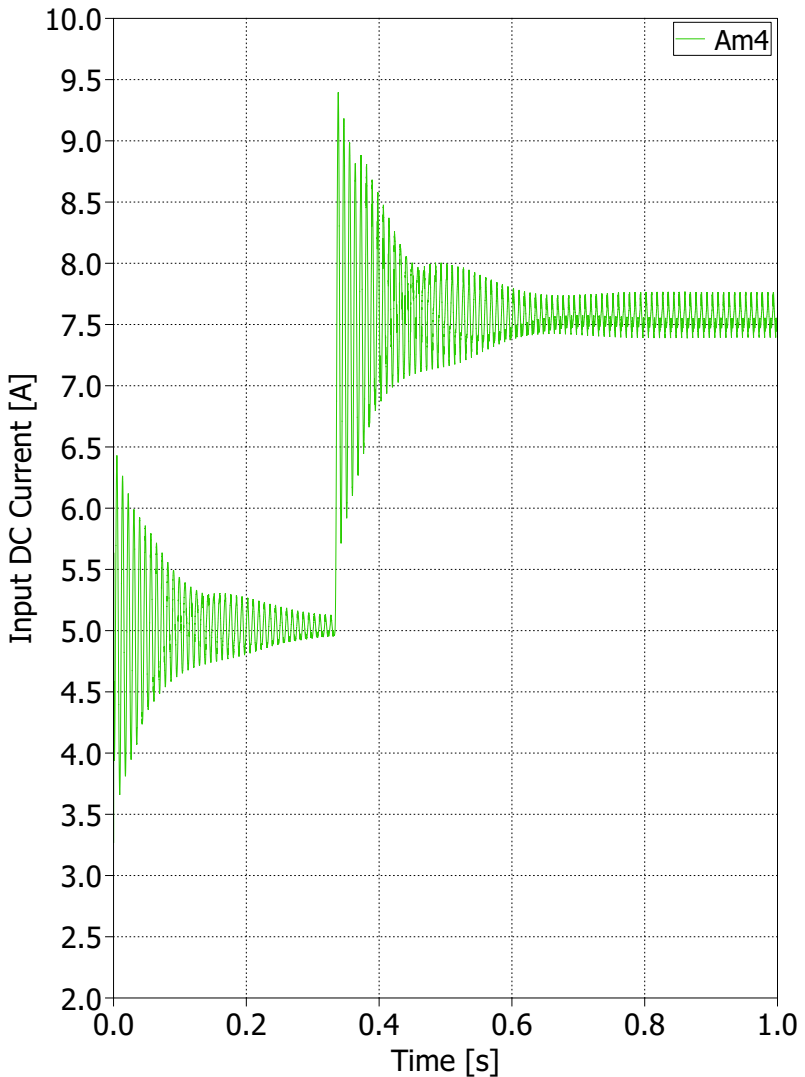
[picture p328: page 1]
Time [s] 0.0; 1.0 Input DC Current [A]
