kefernandez/SSB_ChargeInjection/Simulation/Simulations_fromHardDrive/SSB_ci_presentation/pre layout/increasing load step/voltages.pdf

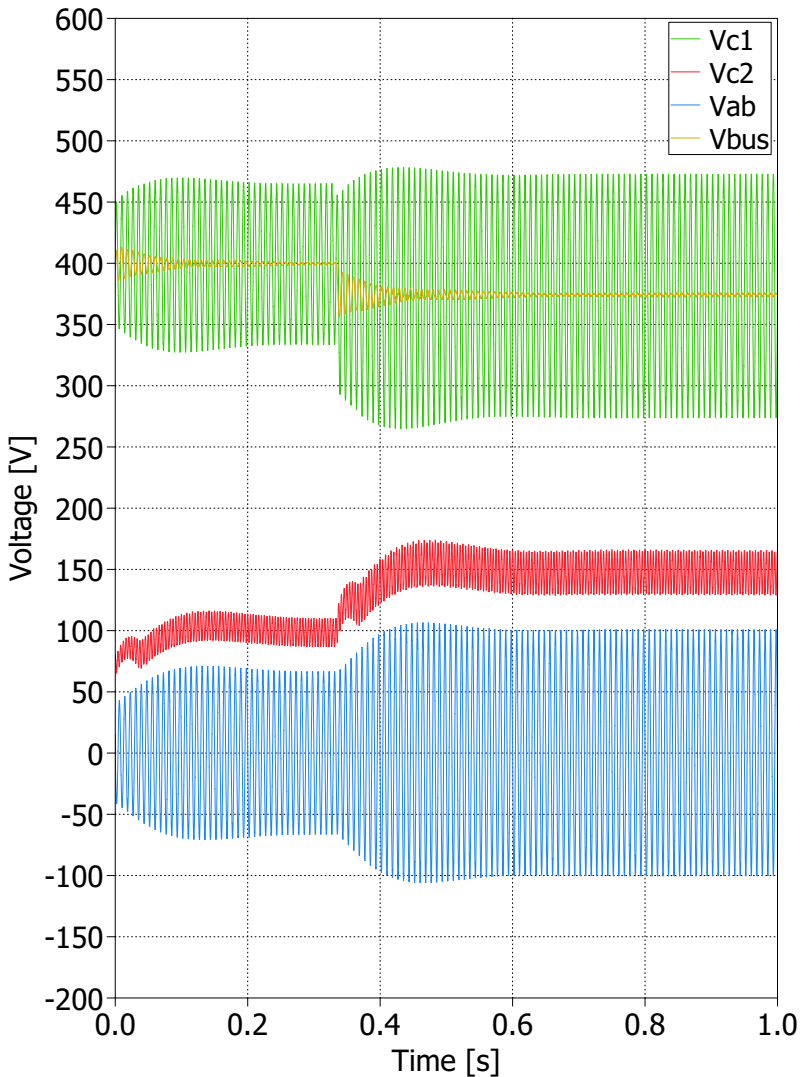
[picture p329: page 1]
Time [s] 0.0; 1.0 Voltage [V] -200 ⁻150 ⁻100 ⁻50050 100 150 200 250 300 350 400 450 500 550 600; Vc1 Vc2 Vab Vbus
