kefernandez/SSB_ChargeInjection/Graphics/Charge Injection/InkScape/ChargeInjection_ControlDiagram.pdf

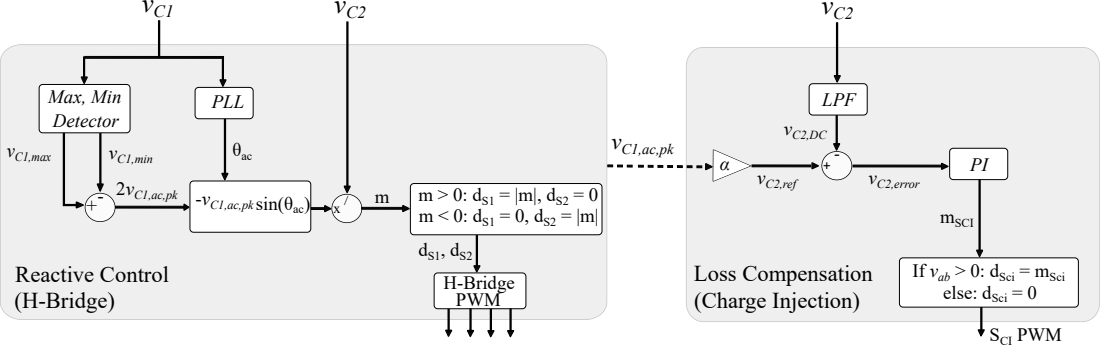
[picture p331: page 1]
Reactive Control; PLL; θac; Max, Min Detector; vC1,max; vC1,min; -vC1,ac,pk sin(θac); H-Bridge; LPF; vC2,ref; vC2,error; mSCI; (H-Bridge); PWM; (Charge Injection); SCI PWM; Loss Compensation

If vab > 0: dSci = mSci
else: dSci = 0
