kefernandez/SSB_ChargeInjection/Graphics/Charge Injection/InkScape/SSB_LossComp_ControlDiagram.pdf

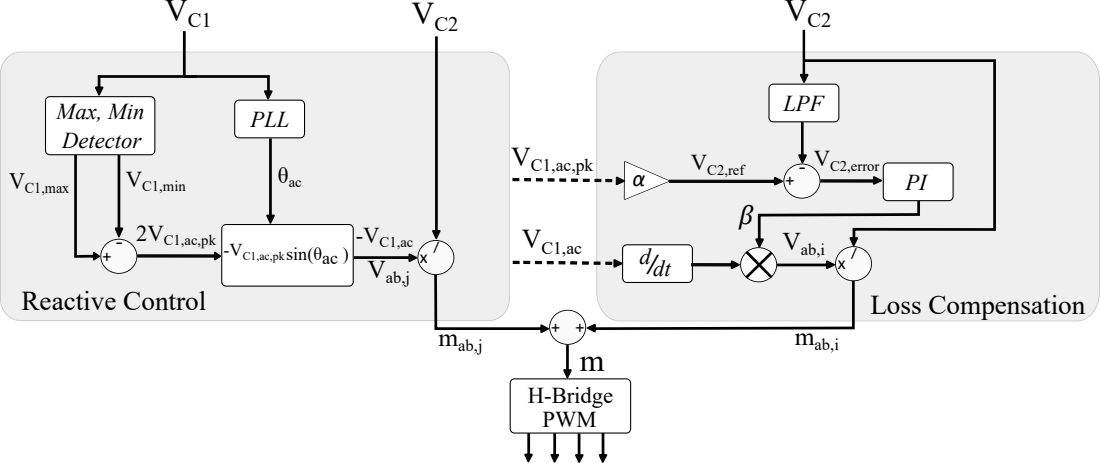
[picture p332: page 1]
Vab,j; PLL; θac; Max, Min Detector; VC1,max; VC1,min; -VC1,ac,pk sin(θac ); H-Bridge PWM; mab,j; mab,i; Vab,i; Loss Compensation; LPF; VC2,ref; VC2,error; Reactive Control
