kefernandez/SSB_ChargeInjection/Graphics/Charge Injection/InkScape/circuit with waveform/SSB_CCM.pdf

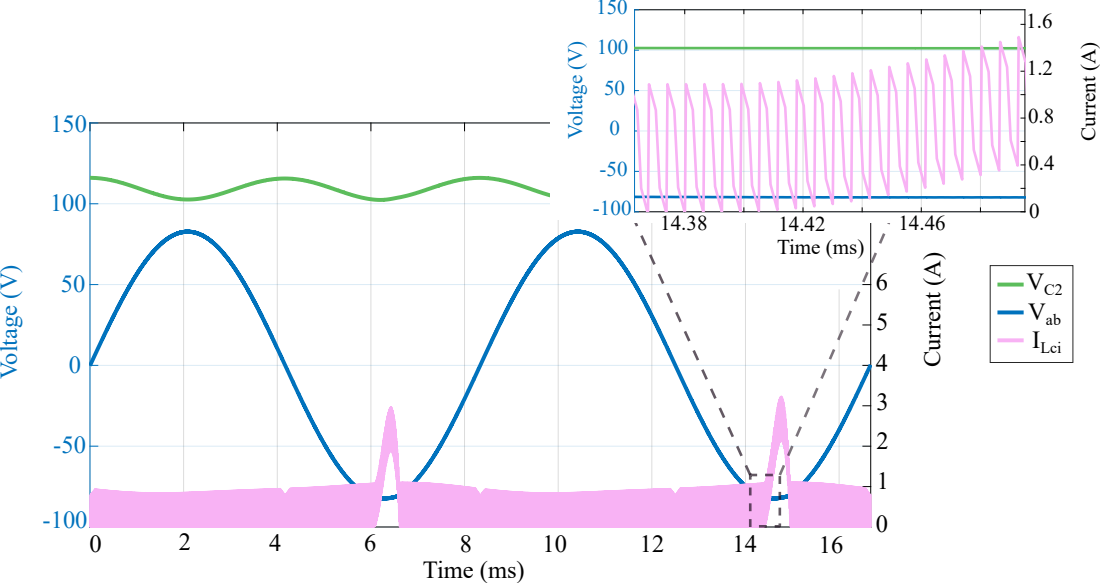
[picture p333: page 1]
Vab; Voltage (V); VC2 ILci; Current (A); Time (ms)
