kefernandez/SSB_ChargeInjection/Graphics/Charge Injection/InkScape/circuit with waveform/SSB_chargeinjectionwaveforms.pdf

## vab+- vC1

# IIn (A) VBus (V) VC1 (V) VC2 (V) Vab (V)

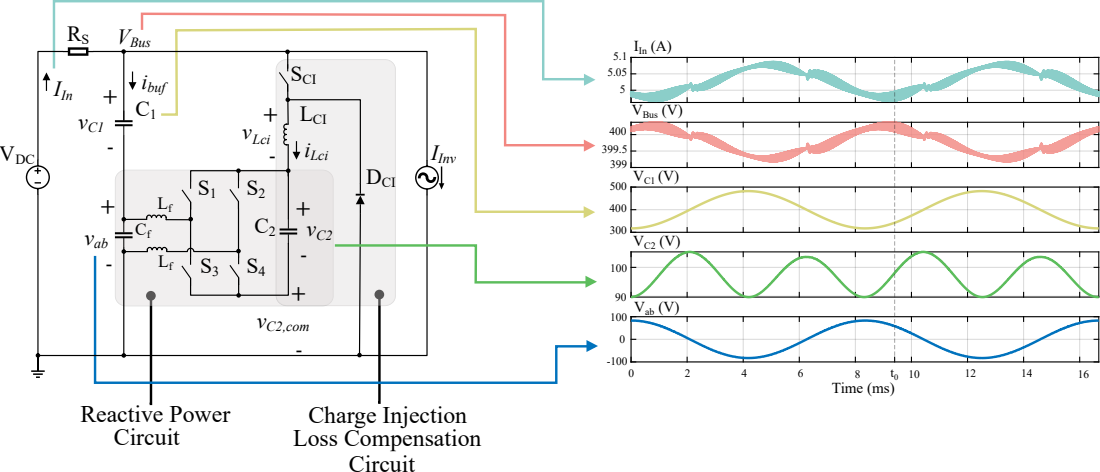
[picture p334: page 1]
Reactive Power; Circuit; Charge Injection; Loss Compensation Circuit; VDC; SCI; DCI; IInv; LCI; VBusibuf; IIn; iLci; +- vLci; vC2,com; Time (ms)t 0
