kefernandez/SSB_ChargeInjection/Graphics/Charge Injection/InkScape/circuit with waveform/SSB_chargeinjectionwaveforms_1500W.pdf

## vab+- vC1

# n (A) Vbus (V) VC1 (V) VC2 (V) Vab (V)

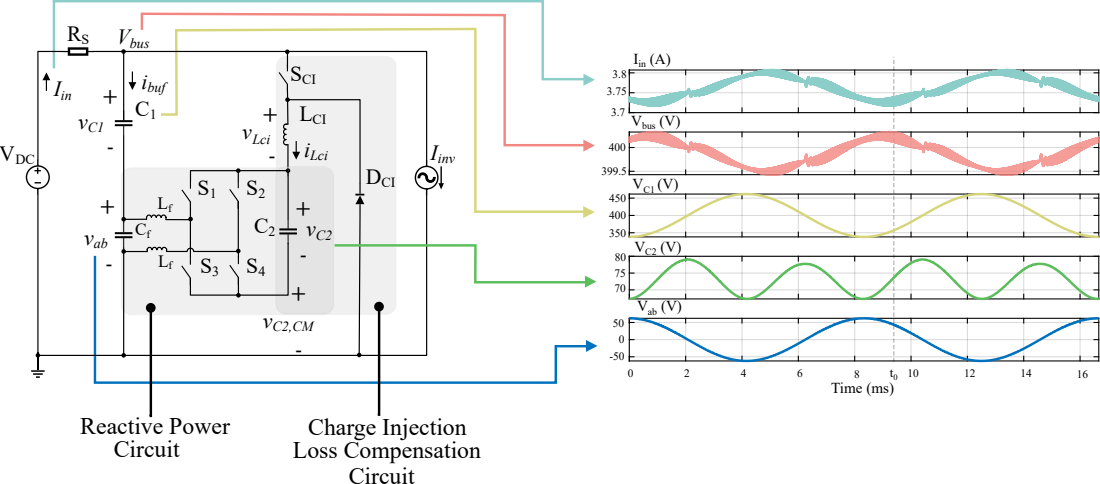
[picture p335: page 1]
VDC; SCI; DCI; Iinv; LCI; Vbusibuf; Iin; iLci; +- vLci; Time (ms)t 0; Circuit; Reactive Power; Charge Injection; Loss Compensation
