kefernandez/SSB_ChargeInjection/Graphics/Charge Injection/InkScape/circuit with waveform/SSB_NoLossComp.pdf

## VC1 VC2 VBus

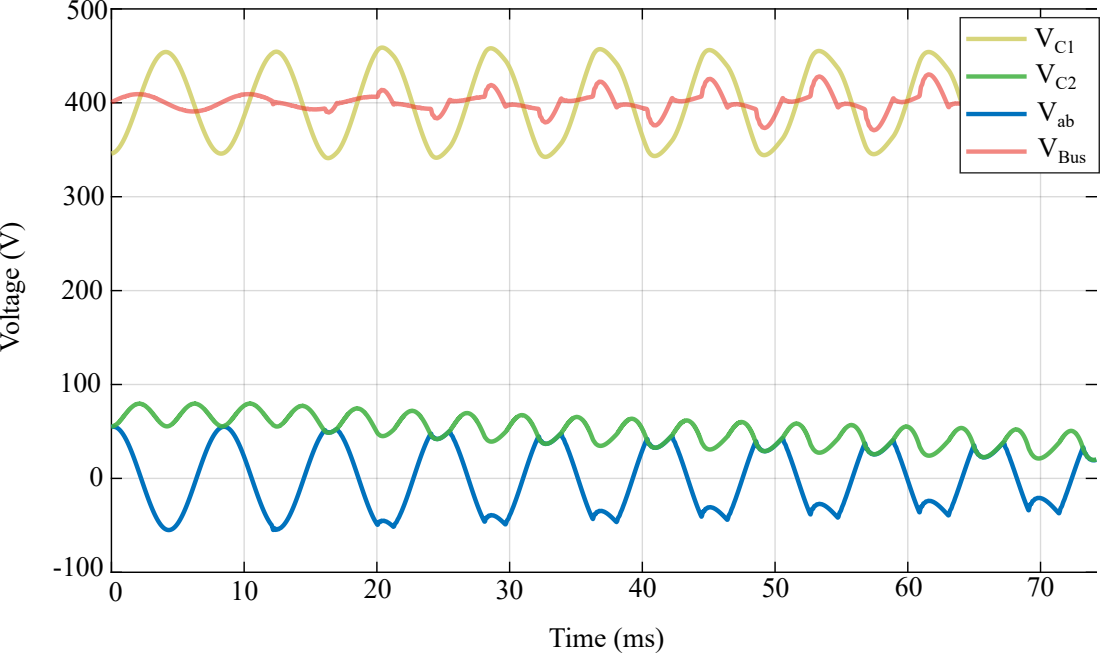
[picture p337: page 1]
Vab; Time (ms); Voltage (V)
