kefernandez/SSB_ChargeInjection/Buffer/Printing Print.pdf

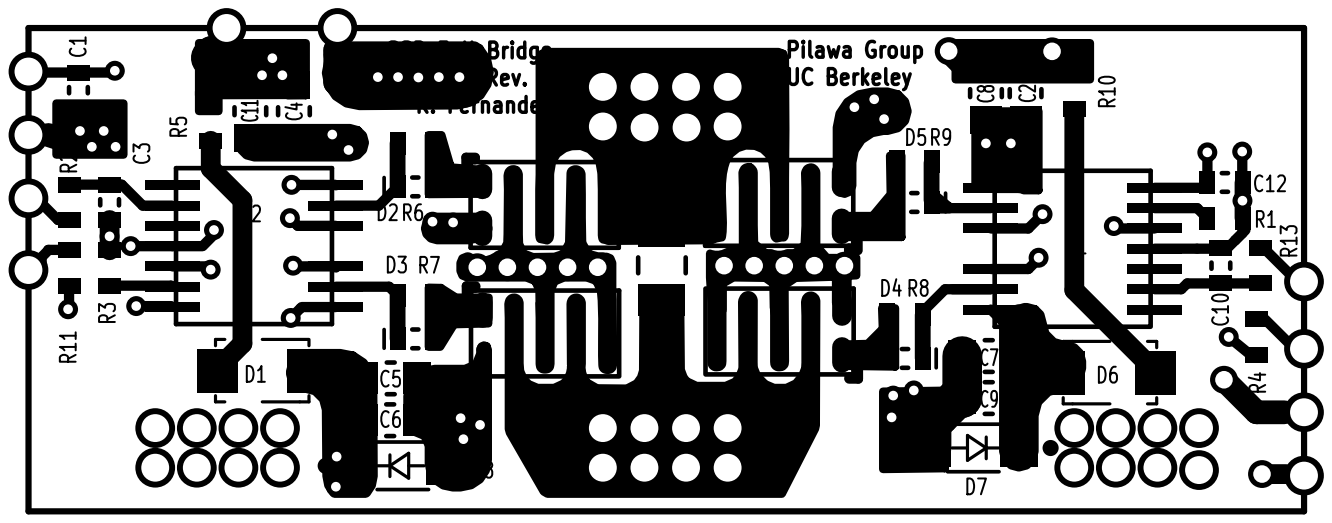
[picture p338: page 1]
