kefernandez/SSB_ChargeInjection/Graphics/Charge Injection/InkScape/ChargeInjectionOperationWaveforms.pdf

RS

C1

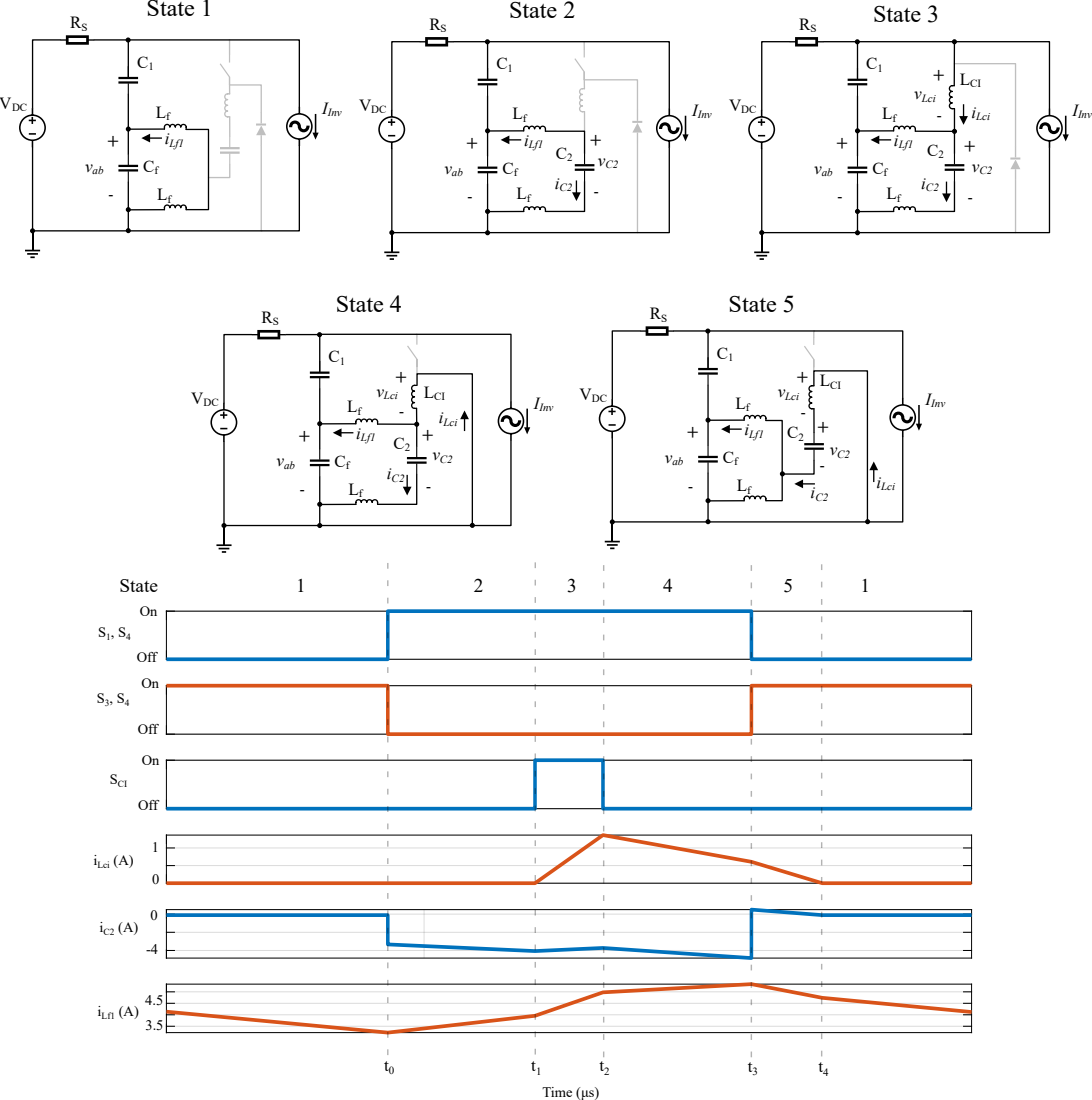
[picture p339: page 1]
iLf1 (A); Off; iLci (A); SCI; Time (μs); VDC; IInv f; vab; iLf1; State; State 1; State 2; State 3; State 4; State 5; IInv; LCI; iLci; vLci; iLci iC2
