kefernandez/SSB_ChargeInjection/Graphics/Charge Injection/TestResults/Efficiency_Ripple_CI_Results.pdf

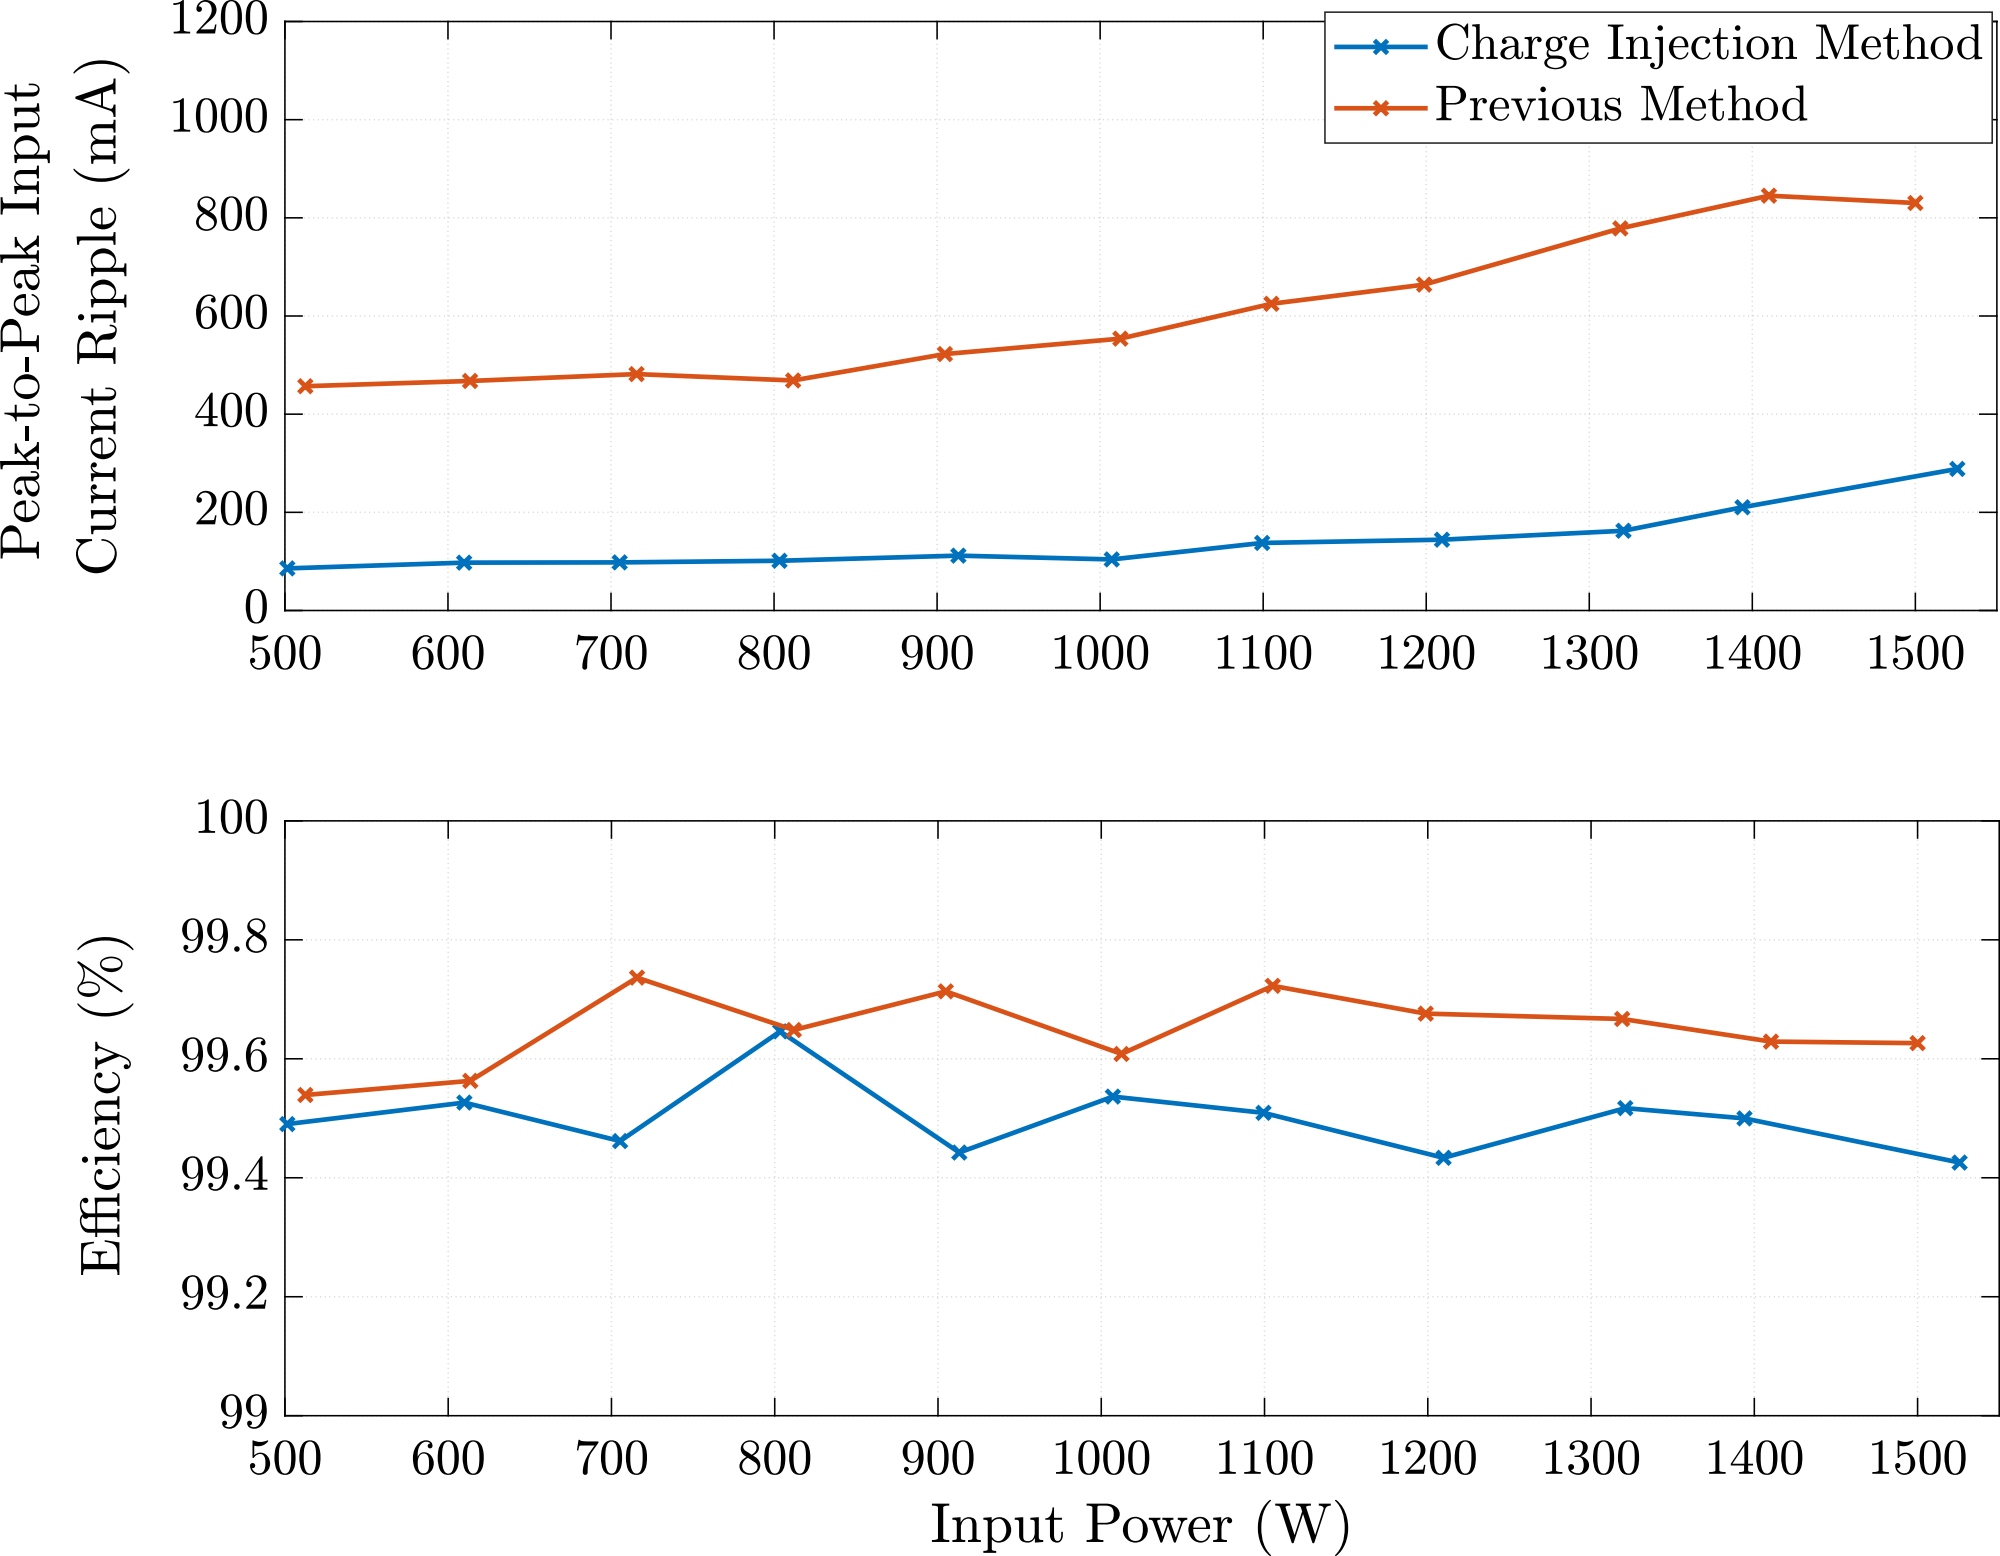
[picture p340: page 1]
