kefernandez/SSB_ChargeInjection/Graphics/Charge Injection/Visio/ChargeInjection_Schematic.pdf

R

C

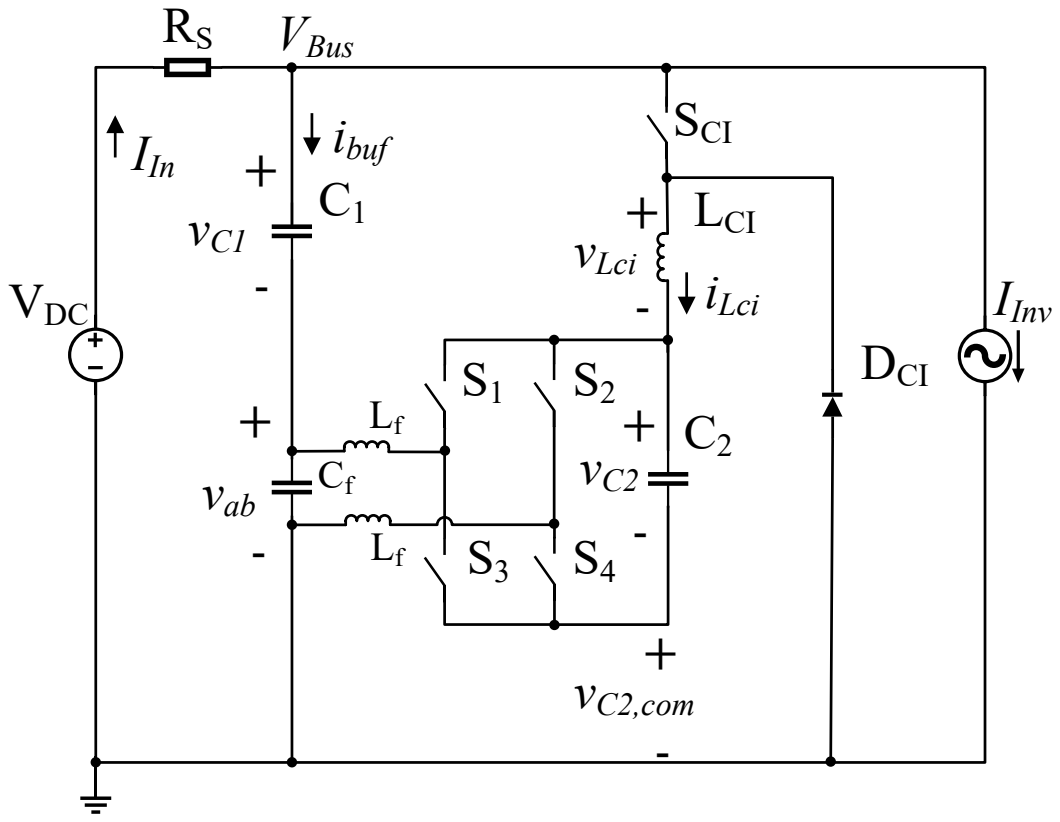
[picture p341: page 1]
VDC; SCI; DCI; IInv; LCI; vab+- vC1; VBusibuf; IIn; iLci; +- vLci; +- vC2,com
