kefernandez/SSB_ChargeInjection/Graphics/Charge Injection/Visio/ChargeInjection_Schematic_loadstep_pres.pdf

R

C

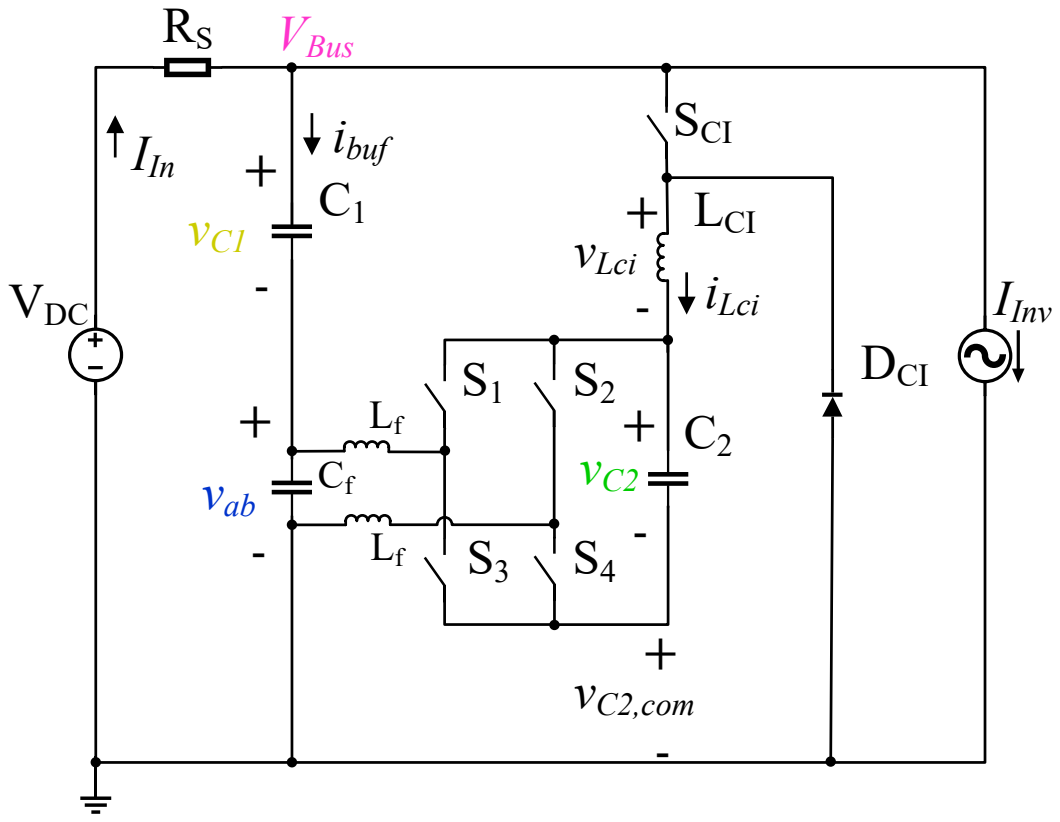
[picture p342: page 1]
VDC; SCI; DCI; IInv; LCI; vab+- vC1; VBusibuf; IIn; iLci; +- vLci; +- vC2,com
