kefernandez/SSB_ChargeInjection/Graphics/Charge Injection/Visio/SSB_Schematic.pdf

R

+-

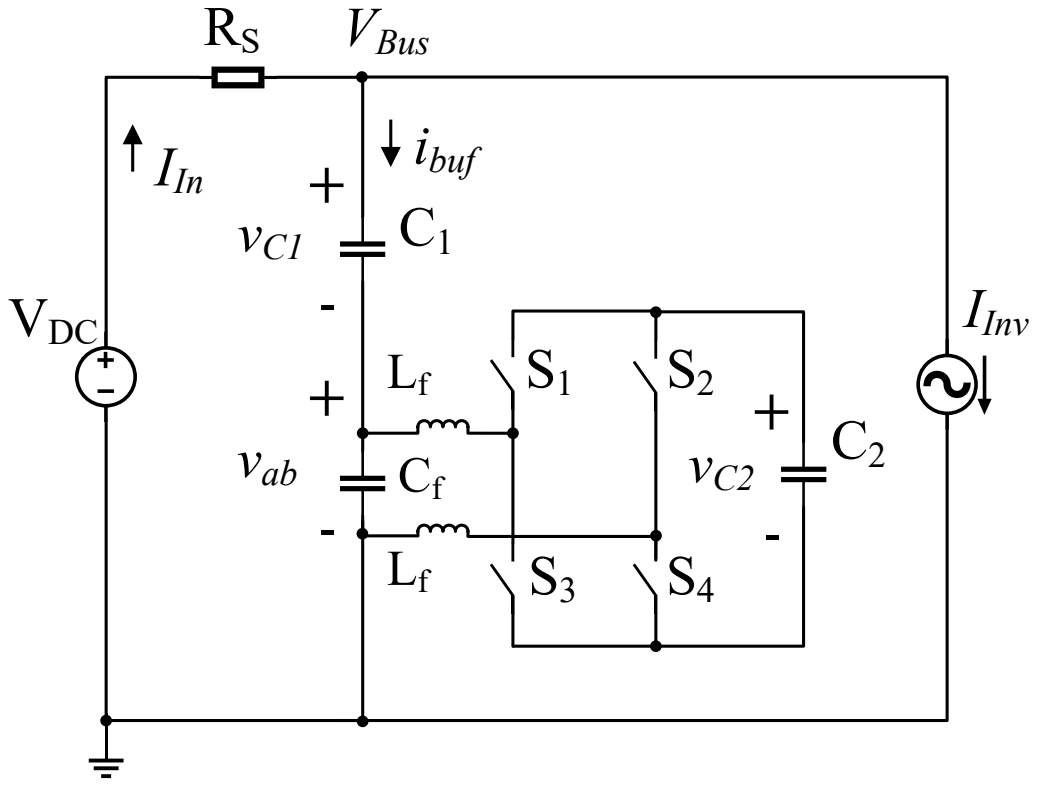
[picture p344: page 1]
VDC; IInv; vab; VBusibuf; IIn
