kefernandez/SSB_ChargeInjection/Graphics/Charge Injection/Visio/SSB_Schematic_lessannotations.pdf

R

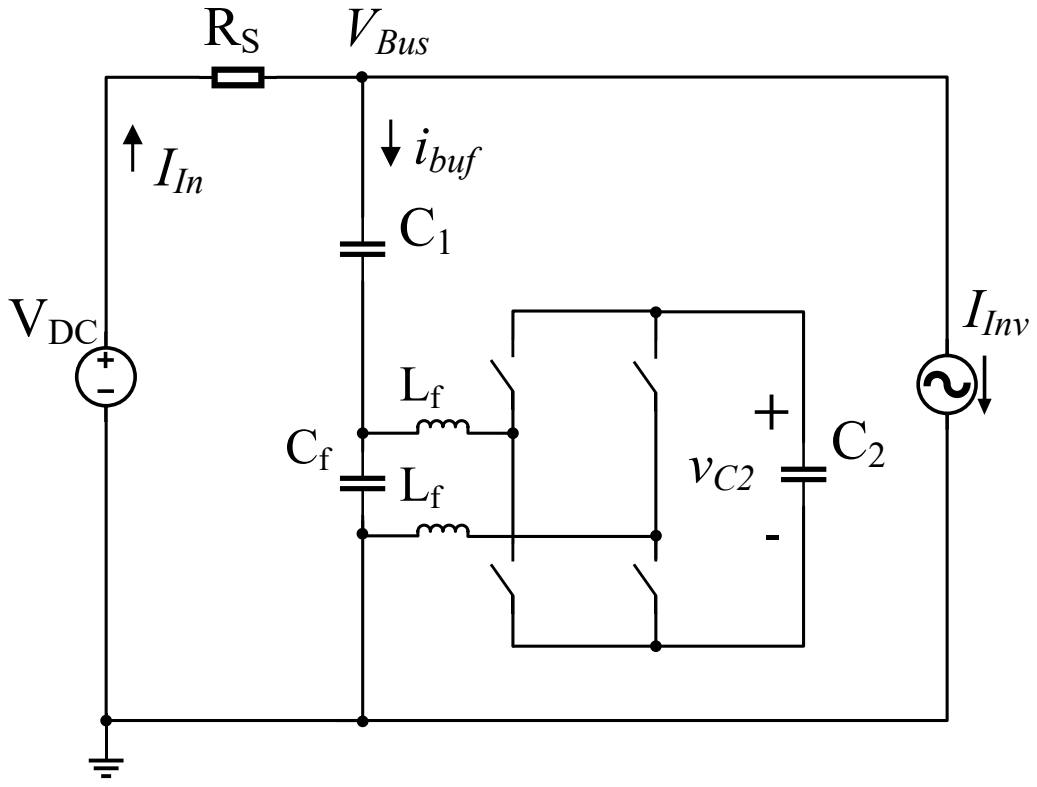
[picture p345: page 1]
VDC; IInv; VBusibuf; IIn
