kefernandez/SSB_ChargeInjection/Graphics/Charge Injection/InkScape/switching waveforms/ChargeInjectionOperationWaveforms_noIlf1.pdf

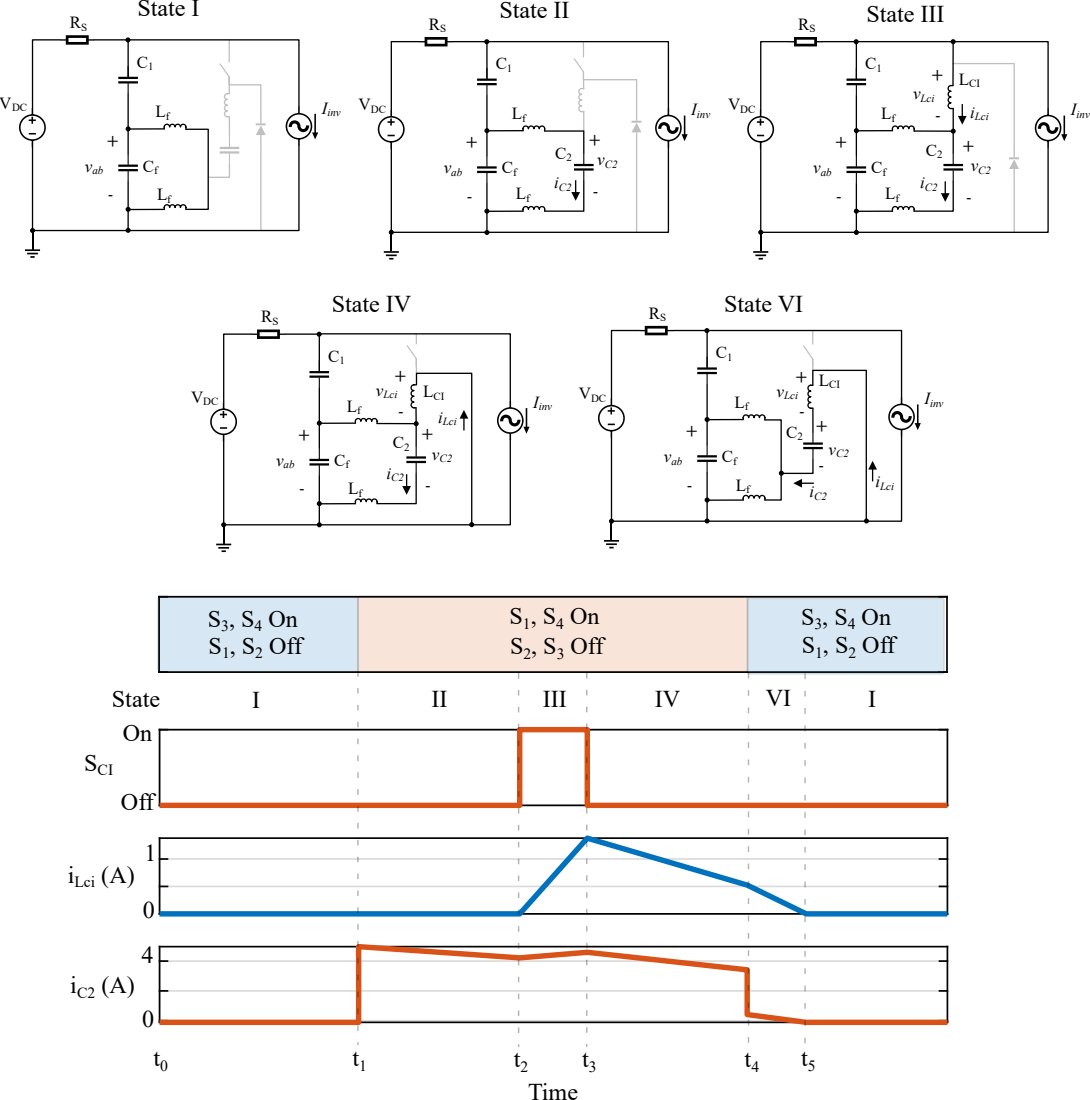
[picture p346: page 1]
VDC; Iinv f; vab; State; III; State I; State II; State III; State IV; State VI; Iinv; LCI; iLci; vLci; iLci iC2; Time; S3, S4 On S1, S2 Off; S1, S4 On S2, S3 Off; Off; iLci (A); SCI
