kefernandez/SSB_ChargeInjection/Graphics/Charge Injection/InkScape/switching waveforms/ChargeInjectionOperationWaveformsv3.pdf

RS

C1

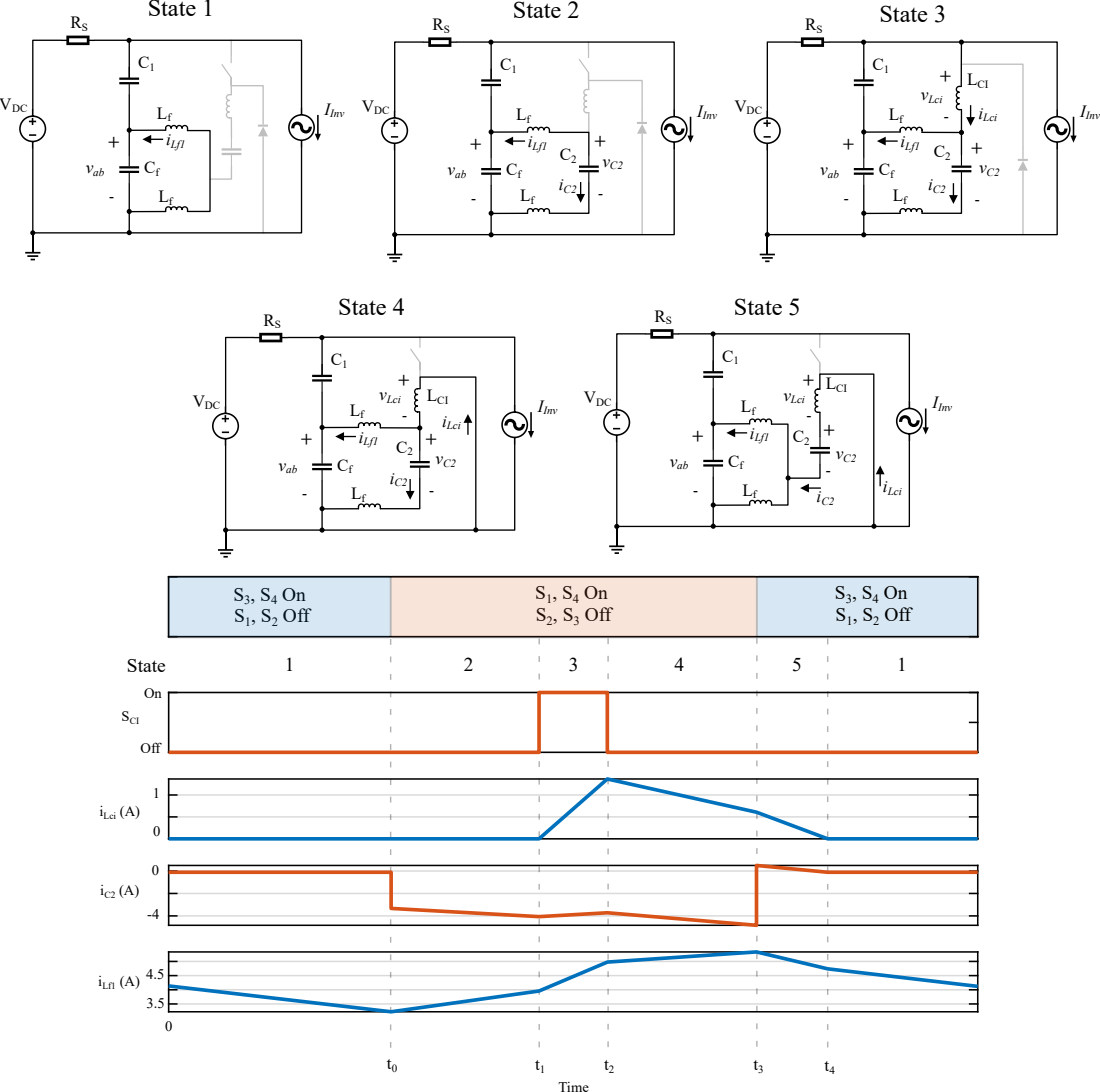
[picture p347: page 1]
iLf1 (A); Off; iLci (A); SCI; S3, S4 On S1, S2 Off; Time; VDC; IInv f; vab; iLf1; State; State 1; State 2; State 3; State 4; State 5; IInv; LCI; iLci; vLci; iLci iC2; S1, S4 On S2, S3 Off
