kefernandez/SSB_ChargeInjection/Graphics/Charge Injection/InkScape/switching waveforms/ChargeInjectionOperationWaveformsv4.pdf

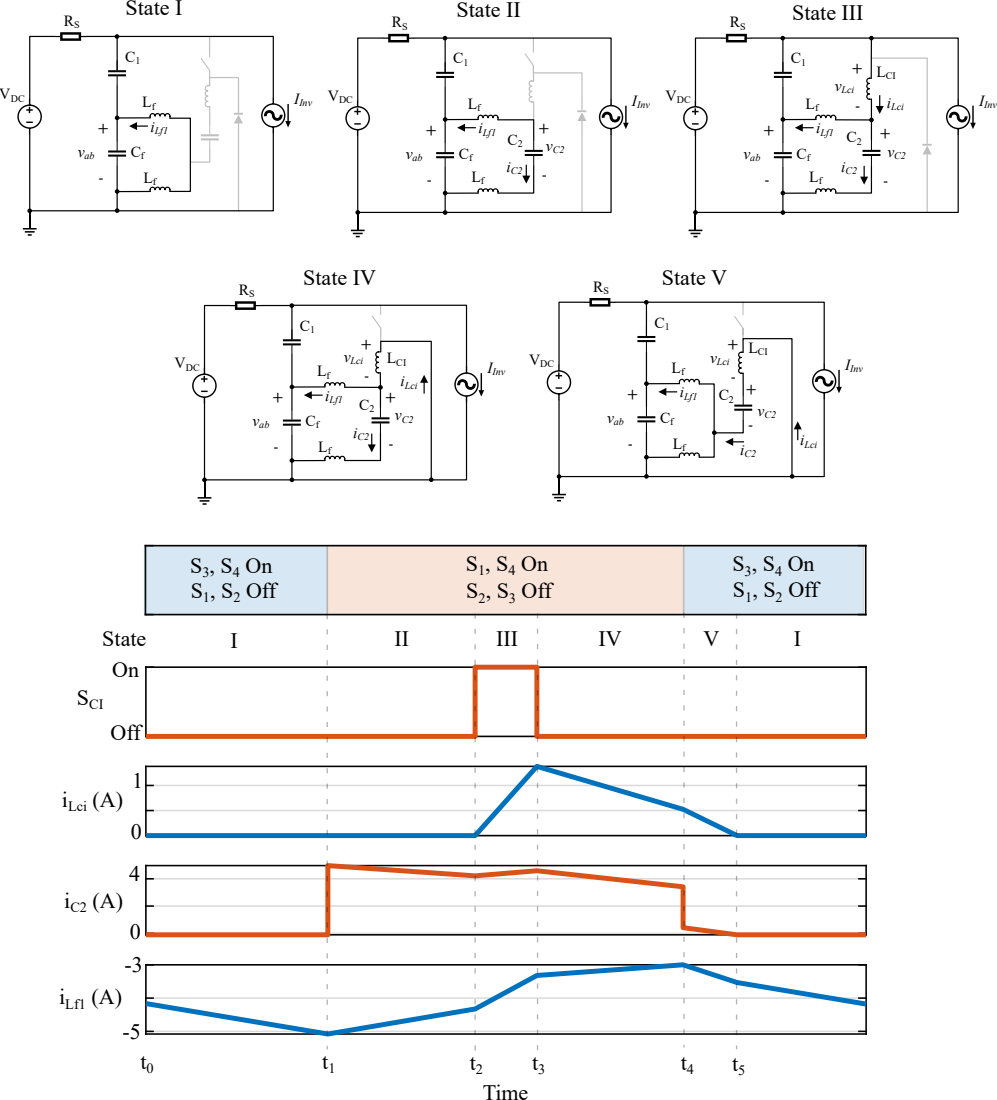
[picture p348: page 1]
VDC; IInv f; vab; iLf1; State; III; State I; State II; State III; State IV; State V; IInv; LCI; iLci; vLci; iLci iC2; Time; S3, S4 On S1, S2 Off; S1, S4 On S2, S3 Off; iLf1 (A); Off; iLci (A); SCI
