kefernandez/SSB_ChargeInjection/Simulation/Simulations_fromHardDrive/SSB_ci_presentation/negative load step/Idc.pdf

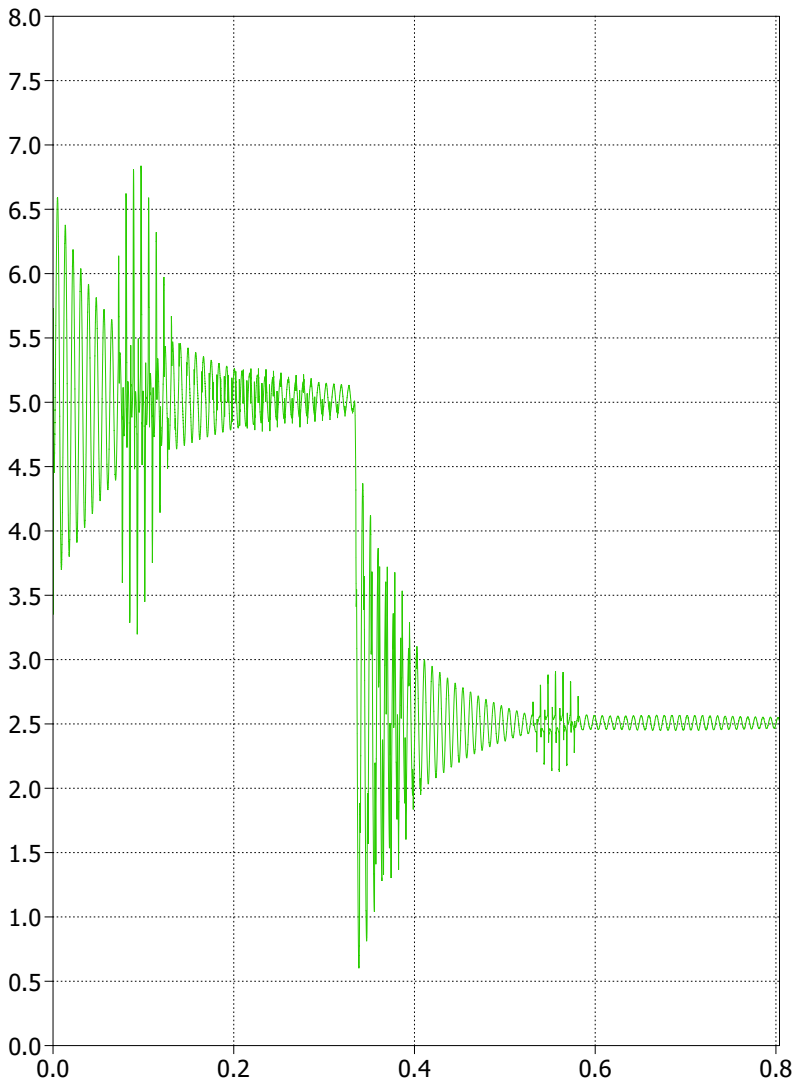
[picture p349: page 1]
