kefernandez/SSB_ChargeInjection/Simulation/Simulations_fromHardDrive/SSB_ci_presentation/positive load step/Idc.pdf

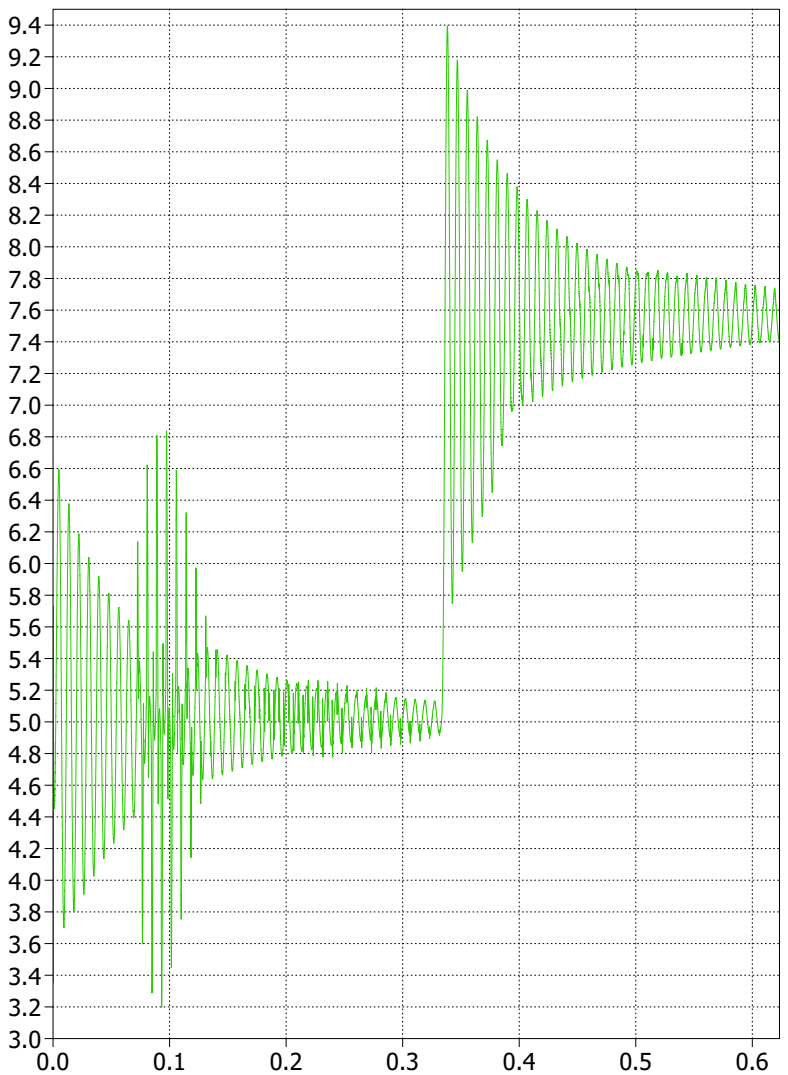
[picture p350: page 1]
