kefernandez/SSB_ChargeInjection/Loss_modeling/piechart.pdf

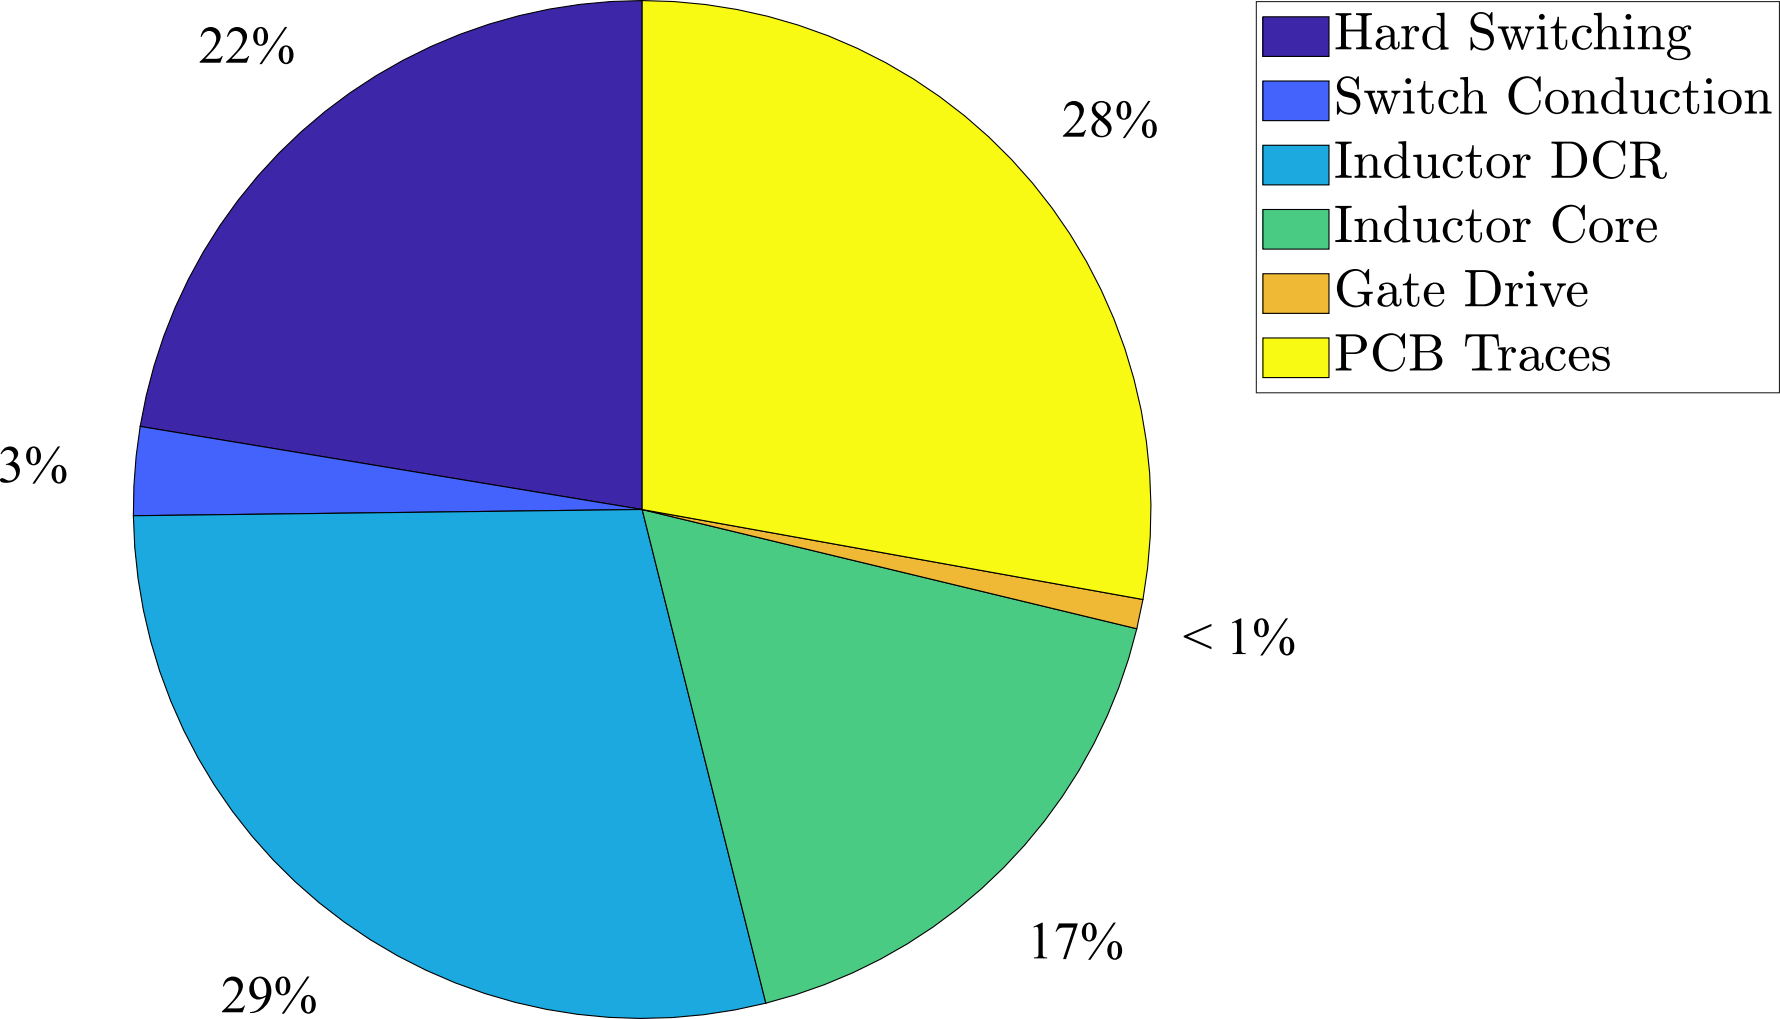
[picture p351: page 1]
