kefernandez/SSB_ChargeInjection/Buffer/BufferRevD_U1U2_Pin1.pdf

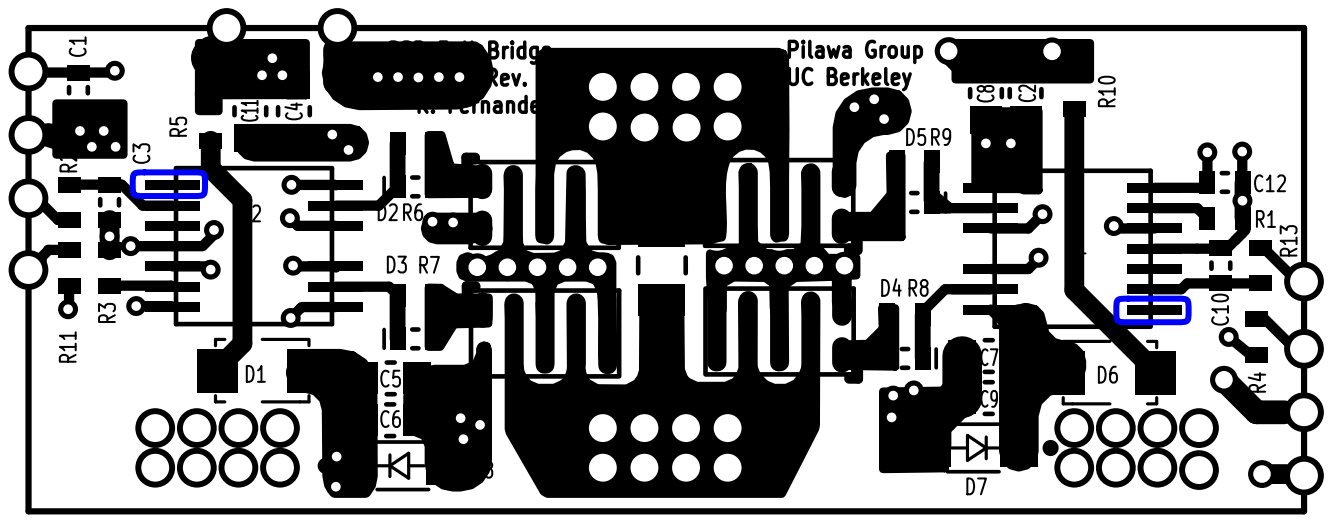
[picture p352: page 1]
