kefernandez/SSB_ChargeInjection/Buffer/BufferRevDGerbers_10-23-2021/FrontSilkScreen.pdf

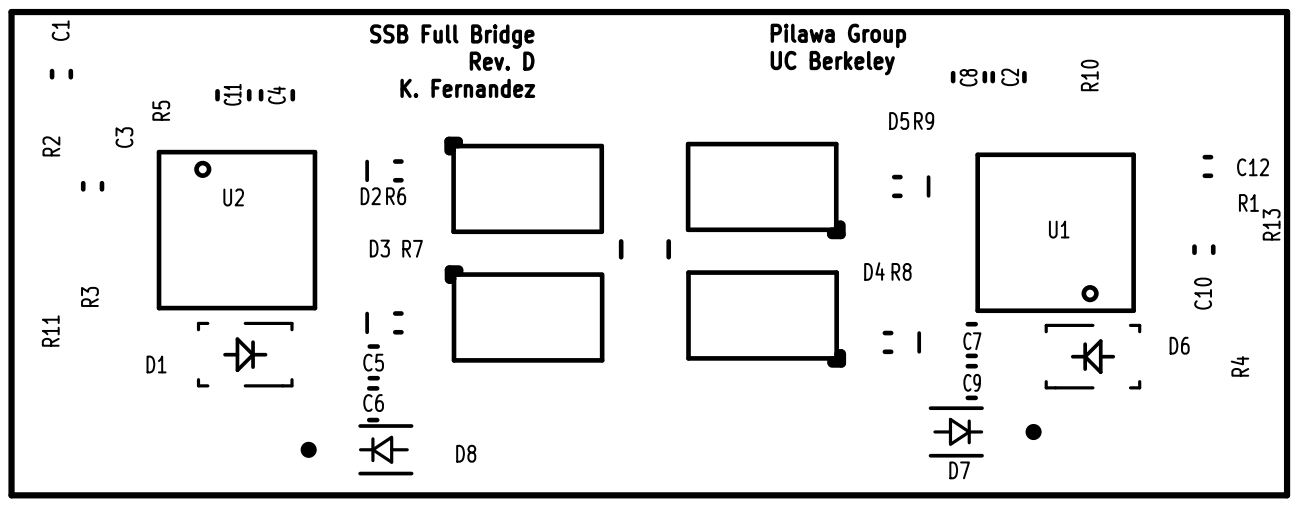
[picture p353: page 1]
