kefernandez/SSB_ChargeInjection/Buffer/BufferRevDGerbers2021/Buffer - Rev D-B_Cu.pdf

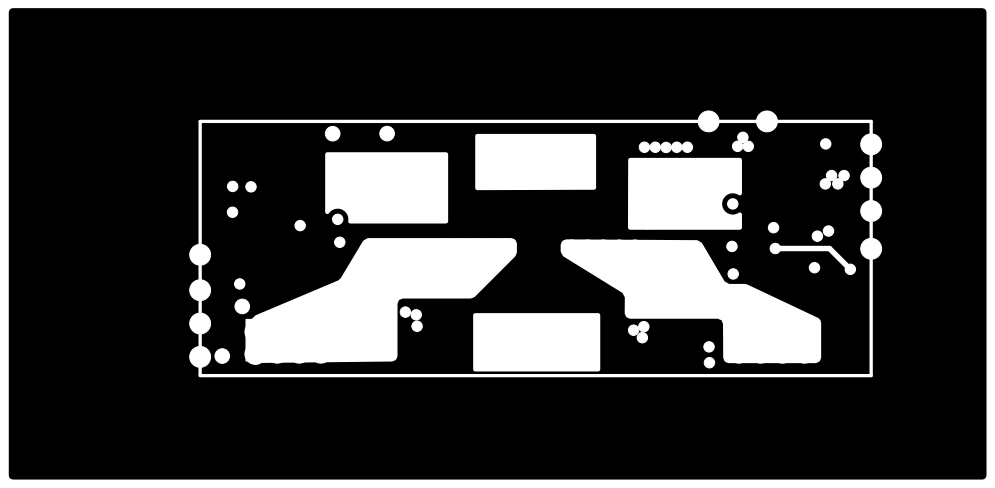
[picture p354: page 1]
