kefernandez/SSB_ChargeInjection/Buffer/BufferRevDGerbers2021/Buffer - Rev D-B_SilkS.pdf

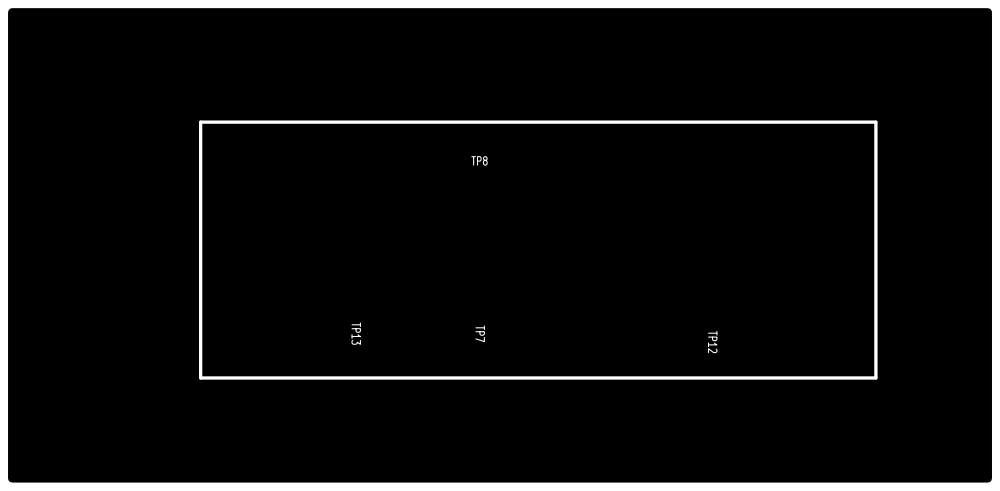
[picture p355: page 1]
