kefernandez/SSB_ChargeInjection/Buffer/BufferRevDGerbers2021/Buffer - Rev D-F_Cu.pdf

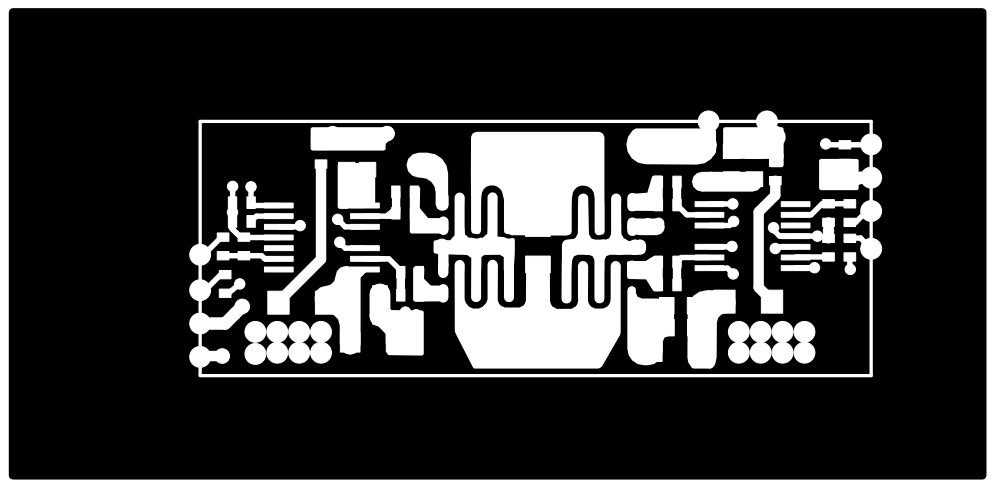
[picture p356: page 1]
