kefernandez/SSB_ChargeInjection/Buffer/BufferRevDGerbers2021/Buffer - Rev D-F_SilkS.pdf

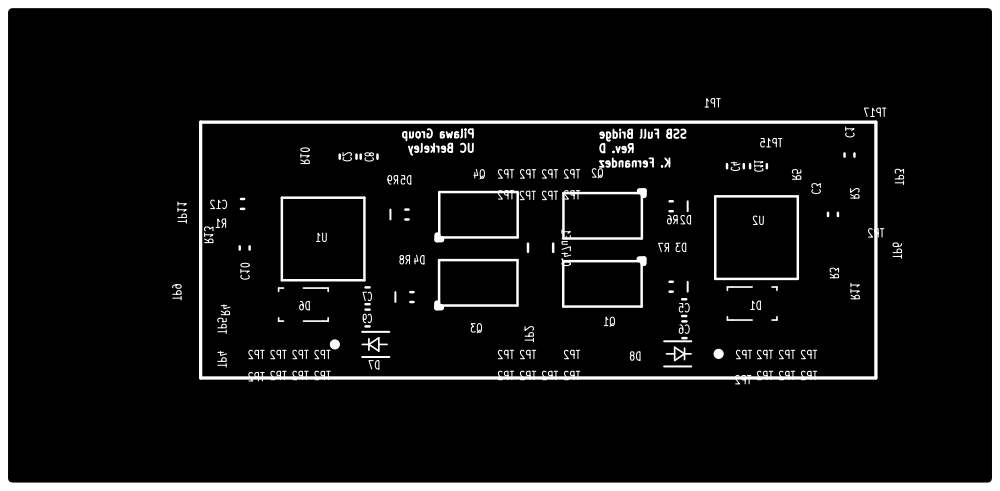
[picture p357: page 1]

Pilawa Group UC Berkeley SSB Full Bridge Rev. D
