kefernandez/SSB_ChargeInjection/Buffer/BufferRevDGerbers2021/Buffer - Rev D-In1_Cu.pdf

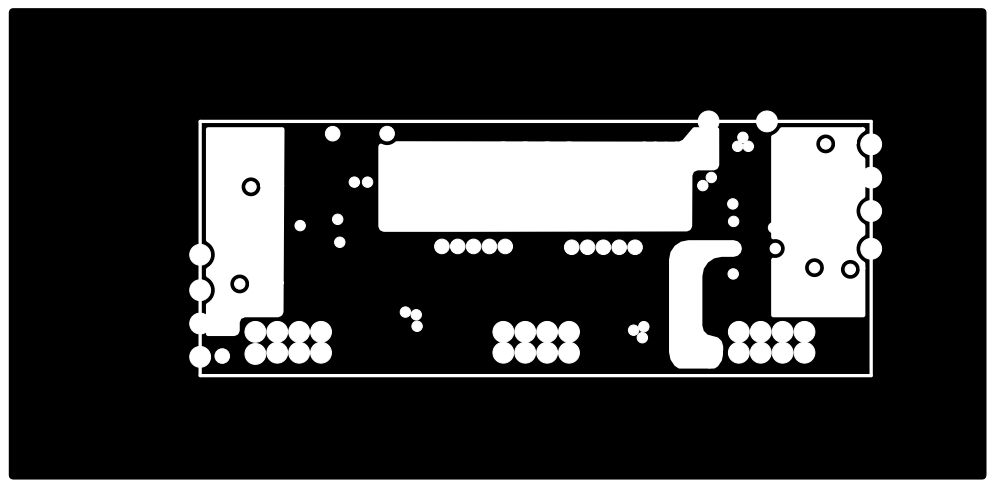
[picture p358: page 1]
