kefernandez/SSB_ChargeInjection/Buffer/BufferRevDGerbers2021/Buffer - Rev D-In2_Cu.pdf

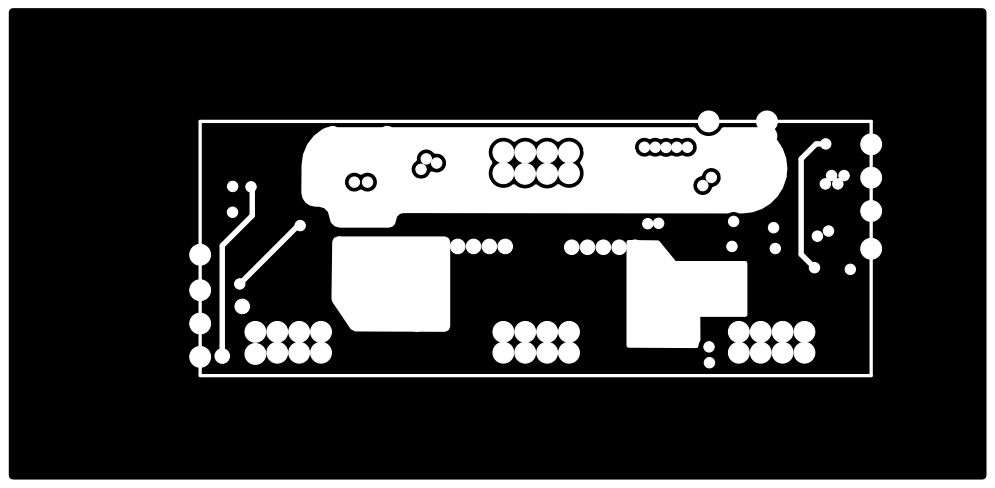
[picture p359: page 1]
