kefernandez/SSB_ChargeInjection/Graphics/Charge Injection/InkScape/circuit with waveform/SSB_chargeinjectionoperation_zoomedin.pdf

R

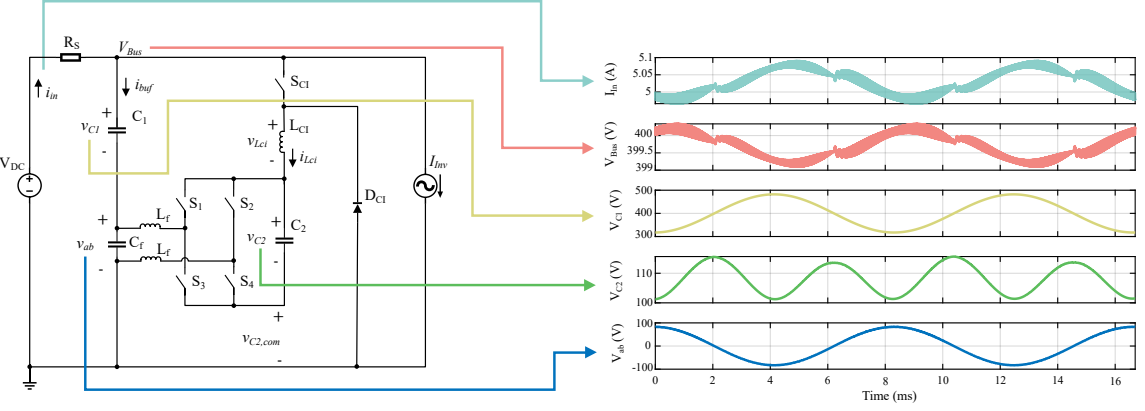
[picture p360: page 1]
Time (ms); VDC; SCI; DCI; IInv; LCI; vab; VBusibuf; iin; iLci; +- vLci; vC2,com

In (A) VBus (V) VC1 (V) VC2 (V) Vab (V)
