kefernandez/SSB_ChargeInjection/Graphics/Charge Injection/InkScape/circuit with waveform/SSB_waveforms.pdf

4055

# IIn (A) VBus (V) VC1 (V) VC2 (V) Vab (V)

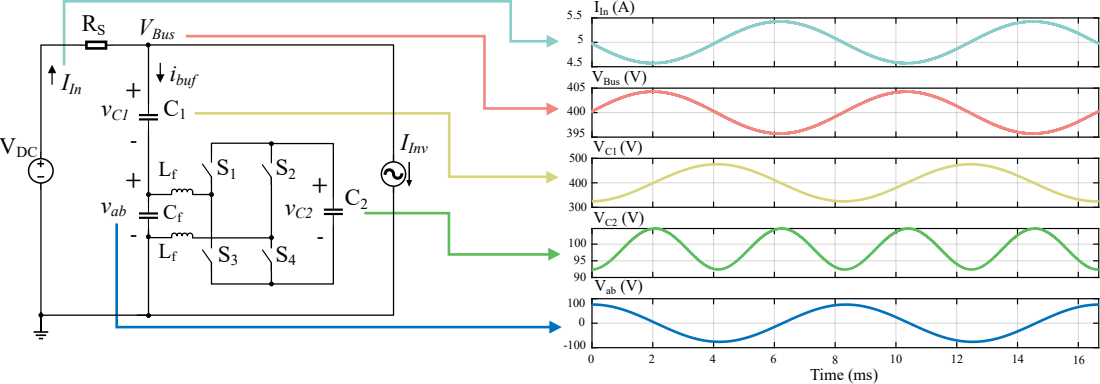
[picture p361: page 1]
Time (ms); VDC; IInv; +- vab; VBusibuf; IIn
