kefernandez/SSB_ChargeInjection/Graphics/Charge Injection/InkScape/circuit with waveform/SSB_waveforms_1500W.pdf

4024

# Iin (A) Vbus (V) VC1 (V) VC2 (V) Vab (V)

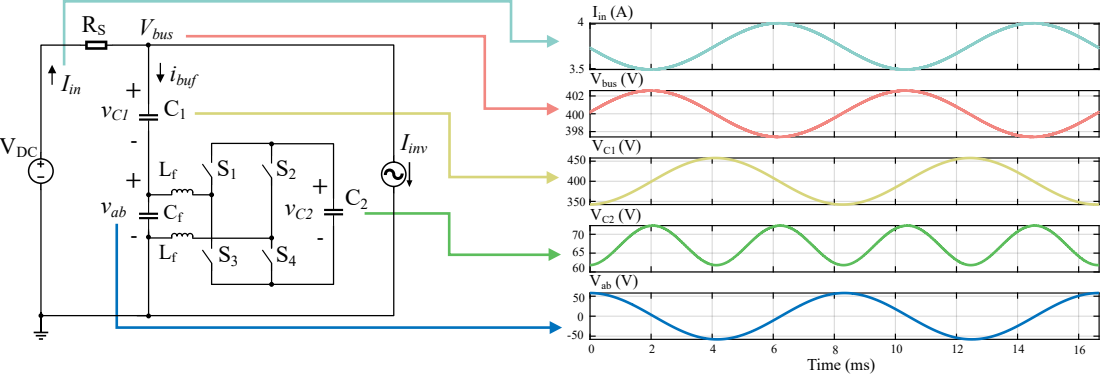
[picture p362: page 1]
Time (ms); VDC; Iinv; +- vab; Vbusibuf; Iin
