kefernandez/SSB_ChargeInjection/Simulation/Simulations_fromHardDrive/FCML/Buck_EMI/Boost_EMI.asc

C1: cap; 8µ
C2: cap; 250n
C3: cap; 8µ
C4: cap; 250n
C5: cap; {Cds}
C6: cap; {Cgs}
C7: cap; {Cin}
C8: cap; {Cgs}
C9: cap; {Cds}
C14: cap; {Cout}
L1: ind; 50µ
L2: ind; 50µ
L3: ind; {5*Lo}
R1: res; 0
R2: res; 5
R3: res; 50
R4: res; 5
R5: res; 50
R8: res; .020
R12: res; 0
R13: res; 10
R14: res; 1G
V1: voltage; {Vin}
V2: voltage; PULSE(0 5 0 {2n} {2n} {D*T} {T})
V3: voltage; PULSE(0 5 {D*T} {2n} {2n} {(1-D)*T-2*Td} {T})
X2: IdealSW
X3: IdealSW
Named nets: COM, Vx, Vy, 0, PWML, PWMH, Vout
.tran 0 10m 8m 10n startup
.param fs=150k T=1/fs D=0.4 Td=20n
.param Lo=22u Cout=2u Rdson=10m Cgs=1.2n Vin=240 Cin=1u Cds=500p
