kefernandez/SSB_ChargeInjection/Simulation/Simulations_fromHardDrive/FCML/Buck_EMI/Buck_EMI.asc

C1: cap; 8µ
C2: cap; 250n
C3: cap; 8µ
C4: cap; 250n
C5: cap; 30p
C6: cap; 10p
C7: cap; 220µ
C8: cap; 500p
C9: cap; 150p
C10: cap; 100p
C11: cap; 110p
C12: cap; 35p
C13: cap; 15p
C14: cap; 330µ
C15: cap; 10p
C16: cap; 70p
L1: ind; 50µ
L2: ind; 50µ
L3: ind; 320n
L4: ind; 320n
L5: ind; 320n
L6: ind; 320n
L7: ind; 47n
L8: ind; 500n
L9: ind; 8n
L10: ind; 1m
L11: ind; 20.9n
R1: res; .2
R2: res; 5
R3: res; 50
R4: res; 5
R5: res; 50
R6: res; .023
R7: res; .023
R8: res; .055
R9: res; .023
R10: res; 0.2
R11: res; 0.02
R12: res; 0.068
R13: res; 15
R14: res; 1G
V1: voltage; 30
V2: voltage; PULSE(0 5 0 0 0 {D*T} {T})
X1: IdealDiode
X2: IdealSW
Named nets: COM, Vx, Vy, 0, Vsw
.tran 0 10m 9m 10n startup
.param fs=50k T=1/fs D=0.4 Td=20n
.param Lo=10u Cout=2u Rdson=10m Cf=1u
