kefernandez/SSB_ChargeInjection/Simulation/Simulations_fromHardDrive/FCML/Buck_EMI/IdealDiode.asc

D1: diode; IdealD
Named nets: -, +
.model IdealD D(Ron=0.1m Roff=1Meg Vfwd=0)
