kefernandez/SSB_ChargeInjection/Simulation/Simulations_fromHardDrive/FCML/Buck_EMI/IdealSW.asc

D1: diode; IdealD
S1: sw; IdealSW
Named nets: 0, G, D, S
.model IdealSW SW(Ron={Rdson} Roff=1Meg Vt=0.5 Vh=-.5)
.model IdealD D(Ron=10m Roff=1Meg Vfwd=0)
