kefernandez/SSB_ChargeInjection/Simulation/Simulations_fromHardDrive/FCML/FCML_EMI/FCML_5Level_GaNSys_D045_2A.asc

C1: cap; {Cout}; Rser=1m
C2: cap; {Cf}; Rser=4.3m Lser=.65n
C3: cap; {Cf}; Rser=4.3m Lser=.65n
C4: cap; {Cf}; Rser=4.3m Lser=.65n
C5: cap; {Cf}; Rser=4.3m Lser=.65n
C6: cap; 8µ
C7: cap; 250n
C8: cap; 8µ
C9: cap; 250n
I1: current; {Iout}
L1: ind; {Lo}; Rser=9.33m
L2: ind; 50µ
L3: ind; 50µ
R1: res; 62
R2: res; 62
R3: res; 62
R4: res; 62
R5: res; 62
R6: res; 62
R7: res; 62
R8: res; 62
R9: res; 62
R10: res; 62
R11: res; 5
R12: res; 50
R13: res; 5
R14: res; 50
R15: res; 1G
V1: voltage; {Vin}
V2: voltage; PULSE(0 5 0 1n 1n {D*T} {T})
V3: voltage; PULSE(0 5 {D*T+Td} 1n 1n {T-D*T-2*Td} {T})
V4: voltage; PULSE(0 5 {Tps} 1n 1n {D*T} {T})
V5: voltage; PULSE(0 5 {Tps+D*T+Td} 1n 1n {T-D*T-2*Td} {T})
V6: voltage; PULSE(0 5 {Tps*2} 1n 1n {D*T} {T})
V7: voltage; PULSE(0 5 {Tps*2+D*T+Td} 1n 1n {T-D*T-2*Td} {T})
V8: voltage; PULSE(0 5 {Tps*3} 1n 1n {D*T} {T})
V9: voltage; PULSE(0 5 {Tps*3+D*T+Td} 1n 1n {T-D*T-2*Td} {T})
V10: voltage; PULSE(0 5 {Tps*4} 1n 1n {D*T} {T})
V11: voltage; PULSE(0 5 {Tps*4+D*T+Td} 1n 1n {T-D*T-2*Td} {T})
X1: IdealDiode
X2: IdealDiode
X3: IdealDiode
X4: IdealDiode
X5: IdealDiode
X6: IdealDiode
X7: IdealDiode
X8: IdealDiode
X9: IdealDiode
X10: IdealDiode
X11: IdealSW
X12: IdealSW
X13: IdealSW
X14: IdealSW
X15: IdealSW
X16: IdealSW
X17: IdealSW
X18: IdealSW
X19: IdealSW
X20: IdealSW
Named nets: 0, PWM1, PWM1n, PWM2, PWM2n, in, sw, out, PWM3, PWM3n, PWM4, PWM4n, PWM5, PWM5n, s1, s2, s3, s4, s5, s6, s7, s8, COM, Vx, Vy
.param Vin=400 Iout=2 Lo=10u Cout=2u Rdson=10m Cf=1u
.param fs=150k T=1/fs D=0.45 Td=20n Tps=1/5*T
;.ic V(s1,s8)={Vin*4/5} V(s2,s7)={Vin*3/5} V(s3,s6)={Vin*2/5} V(s4,s5)={Vin*1/5} V(out)={Vin*D}
.tran 0 10m {10m-100/fs} 4n startup
