kefernandez/SSB_ChargeInjection/Simulation/Simulations_fromHardDrive/FCML/FCML_EMI/FCMLEMI_Ting.asc

B1: bv; V={(V(Vx,com)+V(Vy,com))*1e6}
B2: bv; V={(V(Vx,com)-V(Vy,com))*0.5e6}
B3: bv; V={(V(Vx,com)+V(Vy,com))}
B4: bv; V={(V(Vx,com)-V(Vy,com))*0.5}
C1: cap; {Cout}; Rser=1m
C2: cap; {Cf}; Rser=4.3m
C3: cap; {Cf}; Rser=4.3m
C4: cap; {Cf}; Rser=4.3m
C5: cap; {Cf}; Rser=4.3m
C6: cap; 8µ
C7: cap; 250n
C8: cap; 8µ
C9: cap; 250n
C11: cap; {Cin}
I1: current; {Iout}
L1: ind; {Lo}; Rser=9.33m
L2: ind; 50µ
L3: ind; 50µ
R11: res; 5
R12: res; 50
R13: res; 5
R14: res; 50
R15: res; 1G
V1: voltage; {Vin}
V2: voltage; PULSE(0 5 0 1n 1n {D*T} {T})
V3: voltage; PULSE(0 5 {D*T+Td} 1n 1n {T-D*T-2*Td} {T})
V4: voltage; PULSE(0 5 {Tps} 1n 1n {D*T} {T})
V5: voltage; PULSE(0 5 {Tps+D*T+Td} 1n 1n {T-D*T-2*Td} {T})
V6: voltage; PULSE(0 5 {Tps*2} 1n 1n {D*T} {T})
V7: voltage; PULSE(0 5 {Tps*2+D*T+Td} 1n 1n {T-D*T-2*Td} {T})
V8: voltage; PULSE(0 5 {Tps*3} 1n 1n {D*T} {T})
V9: voltage; PULSE(0 5 {Tps*3+D*T+Td} 1n 1n {T-D*T-2*Td} {T})
V10: voltage; PULSE(0 5 {Tps*4} 1n 1n {D*T} {T})
V11: voltage; PULSE(0 5 {Tps*4+D*T+Td} 1n 1n {T-D*T-2*Td} {T})
X11: IdealSW; Rdson = {Rdson}
X12: IdealSW; Rdson = {Rdson}
X13: IdealSW; Rdson = {Rdson}
X14: IdealSW; Rdson = {Rdson}
X15: IdealSW; Rdson = {Rdson}
X16: IdealSW; Rdson = {Rdson}
X17: IdealSW; Rdson = {Rdson}
X18: IdealSW; Rdson = {Rdson}
X19: IdealSW; Rdson = {Rdson}
X20: IdealSW; Rdson = {Rdson}
Named nets: 0, in, sw, out, PWM2n, PWM3, PWM3n, PWM1, PWM1n, PWM4n, PWM2, PWM5, PWM5n, s1, s2, s3, s4, s5, s6, s7, s8, COM, Vx, Vy, PWM4, VcmuV, VdmuV, Vcm, Vdm
.param Vin=400 Iout=2 Lo=10u Cout=2u Rdson=10m Cf=1u Cin=1u
.param fs=150k T=1/fs D=0.25 Td=20n Tps=1/5*T
;.ic V(s1,s8)={Vin*4/5} V(s2,s7)={Vin*3/5} V(s3,s6)={Vin*2/5} V(s4,s5)={Vin*1/5} V(out)={Vin*D}
.tran 0 10m {10m-5/fs} {0.01/fs} startup
