kefernandez/SSB_ChargeInjection/Simulation/Simulations_fromHardDrive/FCML/FCML_lossSim/FCML_lossSim/FCML_5Level_GaNSys_D045_8A_Rgate30.asc

C1: cap; {Cout}; Rser=1m
C2: cap; {Cf}; Rser=2m
C3: cap; {Cf}; Rser=2m
C4: cap; {Cf}; Rser=2m
C5: cap; {Cf}; Rser=2m
I1: current; {Iout}
L1: ind; {Lo}; Rser=9.33m
R1: res; {Rgate}
R2: res; {Rgate}
R3: res; {Rgate}
R4: res; {Rgate}
R5: res; {Rgate}
R6: res; {Rgate}
R7: res; {Rgate}
R8: res; {Rgate}
R9: res; {Rgate}
R10: res; {Rgate}
U1: GaN_LTspice_GS61008T_L1V4P1
U2: GaN_LTspice_GS61008T_L1V4P1
U3: GaN_LTspice_GS61008T_L1V4P1
U4: GaN_LTspice_GS61008T_L1V4P1
U5: GaN_LTspice_GS61008T_L1V4P1
U6: GaN_LTspice_GS61008T_L1V4P1
U7: GaN_LTspice_GS61008T_L1V4P1
U8: GaN_LTspice_GS61008T_L1V4P1
U9: GaN_LTspice_GS61008T_L1V4P1
U10: GaN_LTspice_GS61008T_L1V4P1
V1: voltage; {Vin}
V2: voltage; PULSE(0 5 0 1n 1n {D*T} {T})
V3: voltage; PULSE(0 5 {D*T+Td} 1n 1n {T-D*T-2*Td} {T})
V4: voltage; PULSE(0 5 {Tps} 1n 1n {D*T} {T})
V5: voltage; PULSE(0 5 {Tps+D*T+Td} 1n 1n {T-D*T-2*Td} {T})
V6: voltage; PULSE(0 5 {Tps*2} 1n 1n {D*T} {T})
V7: voltage; PULSE(0 5 {Tps*2+D*T+Td} 1n 1n {T-D*T-2*Td} {T})
V8: voltage; PULSE(0 5 {Tps*3} 1n 1n {D*T} {T})
V9: voltage; PULSE(0 5 {Tps*3+D*T+Td} 1n 1n {T-D*T-2*Td} {T})
V10: voltage; PULSE(0 5 {Tps*4} 1n 1n {D*T} {T})
V11: voltage; PULSE(0 5 {Tps*4+D*T+Td} 1n 1n {T-D*T-2*Td} {T})
X1: IdealDiode
X2: IdealDiode
X3: IdealDiode
X4: IdealDiode
X5: IdealDiode
X6: IdealDiode
X7: IdealDiode
X8: IdealDiode
X9: IdealDiode
X10: IdealDiode
Named nets: 0, PWM1, PWM1n, PWM2, PWM2n, in, sw, out, PWM3, PWM3n, PWM4, PWM4n, PWM5, PWM5n, s1, s2, s3, s4, s5, s6, s7, s8
.param Vin=400 Iout=8 Lo=10u Cout=2u Rdson=10m Cf=1u Rgate=30
.param fs=150k T=1/fs D=0.45 Td=20n Tps=1/5*T
;.ic V(s1,s8)={Vin*4/5} V(s2,s7)={Vin*3/5} V(s3,s6)={Vin*2/5} V(s4,s5)={Vin*1/5} V(out)={Vin*D}
.tran 0 10000u {10000u-100/fs} 4n startup
.meas ILrms RMS I(L1)
.meas Vout AVG V(out)
.meas PLwinding PARAM ILrms*ILrms*0.0093
.meas Ph1 AVG V(in,s1)*Ix(U9:D)
.meas Ph2 AVG V(s1,s2)*Ix(U7:D)
.meas Ph3 AVG V(s2,s3)*Ix(U5:D)
.meas Ph4 AVG V(s3,s4)*Ix(U3:D)
.meas Ph5 AVG V(s4,sw)*Ix(U1:D)
.meas Plow1 AVG V(s8)*Ix(U10:D)
.meas Plow2 AVG V(s7,s8)*Ix(U8:D)
.meas Plow3 AVG V(s6,s7)*Ix(U6:D)
.meas Plow4 AVG V(s5,s6)*Ix(U4:D)
.meas Plow5 AVG V(sw,s5)*Ix(U2:D)
