kefernandez/SSB_ChargeInjection/Simulation/Simulations_fromHardDrive/FCML/FCML_lossSim/FCML_lossSim/FCML_6Level_idealSW.asc

C1: cap; {Cout}; Rser=1m
C2: cap; {Cf}; Rser=1m
C3: cap; {Cf}; Rser=1m
C4: cap; {Cf}; Rser=1m
C5: cap; {Cf}; Rser=1m
I1: current; {Iout}
L1: ind; {Lo}; Rser=20m
V1: voltage; {Vin}
V2: voltage; PULSE(0 5 0 1n 1n {D*T} {T})
V3: voltage; PULSE(0 5 {D*T+Td} 1n 1n {T-D*T-2*Td} {T})
V4: voltage; PULSE(0 5 {Tps} 1n 1n {D*T} {T})
V5: voltage; PULSE(0 5 {Tps+D*T+Td} 1n 1n {T-D*T-2*Td} {T})
V6: voltage; PULSE(0 5 {Tps*2} 1n 1n {D*T} {T})
V7: voltage; PULSE(0 5 {Tps*2+D*T+Td} 1n 1n {T-D*T-2*Td} {T})
V8: voltage; PULSE(0 5 {Tps*3} 1n 1n {D*T} {T})
V9: voltage; PULSE(0 5 {Tps*3+D*T+Td} 1n 1n {T-D*T-2*Td} {T})
V10: voltage; PULSE(0 5 {Tps*4} 1n 1n {D*T} {T})
V11: voltage; PULSE(0 5 {Tps*4+D*T+Td} 1n 1n {T-D*T-2*Td} {T})
X1: IdealSW; Rdson = {Rdson}
X2: IdealSW; Rdson = {Rdson}
X3: IdealSW; Rdson = {Rdson}
X4: IdealSW; Rdson = {Rdson}
X5: IdealSW; Rdson = {Rdson}
X6: IdealSW; Rdson = {Rdson}
X7: IdealSW; Rdson = {Rdson}
X8: IdealSW; Rdson = {Rdson}
X9: IdealSW; Rdson = {Rdson}
X10: IdealSW; Rdson = {Rdson}
Named nets: 0, PWM1, PWM1n, PWM2, PWM2n, in, sw, out, PWM3, PWM3n, PWM4, PWM4n, PWM5, PWM5n
.param Vin=400 Iout=0.8 Lo=10u Cout=100u Rdson=10m Cf=10u
.param fs=150k T=1/fs D=0.15 Td=30n Tps=1/5*T
.tran 0 {2000/fs} {1990/fs} {0.01/fs}
