kefernandez/SSB_ChargeInjection/Simulation/Simulations_fromHardDrive/FCML/FCML_lossSim/FCML_lossSim/Unfolder.asc

C1: cap; 80µ; Rser=1m
R1: res; 4.7
R2: res; 500
R3: res; 4.7
R4: res; 4.7
R5: res; 4.7
U1: GaN_LTspice_GS66516T_L1V4P1
U2: GaN_LTspice_GS66516T_L1V4P1
U3: GaN_LTspice_GS66516T_L1V4P1
U4: GaN_LTspice_GS66516T_L1V4P1
V1: voltage; 50; Rser=0
V2: voltage; PULSE(0 5 0 1n 1n {D*T} {T})
V3: voltage; PULSE(0 5 {D*T + Td} 1n 1n {D*T-2*Td} {T})
V4: voltage; PULSE(0 5 {D*T + Td} 1n 1n {D*T - 2*Td} {T})
V5: voltage; PULSE(0 5 0 1n 1n {D*T} {T})
X1: IdealDiode
X2: IdealDiode
X3: IdealDiode
X4: IdealDiode
Named nets: 0, PWM1, s1, PWM4, PWM2, PWM3, s2, Vdcp
.param Vin=400 Iout=2 Lo=10u Cout=2u Rdson=10m Cf=1u
.param fs=60000 T=1/fs D=0.5 Td=38n
.tran 0 0.25m 0 4n
