kefernandez/SSB_ChargeInjection/(list of files, drawings)

Other design files:
kicad-library/pcb/user_kf/GANSYS_ALTIUM_FOOTPRINT_Updated_20201013.PcbLib
kicad-library/pcb/user_kf/GANSYS_ALTIUM_SYMBOL_Updated_20201013.SchLib
