kefernandez/SSB_ChargeInjection/Schematic and Layout/UnfolderBuffer.kicad_pcb

## KiCad design Schematic and Layout/UnfolderBuffer.kicad_pcb (2022-12-01)

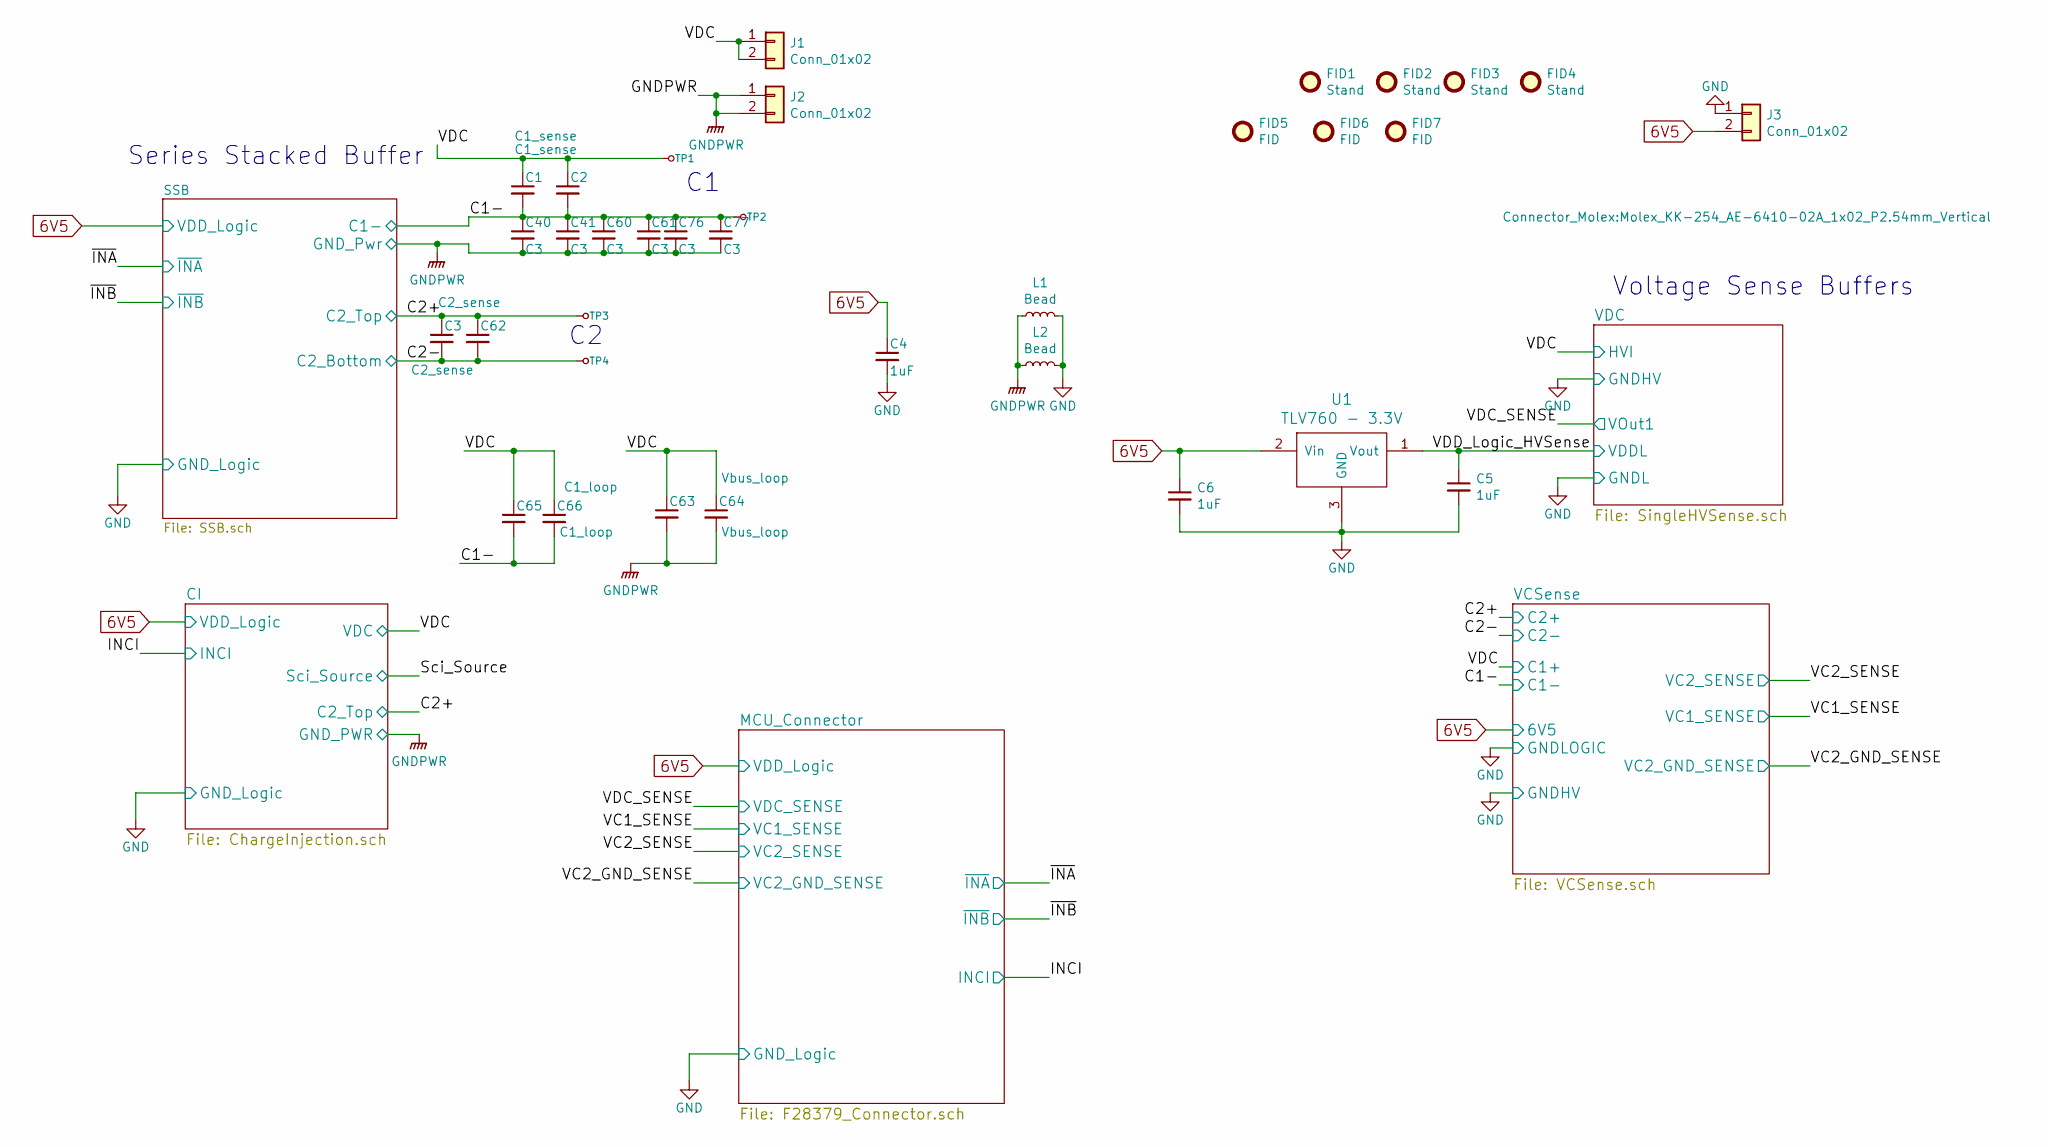
[picture p363: schematic UnfolderBuffer.sch]

Parts:
C1, C2: C1_sense; C_1210
C3, C62: C2_sense; C_1210
C4: 1uF; C_1206
C5, C6: 1uF; C_0603
C40, C41, C60, C61, C76, C77: C3; C_1206
C63, C64: Vbus_loop; C_1210
C65, C66: C1_loop; C_1210
FID1, FID2, FID3, FID4: Stand; MountingHole_3.2mm_M3
FID5, FID6, FID7: FID; Fiducial_1mm_Dia_2.54mm_Outer_CopperTop
J1, J2: Conn_01x02; MTA156_2pin
J3: Conn_01x02; Molex_KK-254_AE-6410-02A_1x02_P2.54mm_Vertical
L1, L2: Bead; R_0603
TP1, TP2, TP3, TP4: TP; Banana_Jack_1Pin
U1: TLV760 - 3.3V; SOT-23

Connections:
6V5: C4.1, C6.1, J3.2, U1.2 (Vin); also elsewhere on the board
/C1-: C1.2, C2.2, C40.1, C41.1, C60.1, C61.1, C65.2, C66.2, C76.1, C77.1, TP2.1; also elsewhere on the board
/C2+: C3.1, C62.1, TP3.1; also elsewhere on the board
/C2-: C3.2, C62.2, TP4.1; also elsewhere on the board
/VDC: C1.1, C2.1, C63.1, C64.1, C65.1, C66.1, J1.1, J1.2, TP1.1; also elsewhere on the board
/VDD_Logic_HVSense: C5.1, U1.1 (Vout); also elsewhere on the board
GND: C4.2, C5.2, C6.2, J3.1, L1.2, L2.2, U1.3 (GND); also elsewhere on the board
GNDPWR: C40.2, C41.2, C60.2, C61.2, C63.2, C64.2, C76.2, C77.2, J2.1, J2.2, L1.1, L2.1; also elsewhere on the board

Notes on the sheet:
Series Stacked Buffer
Voltage Sense Buffers

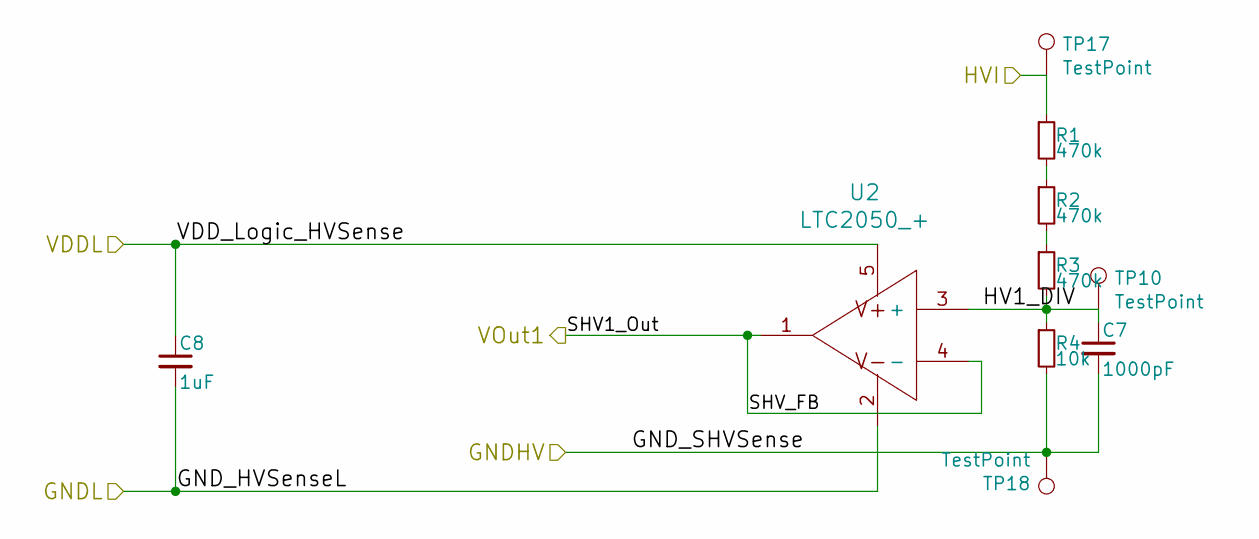
[picture p364: schematic SingleHVSense.sch]

Parts:
C7: 1000pF; C_0603
C8: 1uF; C_0603
R1, R2, R3: 470k; R_1206
R4: 10k; R_0603
TP10, TP17, TP18: TestPoint; 0603 TP
U2: LTC2050_+; SOT-23-5

Connections:
/VDC: R1.1, TP17.1; also elsewhere on the board
/VDC/HV1_DIV: C7.1, R3.2, R4.1, TP10.1, U2.3 (+)
/VDC_SENSE: U2.1, U2.4 (-); also elsewhere on the board
/VDD_Logic_HVSense: C8.1, U2.5; also elsewhere on the board
GND: C7.2, C8.2, R4.2, TP18.1, U2.2; also elsewhere on the board
unnamed: R1.2, R2.1
unnamed: R2.2, R3.1

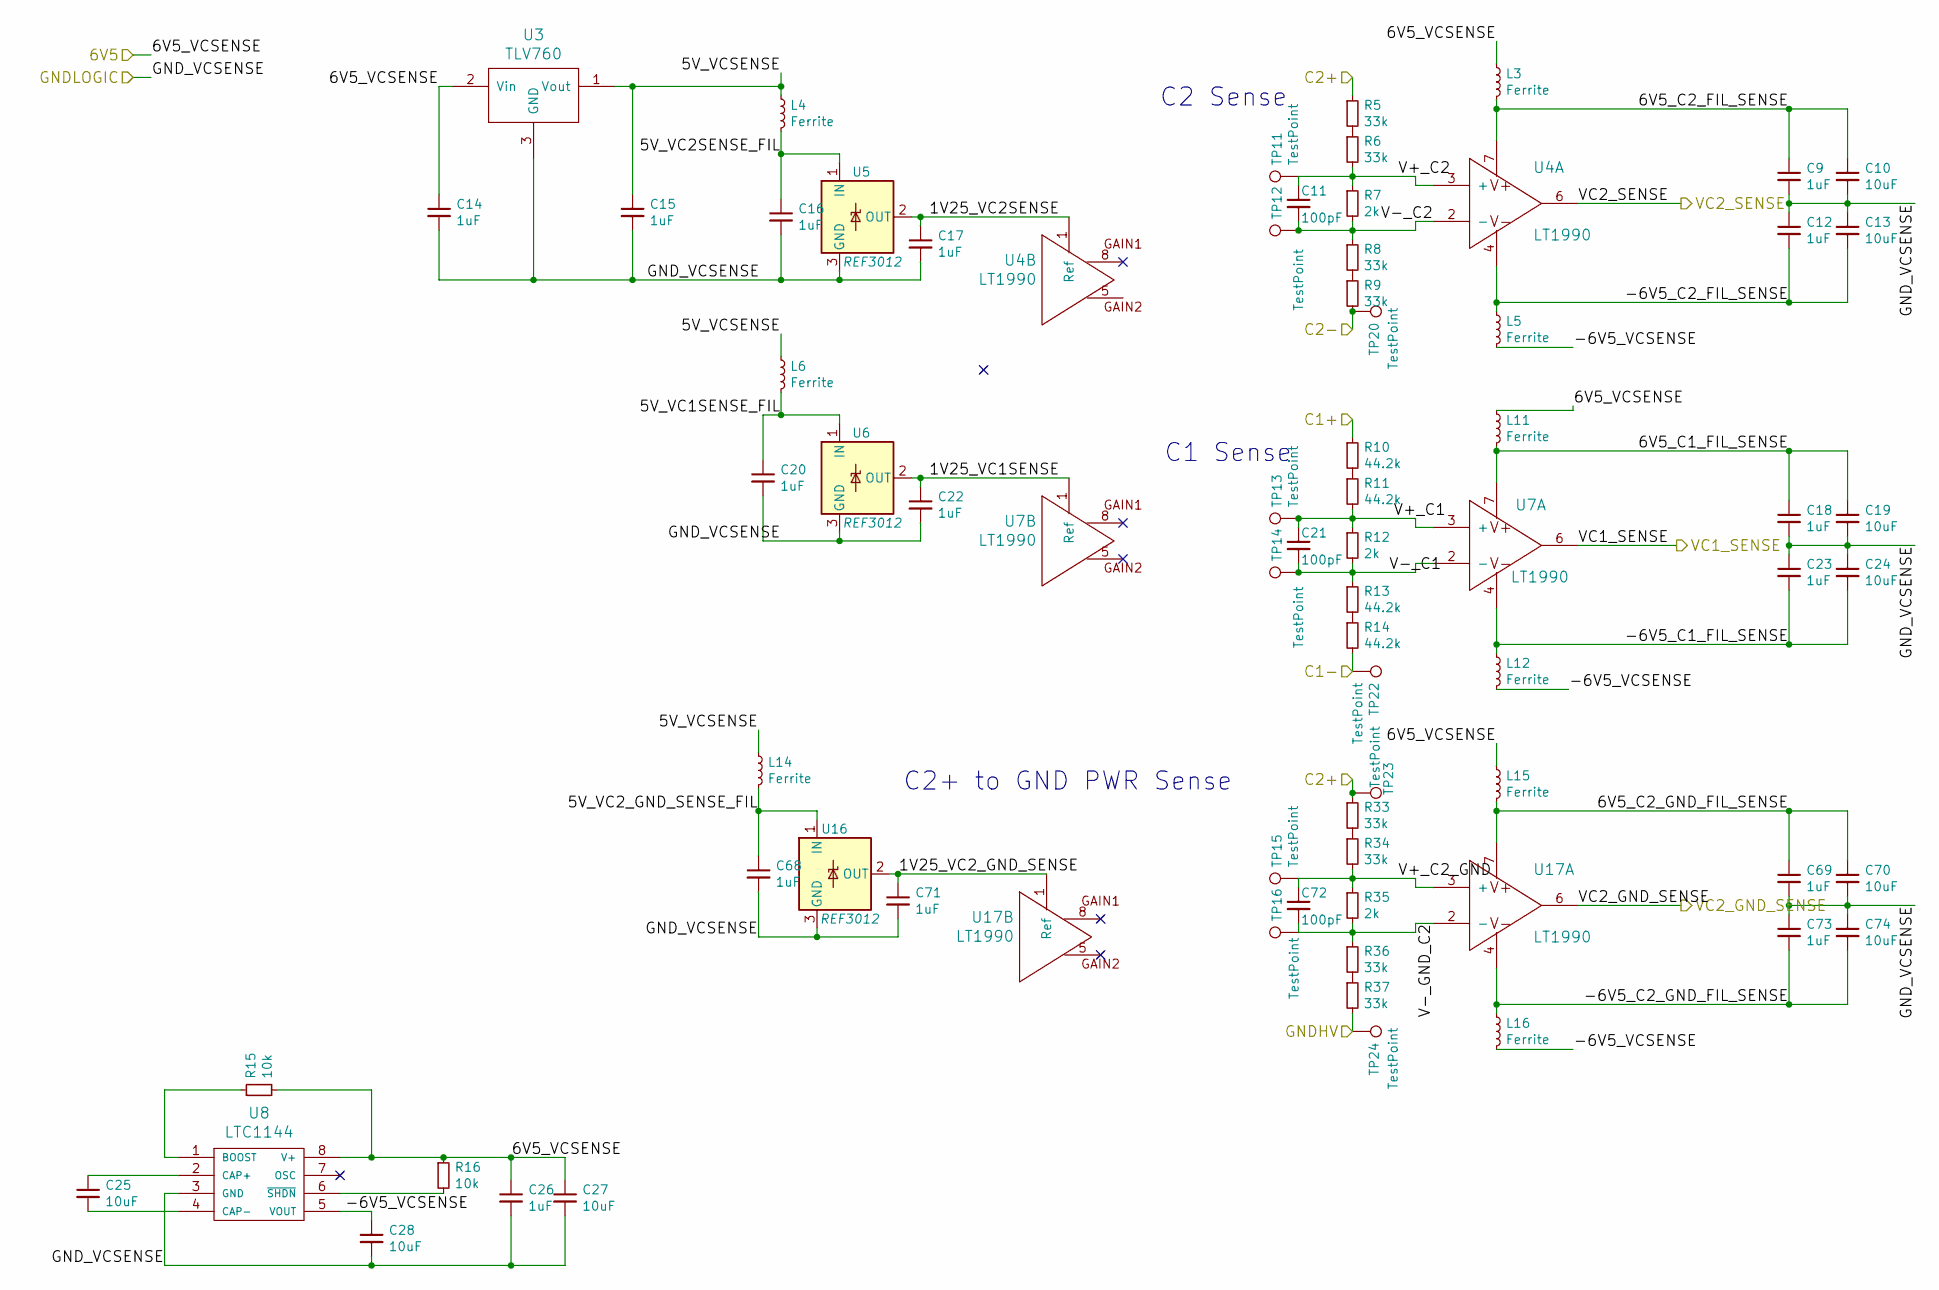
[picture p365: schematic VCSense.sch]

Parts:
C9, C12, C14, C15, C16, C17, C18, C20, C22, C23, C26, C68, C69, C71, C73: 1uF; C_0603
C10, C13, C19, C24, C70, C74: 10uF; C_0805
C11, C21, C72: 100pF; C_0603
C25, C28: 10uF; C_0603
C27: 10uF; C_1206
L3, L4, L5, L6, L11, L12, L14, L15, L16: Ferrite; C_0603
R5, R6, R8, R9, R33, R34, R36, R37: 33k; R_0603
R7, R12, R35: 2k; R_0603
R10, R11: 44.2k; R_1206
R13, R14: 44.2k; R_0805
R15, R16: 10k; R_0603
TP11, TP12, TP13, TP14, TP15, TP16, TP20, TP22, TP23, TP24: TestPoint; 0603 TP
U3: TLV760; SOT-23
U4, U7, U17: LT1990; SOIC-8
U5, U6, U16: REF3012; SOT-23
U8: LTC1144; SOIC-8

Connections:
6V5: C14.1, C26.1, C27.1, L3.1, L11.1, L15.1, R15.2, R16.1, U3.2 (Vin), U8.8 (V+); also elsewhere on the board
/C1-: R14.2, TP22.1; also elsewhere on the board
/C2+: R5.1, R33.1, TP23.1; also elsewhere on the board
/C2-: R9.2, TP20.1; also elsewhere on the board
/VC1_SENSE: U7.6; also elsewhere on the board
/VC2_GND_SENSE: U17.6; also elsewhere on the board
/VC2_SENSE: U4.6; also elsewhere on the board
/VCSense/1V25_VC1SENSE: C22.1, U6.2 (OUT), U7.1 (Ref)
/VCSense/1V25_VC2SENSE: C17.1, U4.1 (Ref), U5.2 (OUT)
/VCSense/1V25_VC2_GND_SENSE: C71.1, U16.2 (OUT), U17.1 (Ref)
/VCSense/5V_VC1SENSE_FIL: C20.1, L6.2, U6.1 (IN)
/VCSense/5V_VC2SENSE_FIL: C16.1, L4.2, U5.1 (IN)
/VCSense/5V_VC2_GND_SENSE_FIL: C68.1, L14.2, U16.1 (IN)
/VCSense/5V_VCSENSE: C15.1, L4.1, L6.1, L14.1, U3.1 (Vout)
/VCSense/6V5_C1_FIL_SENSE: C18.1, C19.1, L11.2, U7.7
/VCSense/6V5_C2_FIL_SENSE: C9.1, C10.1, L3.2, U4.7
/VCSense/6V5_C2_GND_FIL_SENSE: C69.1, C70.1, L15.2, U17.7
/VCSense/-6V5_C1_FIL_SENSE: C23.2, C24.2, L12.1, U7.4
/VCSense/-6V5_C2_FIL_SENSE: C12.2, C13.2, L5.1, U4.4
/VCSense/-6V5_C2_GND_FIL_SENSE: C73.2, C74.2, L16.1, U17.4
/VCSense/-6V5_VCSENSE: C28.1, L5.2, L12.2, L16.2, U8.5 (VOUT)
/VCSense/V+_C1: C21.1, R11.2, R12.1, TP13.1, U7.3 (+)
/VCSense/V+_C2: C11.1, R6.2, R7.1, TP11.1, U4.3 (+)
/VCSense/V+_C2_GND: C72.1, R34.2, R35.1, TP15.1, U17.3 (+)
/VCSense/V-_C1: C21.2, R12.2, R13.1, TP14.1, U7.2 (-)
/VCSense/V-_C2: C11.2, R7.2, R8.1, TP12.1, U4.2 (-)
/VCSense/V-_GND_C2: C72.2, R35.2, R36.1, TP16.1, U17.2 (-)
/VDC: R10.1; also elsewhere on the board
GND: C9.2, C10.2, C12.1, C13.1, C14.2, C15.2, C16.2, C17.2, C18.2, C19.2, C20.2, C22.2, C23.1, C24.1, C26.2, C27.2, C28.2, C68.2, C69.2, C70.2, C71.2, C73.1, C74.1, R37.2, TP24.1, U3.3 (GND), U5.3 (GND), U6.3 (GND), U8.3 (GND), U16.3 (GND); also elsewhere on the board
unnamed: C25.1, U8.2 (CAP+)
unnamed: C25.2, U8.4 (CAP-)
unnamed: R5.2, R6.1
unnamed: R8.2, R9.1
unnamed: R10.2, R11.1
unnamed: R13.2, R14.1
unnamed: R15.1, U8.1 (BOOST)
unnamed: R16.2, U8.6 (~SHDN)
unnamed: R33.2, R34.1
unnamed: R36.2, R37.1

Notes on the sheet:
C2 Sense
C1 Sense
C2+ to GND PWR Sense

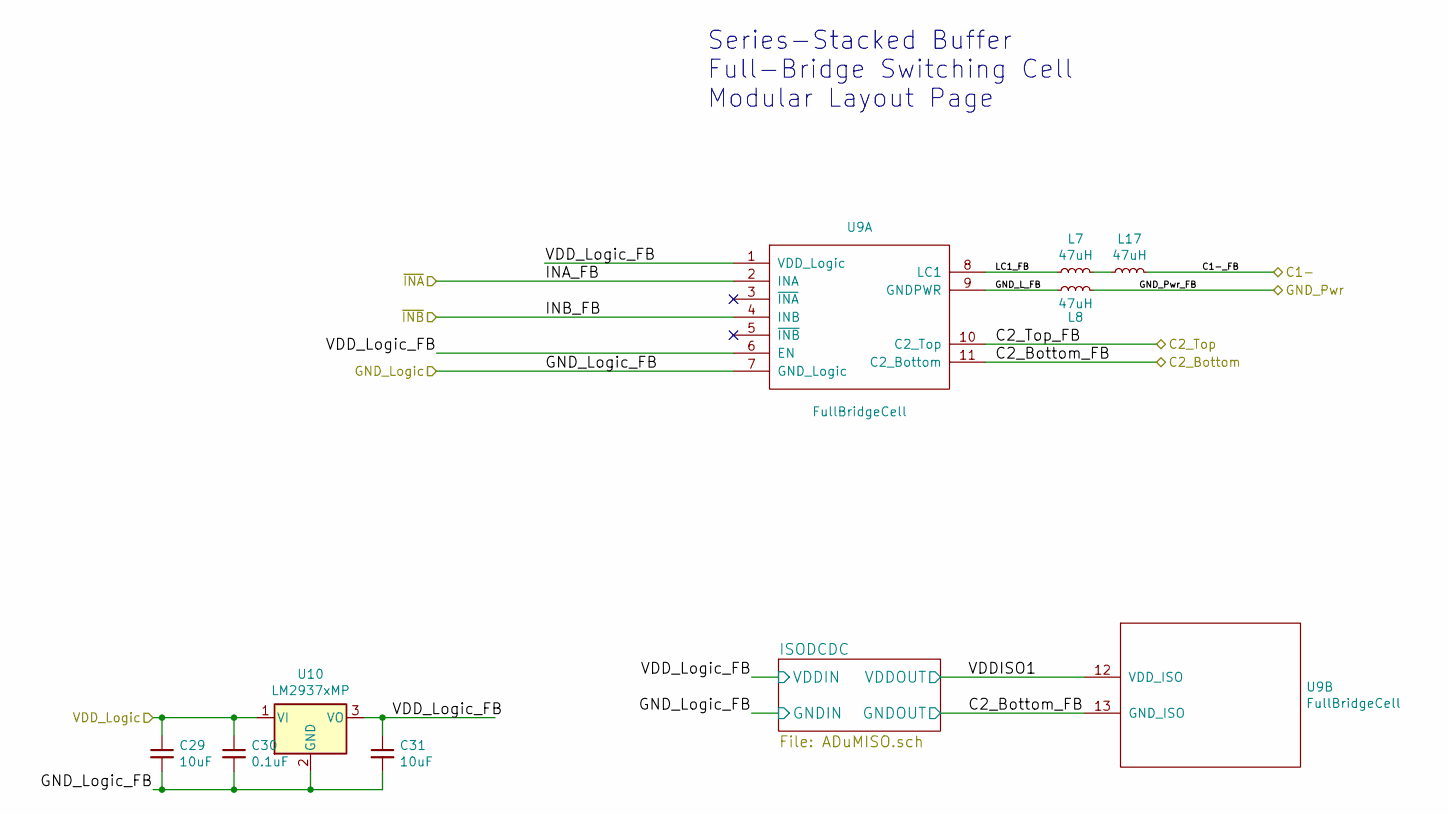
[picture p366: schematic SSB.sch]

Parts:
C29, C31: 10uF; C_1206
C30: 0.1uF; C_1206
L7, L8, L17: 47uH; XAL7070
U9: FullBridgeCell; Buffer Full Bridge
U10: LM2937xMP; SOT223-4

Connections:
6V5: C29.1, C30.1, U10.1 (VI); also elsewhere on the board
/C1-: L17.2; also elsewhere on the board
/C2+: U9.10 (C2_Top); also elsewhere on the board
/C2-: U9.11 (C2_Bottom), U9.13 (GND_ISO); also elsewhere on the board
/SSB/GND_L_FB: L8.1, U9.9 (GNDPWR)
/SSB/LC1_FB: L7.1, U9.8 (LC1)
/SSB/VDDISO1: U9.12 (VDD_ISO); also elsewhere on the board
/SSB/VDD_Logic_FB: C31.1, U9.1 (VDD_Logic), U9.6 (EN), U10.3 (VO); also elsewhere on the board
/~INA: U9.2 (INA); also elsewhere on the board
/~INB: U9.4 (INB); also elsewhere on the board
GND: C29.2, C30.2, C31.2, U9.7 (GND_Logic), U10.2 (GND); also elsewhere on the board
GNDPWR: L8.2; also elsewhere on the board
unnamed: L7.2, L17.1

Notes on the sheet:
Series-Stacked Buffer Full-Bridge Switching Cell Modular Layout Page

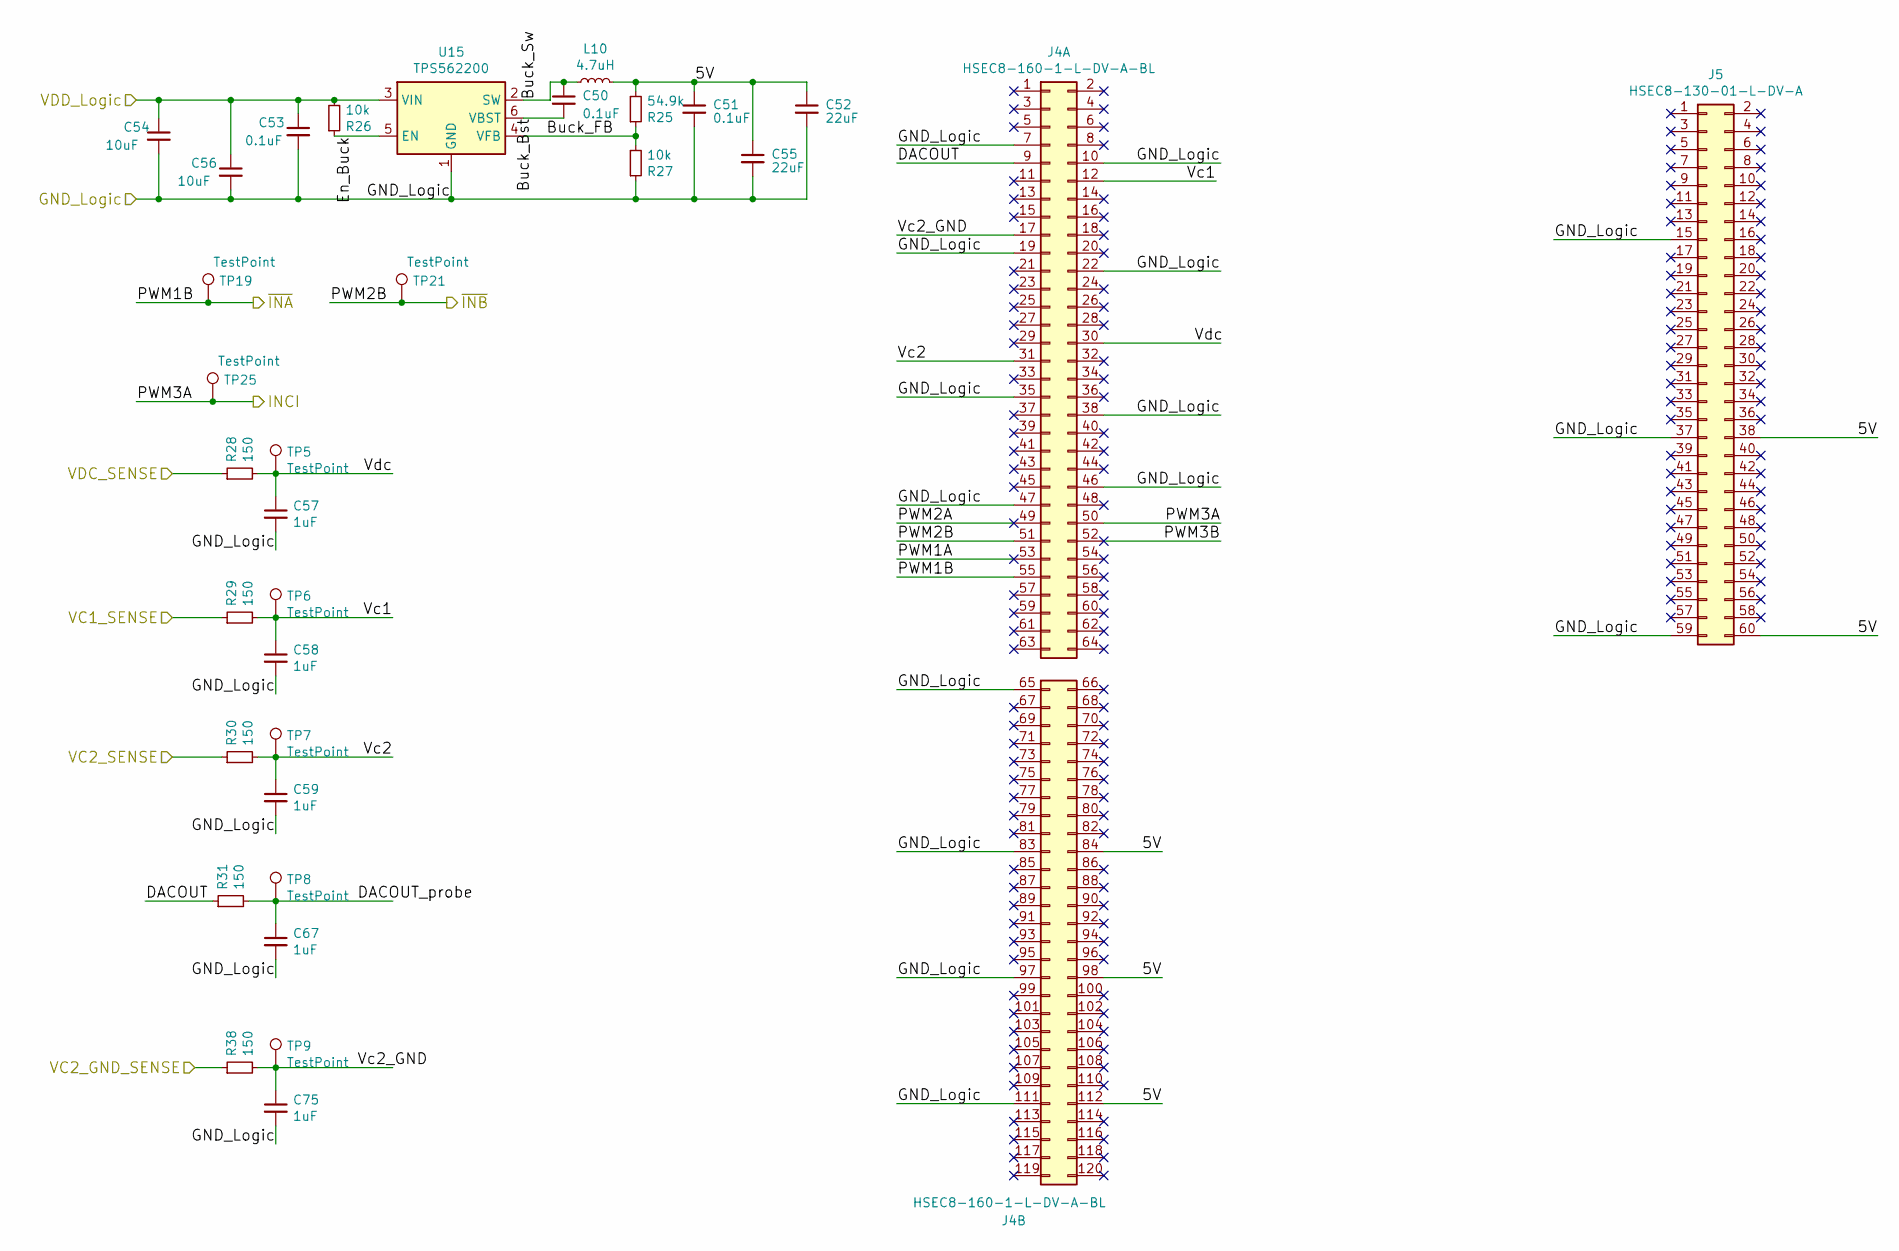
[picture p367: schematic F28379_Connector.sch]

Parts:
C50, C51, C53: 0.1uF; C_0603
C52, C55: 22uF; C_1206
C54, C56: 10uF; C_1206
C57, C58, C59, C67, C75: 1uF; C_0603
J4: HSEC8-160-1-L-DV-A-BL; SAMTEC_HSEC8-160-01-L-DV-A-BL
J5: HSEC8-130-01-L-DV-A; SKT-60_flipped
L10: 4.7uH; XEL4030
R25: 54.9k; R_0402
R26, R27: 10k; R_0402
R28, R29, R30, R31, R38: 150; R_0402
TP5, TP6, TP7, TP8, TP9, TP19, TP21, TP25: TestPoint; 0603 TP
U15: TPS562200; SOT-23-6

Connections:
6V5: C53.1, C54.1, C56.1, R26.2, U15.3 (VIN); also elsewhere on the board
/INCI: J4.50, TP25.1; also elsewhere on the board
/MCU_Connector/5V: C51.1, C52.1, C55.1, J4.84, J4.98, J4.112, J5.38, J5.60, L10.2, R25.2
/MCU_Connector/Buck_Bst: C50.2, U15.6 (VBST)
/MCU_Connector/Buck_FB: R25.1, R27.2, U15.4 (VFB)
/MCU_Connector/Buck_Sw: C50.1, L10.1, U15.2 (SW)
/MCU_Connector/DACOUT: J4.9, R31.1
/MCU_Connector/DACOUT_probe: C67.1, R31.2, TP8.1
/MCU_Connector/En_Buck: R26.1, U15.5 (EN)
/MCU_Connector/PWM1A: J4.53
/MCU_Connector/PWM2A: J4.49
/MCU_Connector/PWM3B: J4.52
/MCU_Connector/Vc1: C58.1, J4.12, R29.2, TP6.1
/MCU_Connector/Vc2: C59.1, J4.31, R30.2, TP7.1
/MCU_Connector/Vc2_GND: C75.1, J4.17, R38.2, TP9.1
/MCU_Connector/Vdc: C57.1, J4.30, R28.2, TP5.1
/VC1_SENSE: R29.1; also elsewhere on the board
/VC2_GND_SENSE: R38.1; also elsewhere on the board
/VC2_SENSE: R30.1; also elsewhere on the board
/VDC_SENSE: R28.1; also elsewhere on the board
/~INA: J4.55, TP19.1; also elsewhere on the board
/~INB: J4.51, TP21.1; also elsewhere on the board
GND: C51.2, C52.2, C53.2, C54.2, C55.2, C56.2, C57.2, C58.2, C59.2, C67.2, C75.2, J4.7, J4.10, J4.19, J4.22, J4.35, J4.38, J4.46, J4.47, J4.65, J4.83, J4.97, J4.111, J5.15, J5.37, J5.59, R27.1, U15.1 (GND); also elsewhere on the board

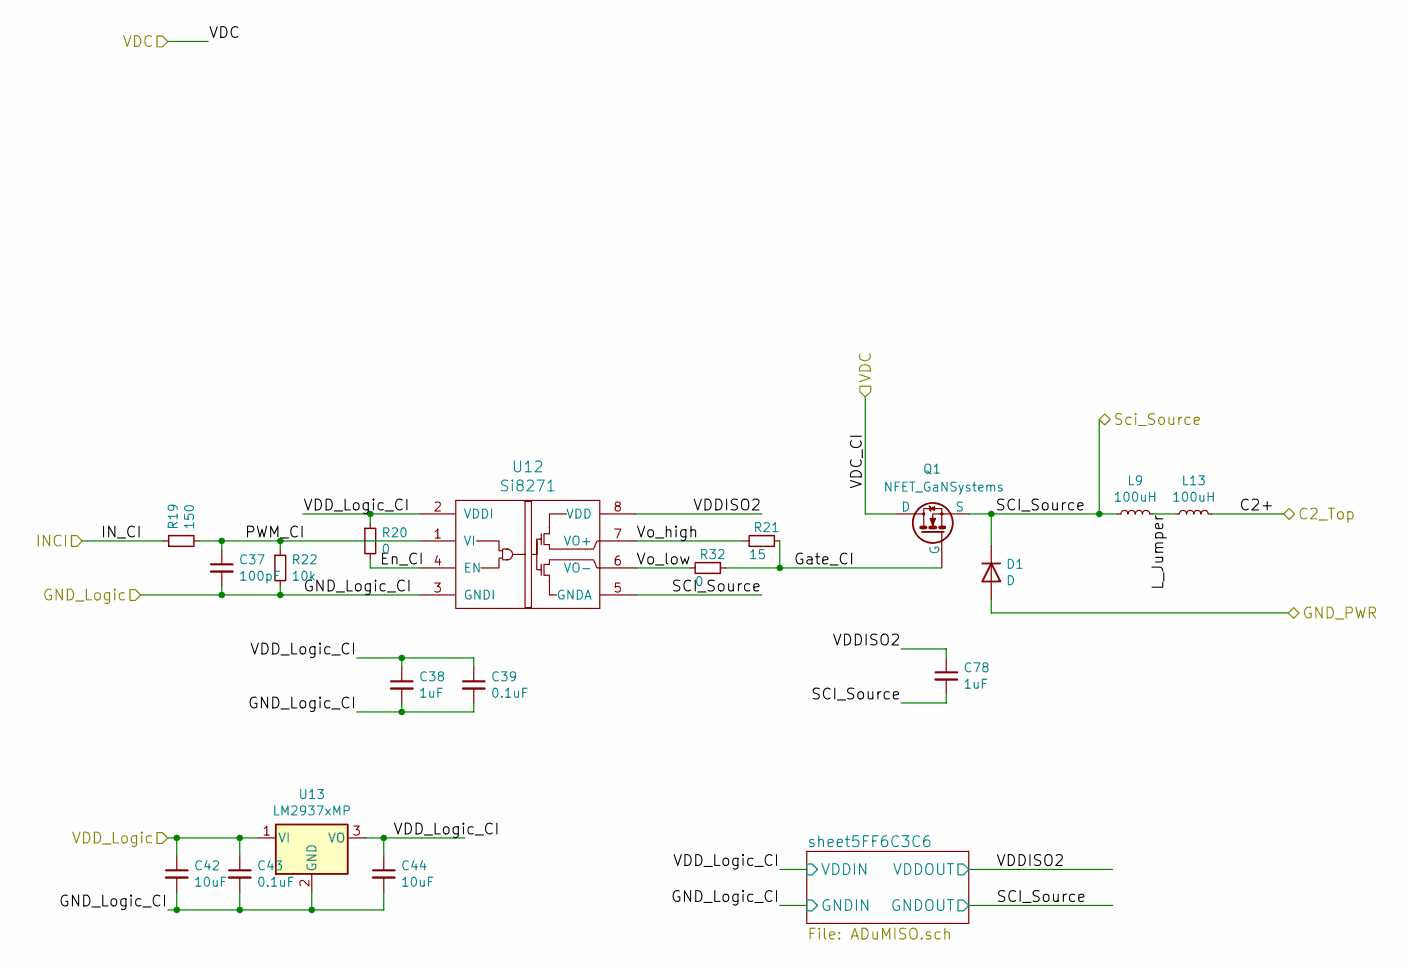
[picture p368: schematic ChargeInjection.sch]

Parts:
C37: 100pF; C_0402
C38: 1uF; C_0402
C39: 0.1uF; C_0402
C42, C44: 10uF; C_1206
C43: 0.1uF; C_1206
C78: 1uF; C_0603
D1: D; D_SMB
L9: 100uH; MSS1210
L13: 100uH; XAL7070
Q1: NFET_GaNSystems; GS66506T
R19: 150; R_0402
R20, R32: 0; R_0402
R21: 15; R_0402
R22: 10k; R_0402
U12: Si8271; SOIC-8
U13: LM2937xMP; SOT223-4

Connections:
6V5: C42.1, C43.1, U13.1 (VI); also elsewhere on the board
/C2+: L13.2; also elsewhere on the board
/CI/En_CI: R20.2, U12.4 (EN)
/CI/Gate_CI: Q1.G, R21.1, R32.1
/CI/L_Jumper: L9.2, L13.1
/CI/PWM_CI: C37.1, R19.2, R22.1, U12.1 (VI)
/CI/VDDISO2: C78.1, U12.8 (VDD); also elsewhere on the board
/CI/VDD_Logic_CI: C38.1, C39.1, C44.1, R20.1, U12.2 (VDDI), U13.3 (VO); also elsewhere on the board
/CI/Vo_high: R21.2, U12.7 (VO+)
/CI/Vo_low: R32.2, U12.6 (VO-)
/INCI: R19.1; also elsewhere on the board
/Sci_Source: C78.2, D1.1 (K), L9.1, Q1.S, U12.5 (GNDA); also elsewhere on the board
/VDC: Q1.D; also elsewhere on the board
GND: C37.2, C38.2, C39.2, C42.2, C43.2, C44.2, R22.2, U12.3 (GNDI), U13.2 (GND); also elsewhere on the board
GNDPWR: D1.2 (A); also elsewhere on the board

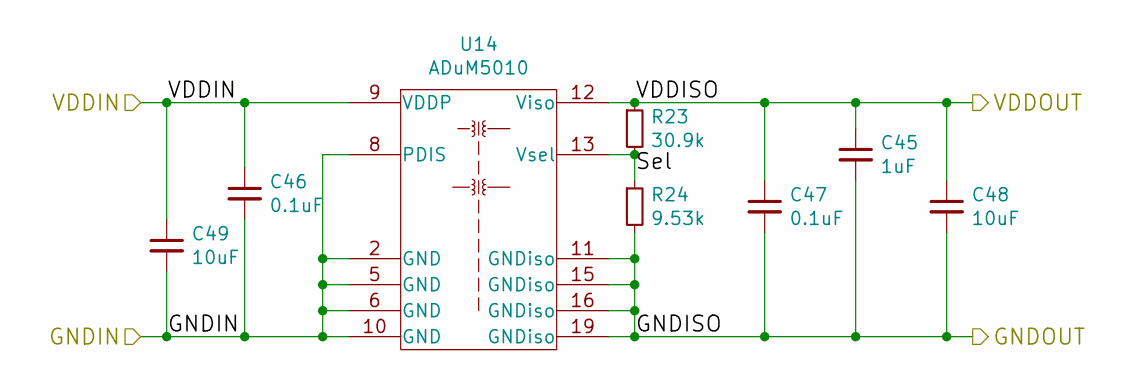
[picture p369: schematic ADuMISO.sch]

Parts:
C32: 1uF; C_0603
C33, C34: 0.1uF; C_0603
C35, C36: 10uF; C_1206
R17: 30.9k; R_0402
R18: 9.53k; R_0402
U11: ADuM5010; SSOP-20_Wide

Connections:
/C2-: C32.2, C34.2, C35.2, R18.2, U11.11 (GNDiso), U11.15 (GNDiso), U11.16 (GNDiso), U11.19 (GNDiso); also elsewhere on the board
/SSB/ISODCDC/Sel: R17.2, R18.1, U11.13 (Vsel)
/SSB/VDDISO1: C32.1, C34.1, C35.1, R17.1, U11.12 (Viso); also elsewhere on the board
/SSB/VDD_Logic_FB: C33.1, C36.1, U11.9 (VDDP); also elsewhere on the board
GND: C33.2, C36.2, U11.2 (GND), U11.5 (GND), U11.6 (GND), U11.8 (PDIS), U11.10 (GND); also elsewhere on the board

Parts of its further copies:
C45: 1uF; C_0603
C46, C47: 0.1uF; C_0603
C48, C49: 10uF; C_1206
R23: 30.9k; R_0402
R24: 9.53k; R_0402
U14: ADuM5010; SSOP-20_Wide

Connections of its further copies:
/CI/VDDISO2: C45.1, C47.1, C48.1, R23.1, U14.12 (Viso); also elsewhere on the board
/CI/VDD_Logic_CI: C46.1, C49.1, U14.9 (VDDP); also elsewhere on the board
/CI/sheet5FF6C3C6/Sel: R23.2, R24.1, U14.13 (Vsel)
/Sci_Source: C45.2, C47.2, C48.2, R24.2, U14.11 (GNDiso), U14.15 (GNDiso), U14.16 (GNDiso), U14.19 (GNDiso); also elsewhere on the board
GND: C46.2, C49.2, U14.2 (GND), U14.5 (GND), U14.6 (GND), U14.8 (PDIS), U14.10 (GND); also elsewhere on the board

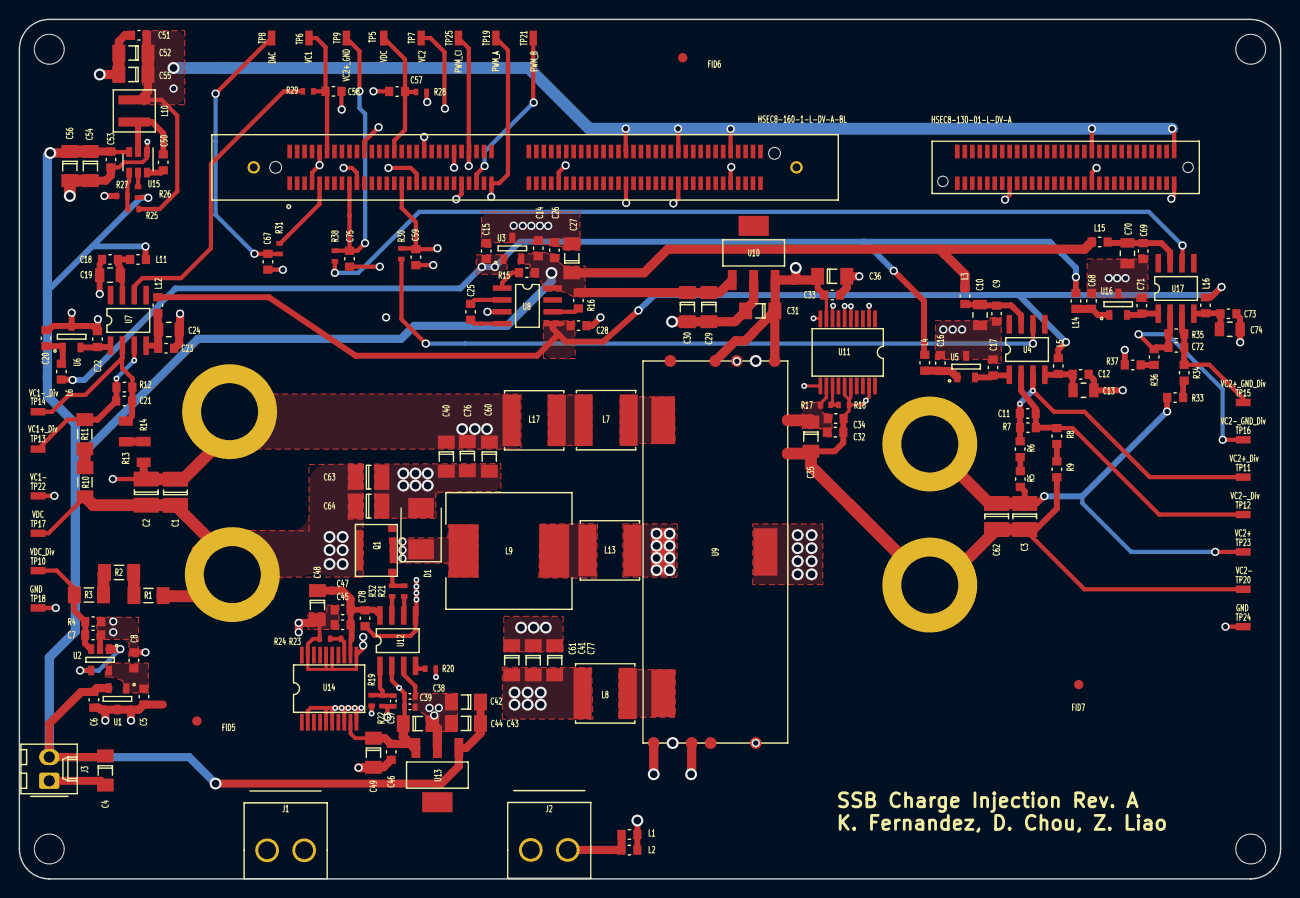
[picture p370: board UnfolderBuffer.kicad_pcb from above]

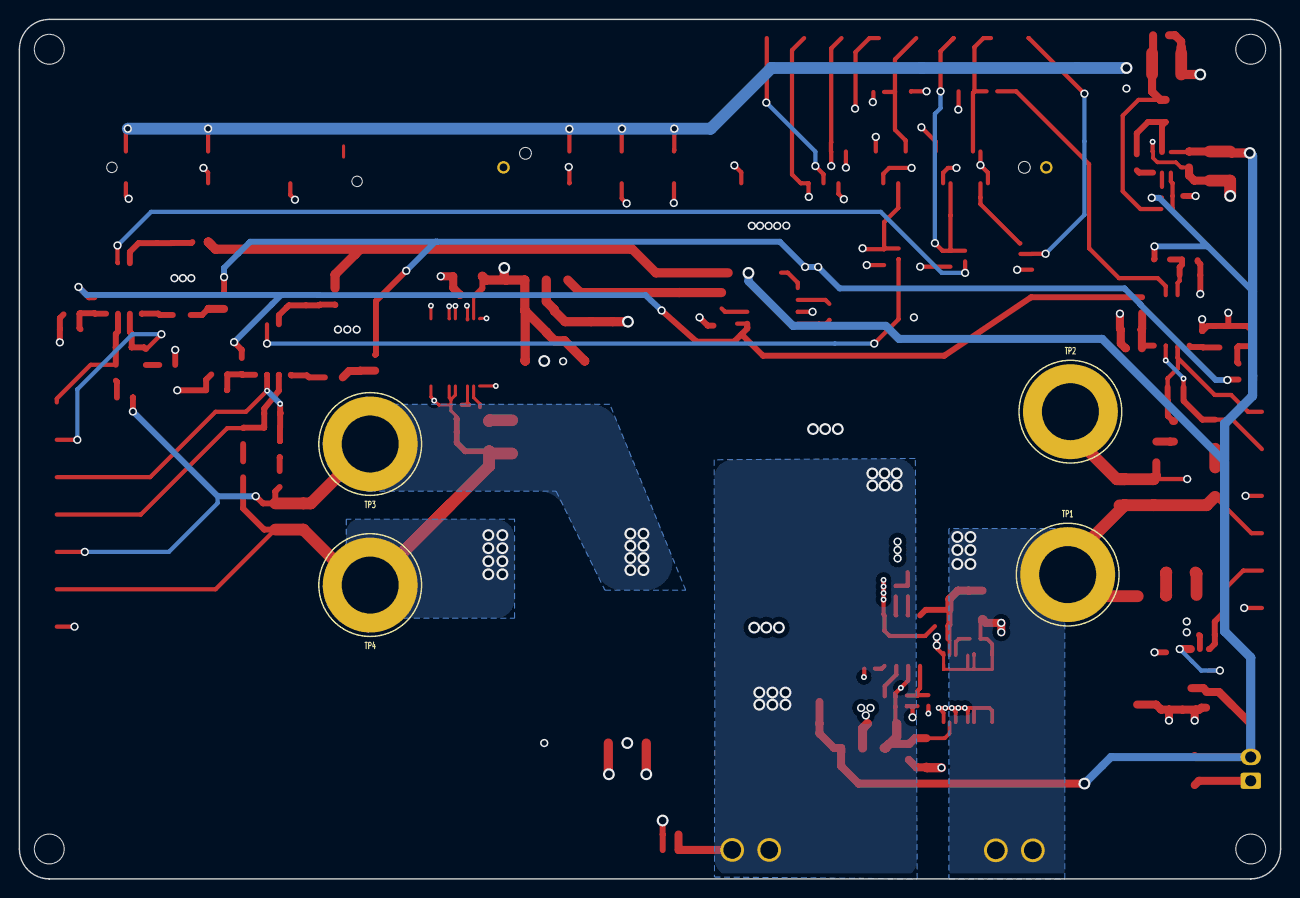
[picture p371: board UnfolderBuffer.kicad_pcb from below]

Board: 4 copper layers, 135.0 x 92.0 mm, 187 parts (4 on the bottom side), 75 nets.
