kefernandez/SSB_ChargeInjection/Buffer/Test Project/Test Project.kicad_pcb

## KiCad design Buffer/Test Project/Test Project.kicad_pcb (2021-04-21)

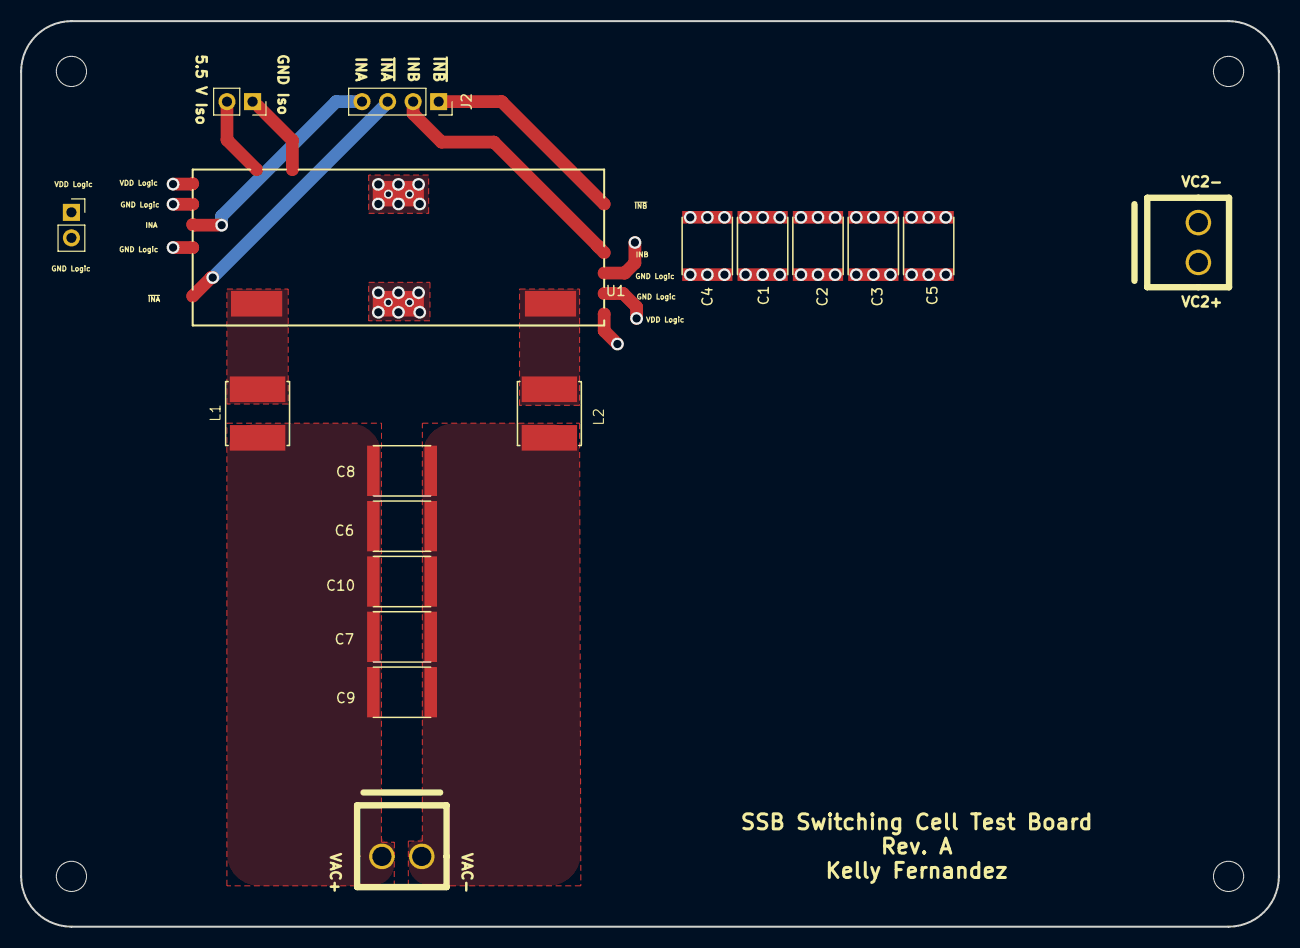
[picture p376: board Test Project.kicad_pcb from above]

Board: 4 copper layers, 125.0 x 90.0 mm, 18 parts (0 on the bottom side), 14 nets.

Parts:
C1, C2, C3, C4, C5, C6, C7, C8, C9, C10: C; C_2220_Sm
J1, J4: Conn_01x02; MTA156_2pin
J2: Conn_01x04; PinSocket_1x04_P2.54mm_Vertical
J3, J5: Conn_01x02; PinSocket_1x02_P2.54mm_Vertical
L1, L2: L; XAL7070
U1: FullBridgeCell; Buffer Full Bridge

Connections:
/CF_Neg: L2.2, U1.9
/GND_ISO: J5.1, U1.13
/GND_Logic: J3.2, U1.6, U1.7
/INA: J2.4, U1.2
/INB: J2.2, U1.5
/LC1_Pos: L1.1, U1.8
/VAC_Neg: C6.2, C7.2, C8.2, C9.2, C10.2, J1.2, L2.1
/VAC_Pos: C6.1, C7.1, C8.1, C9.1, C10.1, J1.1, L1.2
/VC2_Neg: C1.2, C2.2, C3.2, C4.2, C5.2, J4.2, U1.11
/VC2_Pos: C1.1, C2.1, C3.1, C4.1, C5.1, J4.1, U1.10
/VDD_ISO: J5.2, U1.12
/VDD_Logic: J3.1, U1.1
/~INA: J2.3, U1.3
/~INB: J2.1, U1.4
