kefernandez/SSB_ChargeInjection/(commit log)

2021-04-21 Uploaded all charge injection documents
    Placed all of my local charge injection documents into the git repo
    [AD_SSOP-20_RS-20.STEP, ADuMISO.sch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]
2021-05-25 Updated schematic
    Updated schematic/layout with resistor and cap values
    [ADuMISO.sch, ChargeInjection.sch, ChargeInjection_BOM.xlsx, DualHVSense.sch, F28379_Connector.sch, SSB.sch, SingleHVSense.sch, UnfolderAsm.sch]
2021-07-21 Data from lab
    Uploading scope images from the data collected in lab
    [IntegraVision_1.csv, IntegraVision_10.csv, IntegraVision_11.csv, IntegraVision_12.csv, IntegraVision_13.csv, IntegraVision_14.csv, IntegraVision_15.csv, IntegraVision_16.csv]
2022-12-01 updated pcb and test results and graphics
    All relevant files up to charge injection journal
    [Buffer - Rev D-B.Cu.gbr, Buffer - Rev D-B.Mask.gbr, Buffer - Rev D-B.SilkS.gbr, Buffer - Rev D-B_Cu.gbr, Buffer - Rev D-B_Mask.gbr, Buffer - Rev D-B_SilkS.gbr, Buffer - Rev D-Edge.Cuts.gbr, Buffer - Rev D-Edge_Cuts.gbr]
2022-12-01 Simulations
    Added simulation files from harddrive
    [Boost_model_dbuV.csv, Boost_original_dbuV.csv, Boost_switch_data.csv, Buck_EMI_regular.csv, Is1_neg_overlap.csv, Is1_pos_overlap.csv, Is2_neg_overlap.csv, Is2_pos_overlap.csv]
2022-12-01 Graphics, code
    adding updated code and graphics
    [Is1_neg_overlap.csv, Is1_pos_overlap.csv, Is2_neg_overlap.csv, Is2_pos_overlap.csv, Is3_neg_overlap.csv, Is3_pos_overlap.csv, Is4_neg_overlap.csv, Is4_pos_overlap.csv]
